sheepxray/1145141919810wulongjiadao/README.md

# 智能车光电象棋对抗 — 乌龙驾到（设计与开发仓库）

第十五届全国大学生光电设计竞赛 · 赛题 1

> **官方节奏（2026-10-12 校赛动员，宣讲口径）**：常规为 **3 月校赛、4 月区赛、5 月国赛**。
> 本仓库的 `09-28 -> 11-22` 是内部第一阶段和 MVP 周期，不是校赛总周期。
> 提交材料、评分和官方节点见 [20 校赛动员纪要](docs/20-竞赛校赛动员与官方节点_20261012.md)。

> 🚨 **平台已裁决（2026-09-28）**：当前方案按实际采购落实为
> **麦轮全向 + K230D + 单 OV5640 + STM32G474 + TB6612**。
> 仓库早期的「差速 + RK3588 + 双 IMX219 + H723 + BTS7960」方案已归档为下面的
> [历史五轮档案](#历史五轮档案旧平台已归档)，不再作为当前方案。

---

## 一句话方案

一台 **全向底盘（60mm 麦轮 ×4 + 4×MG513X 电机）** 智能车，前装 **盒式推板（带侧裙）**，
用 **单支 OV5640 前视相机** 做搜索与读字，由 **庐山派 Lite-K230D(128M) 视觉平台**
与 **STM32G474VET6 运动主控** 双核协同，全程自主完成
“搜索 → 识别字符 → 计算优先级 → 两段式接近 → 闭环/开环推入 → 撞墙重定位”。

---

## 关键指标（实际采购口径）

| 项目 | 当前值 | 限值 | 状态 |
|---|---|---|---|
| 实付成本 | **¥751.01** | ¥2000 | ✅ 余量 ¥1248.99 |
| 总质量 | ⚠️ 待实测（**电机已占 680 g**） | 1500 g | 🔴 逼近上限，先称重 |
| 外廓 | ⚠️ 待机械重构 | 250×200×180 | 麦轮底盘 10-14 前重定 |
| 车速 | 额定点 **0.94 m/s**（空载 1.16） | 目标 0.8 m/s | ✅ 有余量，PWM 限速 [17 校核](docs/17-实际电机参数核对.md) |

依据：[08 BOM](docs/08-BOM物料清单.md) / [16 商品清单](docs/16-最终商品清单.md) / [17 电机参数](docs/17-实际电机参数核对.md)。

---

## 近端硬节点（完整排期见 docs/10）

| 🔴 节点 | 时间 | 交付 |
|---|---|---|
| 初代底板到货 | 10-01 | 装配成可通电初代底盘 |
| 动力系统 + 视觉模块验证 | 10-07 前 | 四轮可控 + 全向移动；单相机出图 + 初始标定 |
| 第二版底盘 + 顶部相机方案 | 10-14 前 | 3D 模型 / 图纸 + 顶部相机安装方案 |

---

## 团队约束

| 约束 | 取值 |
|---|---|
| 加工条件 | 只有 3D 打印 |
| 预算 | ≤ ¥2000（实付 ¥751.01） |
| 内部 MVP 时间 | ≈ 8 周（09-28 → 11-22） |
| 官方赛事节奏 | 3 月校赛、4 月区赛、5 月国赛；具体日期以官方通知为准 |

---

## 硬件清单（已购，精简版）

| 类别 | 已购 | 备注 |
|---|---|---|
| 电机 | MG513X 12V 13 线霍尔编码器 ×4 | **1:28**，370rpm 空载 / 300rpm 额定，**0.17kg/台** |
| 驱动 | TB6612 四路带稳压（**D24A**） | ⚠️ 额定工况有余量；堵转发热是主要风险，见 17 §4.3 |
| 主控 | STM32G474VET6 | 高分辨率定时器 |
| 视觉 | 庐山派 Lite-K230D-CanMV 128M | — |
| 相机 | OV5640 自动对焦 ×1 | 仅 1 支，无下视相机 |
| 轮组 | 60mm 麦克纳姆轮 ×4 + 联轴器 | — |
| 电源 | 3S 2600mAh 锂电组 + DC-DC | 电池待发货 |

后置补购（见 [16 §3](docs/16-最终商品清单.md) / [10 §0](docs/10-开发计划与里程碑.md)）：
**激光 ≤1mW、IMU ICM-20602、下视相机**、电源保护件、结构五金。

---

## 已确认仍有效的设计结论

1. 贴墙容错窗口与**车宽无关**，只取决于“窄车体 + 宽推板 + 悬伸”
   （[00 判断三](docs/00-赛题解读与关键结论.md)）。
2. 挡板测距 `d=H·f/Δy` **不能无条件用**；俯角≠0 时误差可达 17.3% → 用完整投影数值反解
   （[00 §3](docs/00-赛题解读与关键结论.md)、`tools/geometry.py`）。
3. 读字优先级要用**期望值**而非 argmax（[15](docs/15-字符识别与优先级算法.md)）。
4. 实际硬件是 **4×MG513X（1:28）+ TB6612 四路（D24A）**，车速 0.94 m/s 高于 0.8 m/s 目标；
   **最大风险是四路堵转把 TB6612 推到热保护**（3.2 A 档两片合计 20.5 W），
   处置是堵转降 PWM/限流（[17](docs/17-实际电机参数核对.md) §4.3）。

---

## 历史五轮档案（旧平台，已归档）

| 轮次 | 主题 | 核心发现 | 当前状态 |
|---|---|---|---|
| 1 | [06 电源与电流](docs/06-电源系统.md) | 旧电机堵转 86s 烧毁，需限流 | ⚠️ 电机参数已换，见 17 |
| 2 | [13 主控与算力](docs/13-主控与算力平台.md) | 瓶颈在视觉平台 CPU（非 NPU） | 🗄️ 旧平台 RK3588 |
| 3 | [14 1080p 视觉](docs/14-1080p视觉管线.md) | 降采样用 RGA 硬件 | 🗄️ 旧平台 |
| 4 | [15 字符识别](docs/15-字符识别与优先级算法.md) | 用期望值而非 argmax | ✅ 方法仍有效 |
| 5 | [16 最终清单（已修订）](docs/16-最终商品清单.md) | 相机立柱总高漏算 | ✅ 现为实际采购口径 |

---

## 文档索引

| 文档 | 内容 | 状态 |
|---|---|---|
| [00 赛题解读](docs/00-赛题解读与关键结论.md) | 规则拆解、硬约束、几何结论 | ✅ 判断二已裁决为麦轮 |
| [01 总体方案](docs/01-总体方案.md) | 系统架构、选型论证 | 🗄️ 旧平台，需回写 |
| [02 机械系统](docs/02-机械系统设计.md) | 车架、推板、相机立柱 | 🗄️ 旧平台，10-14 回写 |
| [03 电控与驱动](docs/03-电控与驱动系统.md) | 主控、电机、驱动、控制环 | 🗄️ 旧选型 |
| [04 视觉识别](docs/04-视觉识别系统.md) | 相机选型、颜色预筛、CNN | 🗄️ 旧平台 |
| [05 定位导航](docs/05-定位与导航.md) | 投影几何、分层定位 | 🗄️ 部分结论仍有效 |
| [06 电源系统](docs/06-电源系统.md) | R1 电流预算、堵转限流 | 🗄️ 被 17 取代 |
| [07 软件架构](docs/07-软件架构与决策策略.md) | 状态机、打分函数 | ✅ 平台无关，基本沿用 |
| [08 BOM](docs/08-BOM物料清单.md) | 实际采购清单 | ✅ 当前权威 |
| [09 待确认与风险](docs/09-待确认事项与风险.md) | 规则模糊点、Q1–Q10 | ✅ 开工前必读 |
| [10 开发计划](docs/10-开发计划与里程碑.md) | 8 周排期、三节点 | ✅ 当前权威 |
| [11 通信协议](docs/11-通信协议.md) | K230↔STM32 帧格式 | ✅ 骨架沿用，硬件名按 kit |
| [12 帧率与实时性](docs/12-帧率与实时性.md) | 30 FPS 方法论 | 🗄️ 部分被 14 取代 |
| [13 主控算力](docs/13-主控与算力平台.md) | R2 CPU vs NPU | 🗄️ 旧平台 |
| [14 1080p 管线](docs/14-1080p视觉管线.md) | R3 视觉管线 | 🗄️ 旧平台 |
| [15 字符识别](docs/15-字符识别与优先级算法.md) | R4 期望值优先级 | ⚠️ 方法仍有效 |
| [16 商品清单](docs/16-最终商品清单.md) | 实际下单 + 历史差异 | ✅ 当前权威 |
| [17 电机参数](docs/17-实际电机参数核对.md) | MG513X + TB6612 参数核对与风险 | ✅ 当前权威 |
| [TB6612/MG513X 规格](../hardware/electrical/TB6612_MG513X_规格.md) | 驱动与电机规格（唯一权威口径） | ✅ 当前权威 |
| [18 采购记录](docs/18-采购记录_20260928.md) | 淘宝采购流水 | ✅ 当前 |
| [19 比赛完整算法方案](docs/19-比赛完整算法方案.md) | 感知、控制、决策与固件落地 | ✅ 当前 |
| [20 校赛动员纪要](docs/20-竞赛校赛动员与官方节点_20261012.md) | 官方节点、提交材料、评分与扣分项 | ✅ 2026-10-12 新增 |
| [tools/](tools/) | 校核脚本（可运行） | — |
| [hardware/](hardware/) | 模型、接口定义 | — |
| [firmware/](firmware/) | 主控/视觉端代码 | — |

---

## 在线文档站点

文档已做成静态站点，由 GitHub Actions 自动构建部署。

> ⚠️ 站点首次发布前仍须**手动启用 Pages**：`Settings → Pages → Source 选 GitHub Actions`。
> 启用后重跑 workflow（或再 push 一次）即可。

启用后的访问地址：**https://sheepxray.github.io/1145141919810wulongjiadao/**

本地构建与预览：

```bash
python tools/build_site.py            # 构建到 site/
python tools/build_site.py --serve    # 构建并本地预览
python tools/build_site.py --check    # 只做校验（链接 + 内容完整性）
```

站点共 **25 个页面**（21 篇文档 + 首页 + 工具页 + 2 个器件资料页）。

---

## 工具（可运行，带自测）

```bash
python tools/drive_check.py           # ★ 驱动校核：4×MG513X + TB6612（权威）
python tools/motor_consistency.py     # ★ 手册参数一致性核对（线性模型）
python tools/power_budget.py          # 电源/电流/堵转/限流（旧 2 电机差速，历史档案）
python tools/compute_budget.py        # 主控算力（第 2 轮，旧平台）
python tools/vision_pipeline.py       # 1080p 管线（第 3 轮，旧平台）
python tools/piece_value.py           # 期望值/优先级（方法仍有效）
python tools/sketchup_model.py        # 差速底盘 SketchUp 生成器（麦轮模型待 10-14 重建）
python tools/geometry.py              # 相机几何校核（判断三、测距）
python tools/mass_budget.py           # 质量与预算（实际采购后需用 16 重算）
python tools/framerate.py             # 帧率方法论
python tools/protocol.py              # 通信协议 + 自测
python firmware/stm32/reference/kinematics.py   # 运动学/PID/航迹推算
python firmware/stm32/reference/scoring.py      # 目标打分函数
```

---

## 立刻要做的三件事

1. **10-01 初代底板到货** → 开箱核检（孔位/平整度）+ 装配成可通电底盘（[10 §2.1](docs/10-开发计划与里程碑.md)）。
2. **10-07 前** 动力系统验证 + 视觉模块验证（[10 §2.2/2.3](docs/10-开发计划与里程碑.md)）。
3. **10-14 前** 第二版底盘设计 + 顶部摄像机模块放置方案（[10 §2.4](docs/10-开发计划与里程碑.md)）。

> 规则模糊点 [09 待确认](docs/09-待确认事项与风险.md) 中 **Q1 / Q2 / Q9** 仍须优先书面确认。

---

## 状态

- [x] 平台裁决完成：采纳实际 kit（麦轮 + K230D + 单 OV5640 + G474 + TB6612）
- [x] 开发计划三家节点写入 [docs/10](docs/10-开发计划与里程碑.md)
- [x] 2026-10-12 校赛动员材料已归档，官方节点、提交材料和评分要求写入 [docs/20](docs/20-竞赛校赛动员与官方节点_20261012.md)
- [x] README 与 docs/00–15 已按实际方案统一（旧平台标注为历史档案）
- [x] 实际采购清单与采购记录（[16](docs/16-最终商品清单.md) / [18](docs/18-采购记录_20260928.md)）
- [ ] 10-01 初代底板到货核检
- [ ] 10-07 前动力系统验证 + 视觉模块验证
- [ ] 10-14 前第二版底盘设计 + 顶部相机方案
- [ ] 规则模糊点闭环（09 Q1/Q2/Q9）
- [ ] 激光/IMU/下视相机按判据补购

---

## 提交历史

```
第1轮：电源与电流预算（电源先行）
第2轮：主控与算力平台（诊断瓶颈在CPU侧而非NPU侧）
第3轮：1080p@30 视觉管线
第4轮：字符识别与优先级算法
第5轮：SketchUp 模型 + 最终商品清单
2026-09-28：实际采购平台分叉（麦轮+K230D vs 差速+RK3588）
2026-09-28：平台裁决 + README/文档统一为实际 kit 方案
