sheepxray/1145141919810wulongjiadao/hardware/electrical/TB6612_MG513X_规格.md

# TB6612 四路驱动（D24A）× MG513X 电机 · 规格与核对

> **本文是这两种器件的唯一权威口径。** docs/03、docs/06、docs/17、
> `hardware/electrical/接口定义.md` 全部引用本文，不再各自维护参数副本。
>
> **资料来源**（三类，优先级从高到低）：
> 1. **官方原理图** `TB6612四路驱动稳压模块原理图_V1.1（D24A）.pdf`（WHEELTEC，2025-02-18 版）
> 2. **芯片原厂手册** `TB6612FNG芯片手册.pdf` / `RT8279.PDF` / `RT9013-33GB.PDF`
> 3. **随货手册 + 商品页截图**（数值口径，未经原理图交叉验证）
>
> **本地存档**（第三方资料，**不入 git**；路径相对**工作区根目录** `乌龙驾到\`）：
> - 资料包：`_本地存档_不入库\WHEELTEC_TB6612_资料_V3.2_2026.07.25\`
>   （原始 50 个文件 1.78 GB；已跳过 3 个视频共 1.66 GB，保留 47 个文件 120.8 MB）
> - 原始来源：`D:\BaiduNetdiskDownload\【WHEELTEC】TB6612电机驱动附送资料\..._V3.2_2026.07.25\`

---

## 0. 一句话结论

> **驱动：TB6612FNG 四路带稳压板 D24A（V1.1）。电机：MG513X 12V / 1:28 / 370rpm 空载。**
>
> - 车速：空载 **1.16 m/s**、额定点 **0.94 m/s**（60mm 麦轮），**比原 0.8 m/s 目标快约 18%**，
>   靠 PWM 限速即可，不是问题。
> - ⚠️ **最大的风险是「四路堵转把 TB6612 烧/热保护」** —— 3.2 A 读法下两片合计 **20.5 W**，
>   SOP24 封装不可能长期承受。板载 65 °C 保护只关 RT8279 那两路**对外实验电源**，
>   **不影响** STM32 / K230D 的供电轨（见 §4.3）。
> - ⚠️ **手册参数自身不自洽**（3.2A 堵转 ↔ 4.5 kgf·cm 堵转转矩差 2.2 倍），
>   必须实测定论。见 §3。

---

## 1. 电机 MG513X

### 1.1 权威参数（商品页）

| 项目 | **MG513X（本次采购）** | MG513XL（对照，未采购） |
|---|---|---|
| 编码器 | 霍尔编码器（高精度 GMR 可选） | 同左 |
| 减速比 | **1:28** | 1:28 |
| 额定电压 | **12 V** | 12 V |
| 额定电流 | **0.36 A** | 1 A |
| 堵转电流 | **3.2 A** ⚠️ 见 §3 | 6 A |
| 减速后空载转速 | **370 ± 12 rpm** | 同左 |
| 减速后额定转速 | **300 ± 12 rpm** | 同左 |
| 额定扭矩 | **1 kgf·cm** | 3 kgf·cm |
| 堵转扭矩 | **4.5 kgf·cm** ⚠️ 见 §3 | 15.4 kgf·cm |
| 功率 | **4 W** | 10 W |
| 重量 | **0.17 kg**（×4 = **0.68 kg**！） | 0.19 kg |

> ⚠️ **重量是最容易被忽略的一项**：4 台电机 = **680 g**，
> 而整车质量上限是 1500 g。电机一项就吃掉 **45%** 的质量预算，
> 见 [docs/16](../docs/16-最终商品清单.md) 质量表。

### 1.2 编码器与测速分辨率

| 项目 | 数值 | 来源 |
|---|---|---|
| 线数 | 13 线/相（采购记录口径） | 采购记录，**待实物确认** |
| 每输出轴转脉冲数（单相） | 13 × 28 = **364 P/r** | 计算 |
| 四倍频计数 | **1456 count/r** | 计算 |
| 距离分辨率（60mm 轮） | **0.129 mm/count** | 计算 |
| 单相脉冲频率 @370rpm | **2245 Hz** | 计算 |
| 四倍频频率 @370rpm | **8979 Hz** | 计算 |

> STM32G474 的 TIM 编码器模式 + 32 位计数器处理 9 kHz 毫无压力。
> 编码器供电 3.3–5 V，**上电前先用万用表确认 VCC/GND 线序**。

### 1.3 车速与负载能力（60mm 麦轮）

轮周长 = π × 0.060 = **0.1885 m**

| 状态 | 转速 | 单轮线速度 | 整车直行速度 |
|---|---|---|---|
| 空载 | 370 rpm | 1.162 m/s | **≈1.16 m/s** |
| 额定点 | 300 rpm | 0.942 m/s | **≈0.94 m/s** |

| 项目 | 每轮 | 四轮合计 |
|---|---|---|
| 额定扭矩 1 kgf·cm | 0.0981 N·m → 牵引力 3.27 N | **13.1 N**（1.5kg → 8.7 m/s²） |
| 堵转扭矩 4.5 kgf·cm | 0.441 N·m → 牵引力 14.7 N | **58.8 N** |
| 额定电流 0.36 A | 4.3 W | 1.44 A / **17.3 W** |
| 堵转电流 3.2 A | 38.4 W | 12.8 A / **153.6 W** |

> **牵引力远超需求**（平地 1.5kg 匀速只需不到 1 N）。
> 真正的限制是**摩擦极限**：四轮合计 58.8 N 远超轮胎抓地力，
> 所以正常工况下轮子会先打滑，而不是电机先堵转 —— 除非顶墙。

---

## 2. 驱动 TB6612 四路带稳压版（D24A）

### 2.1 权威参数

| 项目 | 数值 | 来源 |
|---|---|---|
| 产品型号 | **D24A**（四路带稳压）/ D153C（双路） | 商品页 |
| 尺寸 / 重量 | 50 × 50 mm / 19 g（含排针） | 商品页 |
| 驱动路数 | **4 路**（板载 **2 片 TB6612FNG**，每片 2 路） | 原理图 U8 / U2 |
| 单路持续电流 | **1.2 A** | 芯片手册 IOUT = 1.2 A (ave) |
| 单路峰值电流 | **3.2 A**（不可持续） | 芯片手册 IOUT = 3.2 A (peak) |
| VM 工作范围 | **2.5 – 13.5 V**（绝对最大 15 V） | 芯片手册 Recommended / Abs Max |
| 逻辑控制电压 | 3.3 – 5 V | 商品页 + 手册 |
| 控制信号 | **1 路 PWM + 2 路普通 IO / 电机** | 商品页 |
| PWM 频率 | 0 – 100 kHz（推荐 **10 kHz**） | 商品页 + 手册 |
| 输出低导通电阻 | 0.5 Ω（上下桥合计，典型 @VM≥5V） | 芯片手册 |
| 板载 5V 轨 | **RT8279**：5 A / 36 V / 500 kHz 同步降压 | 原理图 U1 + RT8279 手册 |
| 板载 3.3V 轨 | **RT9013-33GB**：500 mA LDO（5V→3.3V） | 原理图 U4 + RT9013 手册 |
| 对外供电能力 | 3.3 V（500 mA）、5 V（长时间 3 A / 瞬间 5 A） | 商品页 |
| 过温保护 | **整板 65 °C** 关断 RT8279 的使能 → 板载 5V/3.3V **对外输出**失电，冷却后恢复（不切 VM） | 原理图 + 手册 §2.3 |
| 电池电压采样 | 10k / 1k 分压 = **1/11**，可接 ADC | 手册 §2.3 + 原理图 R13/R15 |
| 保护（V1.1） | 反接保护（AP20P30Q）、输入 TVS（SMAJ15A）、3.3V TVS（SMBJ3.3A）、5V TVS（SMBJ5.0A）、控制信号 22 Ω 串阻 | 原理图 V1.1 |

> ⚠️ **反接保护存在版本差异**：原理图 **V1.1 有**反接保护电路（Q5 AP20P30Q），
> 但**随货手册仍写「本模块无防反接，反接必烧芯片」**——该手册是 V1.0 口径。
> 商品页列出的保护项含「输入电源防反接保护」，与 V1.1 一致。
> **以实物丝印为准**：板上有 "1.1" 丝印 = V1.1。核对方法见资料包
> `5.原理图\3.D24A四路驱动稳压模块\不同版本D24A区分方法.png`。
> ⚠️ **无论哪个版本，接线前一律断电。**

### 2.2 引脚与接线（D24A → STM32G474）

| 信号组 | 板端引脚 | 说明 |
|---|---|---|
| 使能 | `STBY` | **必须接 3.3V 或 5V**（板上可用跳线帽接 3V3），否则电机不转 |
| A 路 | `PWMA` / `AIN1` / `AIN2` | 1 路 PWM + 2 路 IO |
| B 路 | `PWMB` / `BIN1` / `BIN2` | 同上 |
| C 路 | `PWMC` / `CIN1` / `CIN2` | 同上 |
| D 路 | `PWMD` / `DIN1` / `DIN2` | 同上 |
| A 编码器 | `E1A` / `E1B` | 接 STM32 定时器编码器模式 |
| B 编码器 | `E2A` / `E2B` | 同上 |
| C 编码器 | `E3A` / `E3B` | 同上 |
| D 编码器 | `E4A` / `E4B` | 同上 |
| 电池电压 | `ADC` | 板内已 1/11 分压，直连 ADC 引脚即可 |
| 电源 | `Vin+` / `-`（J8） | **4.5–15 V**，本次用 3S（满电 12.6 V） |

> ✅ **2026-10-17 逐轮复核**：C、D 两路的电机插头与轮位**一一对应**
> （C 座接右后轮、D 座接右前轮）。2026-10-16 曾据编码器符号推断两者互换并让固件
> 对调，2026-10-17 用逐轮点动目视复核后**已撤销**，上表的对应关系现在与实物一致。
> 详见 [引脚分配表.md](../../firmware/stm32/wulong_fw/docs/引脚分配表.md)。

**真值表**（单路，来自芯片手册）：

| PWM | IN1 | IN2 | 结果 |
|---|---|---|---|
| 1 | 0 | 0 | 制动停止 |
| 1 | 1 | 0 | 正转 |
| 1 | 0 | 1 | 反转 |
| 1 | 1 | 1 | 制动停止 |
| 0 | × | × | 停止（滑行） |

### 2.3 板载电源树（原理图实测）

```
3S 电池 (Vin+ , J8)
  └─[电源开关 SW1]
     └─[反接保护 Q5 AP20P30Q]─[TVS SMAJ15A D5 / D4]
        ├─→ 电机 VM（2 片 TB6612FNG 的 VM1/VM2/VM3）
        │
        └─[RT8279 降压]─→ 5V 轨（板载 220µF ×2 输出储能）
             ├─→ 5V 对外输出（J1）
             ├─→ ★ 两片 TB6612FNG 的 VCC(20) 逻辑供电
             └─[RT9013 LDO]─→ 3.3V 轨（1µF/1µF）→ 3.3V 对外输出（J3）
```

> ⚠️ **与既有文档的口径差异**：docs/06 与 [接口定义](接口定义.md) 的三轨设计是
> **「动力直供 + 独立视觉 buck + 独立逻辑 DC-DC」**。
> D24A 额外提供 **5V（RT8279，5 A）与 3.3V（RT9013 LDO，500 mA）** 两路对外输出
> —— 那是**给用户做实验用的额外电源**，**不要求**用它给主控/视觉供电。
> 本项目按原三轨设计：**视觉走独立 buck，逻辑用 D24A 板载 3.3V**（见 §6.1）。

---

## 3. ★ 手册自身不自洽：必须实测定论

用直流电机线性模型（Kt = Ke）核对手册：

| 取信的一组 | 推算结果 | 与手册冲突 |
|---|---|---|
| 额定 300 rpm / 1 kgf·cm / 0.36 A（含 I₀=30 mA） | 空载 **386 rpm**、额定 **294 rpm**、绕组 **7.9 Ω**、堵转 **1.51 A** | 手册堵转电流写 **3.2 A**（差 **2.1×**） |
| 堵转转矩 4.5 kgf·cm + 堵转电流 3.2 A | Kt = 0.139 N·m/A、绕组 3.75 Ω → 空载转速应为 **823 rpm** | 手册空载写 **370 rpm**（差 **2.2×**） |

**结论**：`额定点三参数（300rpm / 1 kgf·cm / 0.36A）自洽`（功率 3.1 W ↔ 标称 4 W ✅），
**冲突集中在「堵转电流 3.2 A」与「堵转转矩 4.5 kgf·cm」二者不能同时成立。**

### 30 秒实测定论（替代旧 Q10）

以**保守侧（3.2 A）**做驱动余量设计，但必须实测：

1. **万用表量绕组电阻**（转子转多点取平均，避开换向器死区）
   - ≈ **7.9 Ω** → 堵转 ≈ **1.5 A**（读法 A）
   - ≈ 3.75 Ω → 堵转 ≈ 3.2 A（读法 B）
2. **堵转实测电流**：电源限流到 4 A，堵转读电流表，同时贴热电偶看温升。

> 不论哪个读法，**堵转电流都 > TB6612 持续 1.2 A**（读法 A 约 1.3 倍，读法 B 约 2.7 倍），
> 所以**堵转保护都必须做**。结论不被读数影响，只是保护阈值不同。

---

## 4. ★ 驱动裕度与热：D24A 的真实风险

### 4.1 电流裕度

| 工况 | 单路电流 | vs 持续 1.2 A | vs 峰值 3.2 A |
|---|---|---|---|
| 额定（四轮直行） | 0.36 A | ✅ 3.3× 余量 | ✅ |
| 加速/爬坡 | 0.5–1.0 A | ✅ | ✅ |
| 顶墙/顶棋子（堵转·读法 A） | ≈1.5 A | ⚠️ **超持续，未超峰值** | ✅ |
| 顶墙/顶棋子（堵转·读法 B） | 3.2 A | ❌ **超持续 2.7×** | ⚠️ **恰好顶到峰值** |

**四路同时堵转（最坏）**：读法 A ≈ **6.0 A / 72 W**，读法 B ≈ **12.8 A / 154 W**。

### 4.2 芯片自身发热

TB6612FNG 上下桥合计 RDS(on) ≈ 0.5 Ω，发热 = I²R：

| 单路电流 | 每路发热 | 每片芯片（2 路） | 两片合计 |
|---|---|---|---|
| 0.36 A（额定） | 0.065 W | 0.13 W | 0.26 W |
| 1.2 A（持续上限） | 0.72 W | 1.44 W | 2.88 W |
| 1.51 A（堵转·读法 A） | 1.14 W | 2.28 W | **4.56 W** |
| 3.2 A（堵转读法 B） | 5.12 W | 10.24 W | **20.5 W** |

> TB6612FNG 是 **SOP24 无散热焊盘**封装，靠引线散热。
> **7 W 以上不可能长期承受** → 会触发 **TB6612FNG 芯片自身的过温保护（TSD）**。

### 4.3 ★ 过温保护的**真实**作用范围（已核对原理图，修正早前的错误判断）

> 早前把这条写成「过温保护会切断 5V/3.3V 轨，连坐主控与视觉」——**这是错的**。
> 核对原理图后确认：**过温保护切断的是 RT8279 的使能，只关断板载 5V/3.3V
> 这两路「对外实验电源」，不会去切断 STM32 或 K230D 的供电轨。**

**原理图依据**：过温网络 `R3(6.8 kΩ NTC) + R4(10 k) + R5(0 Ω)` 生成 `P_EN`，
只接到 **RT8279(U1) 的 EN 脚**；RT9013(U4) 因 VIN 来自 5V，也随之失电。
两片 TB6612FNG 的 **VM（电机动力）与 VCC（内部逻辑）都不在此保护路径上**
—— VCC 直接取自 5V 输出节点。

**真正需要关心的失效模式是另一个**：

```
四路电机长时间堵转（顶墙推棋子）
   → 两片 TB6612FNG 发热（20.5 W @3.2 A/路）→ 芯片自身过温保护(TSD)
   → 若 VCC 那一路 5V 被 RT8279 过温关断（P_EN 拉低）
   → TB6612FNG 失去内部逻辑供电 → 输出级关断
   → 四轮同时失控滑行
```

> **关键结论**：风险从「主控/视觉被断电」变成「**TB6612 逻辑掉电导致输出关断**」，
> 两者都要求**堵转时必须压住发热**（堵转降 PWM / 限流）。
> 但**不需要**为了这条保护去改视觉供电 —— 视觉独立 buck 本来就与它无关。

---

## 5. 与既有文档的口径差异（需回写）

| 项目 | 旧口径 | **新口径（本文）** |
|---|---|---|
| 电机型号 | JGB37-520（差速，2 台） | **MG513X（麦轮，4 台）** |
| 减速比 | 1:100（docs/17 曾记） | **1:28** |
| 空载/额定转速 | 300 / 240 rpm | **370 / 300 rpm** |
| 额定/堵转电流 | 200 mA / 500 mA | **360 mA / 3.2 A（待实测）** |
| 额定/堵转转矩 | 0.5 / 4.0 kgf·cm | **1 / 4.5 kgf·cm** |
| 驱动 | BTS7960 ×2（43 A） | **TB6612FNG 四路 D24A（1.2 A / 3.2 A）** |
| 轮径 | φ65 橡胶轮 | **φ60 麦轮** |
| 车速 | 0.817 m/s | **0.94 m/s（额定）/ 1.16 m/s（空载）** |
| 稳压架构 | 三路独立 | **5V/3.3V 同板（3.3V 由 5V LDO 派生）** |
| 电机总重 | 未计 | **0.68 kg** |
| 过温保护 | 未考虑 | **65 °C 只关 RT8279 的 5V/3.3V 对外输出**（不切 VM / 不切 VCC 直连节点） |

---

## 6. 设计处置（待落到 docs/03、06、接口定义）

### 6.1 必须做（🔴）

1. **堵转保护**（软件，STM32 侧）：
   目标速度非零且实测速度 ≈ 0 持续 > 200 ms → **把 PWM 降到维持值（约 30%）**
   并上报决策层「已顶到位/受阻」。**不要直接停机**（顶墙推棋子是正常工况）。
2. **电源架构保持原设计**（已与实际接线一致，无需改动）：
   - **视觉**：K230D + 相机走**独立 buck**（与 D24A 的 RT8279 无关）
   - **逻辑**：STM32 / IMU 用 **D24A 板载 3.3V（RT9013，500 mA）**，负载仅 ≈105 mA，余量充足
   - **D24A 的 5V / 3.3V 对外输出**当作实验用备用轨，不接主控/视觉

   > 注意：过温保护只关 RT8279 的 EN，因此**视觉独立供电这条本来就不受影响**；
   > 但**逻辑轨取自 RT9013（其 VIN 来自 5V）会随之掉电** —— 若想连逻辑也免疫，
   > 可把 STM32 的 3.3V 改为**独立 LDO/buck**（可选，非必须）。
3. **控制信号 10 kHz PWM**（手册推荐值，避开音频与开关损耗区）。
4. **STBY 必须拉高**（跳线帽接 3V3 或由 STM32 GPIO 控制，推荐后者以便软急停）。

### 6.2 强烈建议（🟡）

5. **堵转限流**：如需长时间顶墙，用电流采样（INA240 或板载 VM 采样）把单路限到 ≈1.2 A。
6. **电机端子加 104 陶瓷电容**（有刷电机必做，抑制电刷噪声）—— 板上有 TVS 但没有电机端 RC。
7. **不要用满 12.6 V 长跑**：TB6612 VM 推荐上限 13.5 V，3S 满电 12.6 V 仅 0.9 V 余量；
   电机感性尖峰靠板载 TVS 吸收，但仍应避免「满电 + 四路同时换向」的最坏叠加。
8. **5V 带动 K230D 需实测**：板载 RT8279（5 A/500 kHz/电流模式）瞬态特性
   远好于旧文档批评的 MP1584/LM2596，**原则上可用，但要实测掉电**。

### 6.3 待实测清单（替代旧 Q10）

| # | 项目 | 方法 | 判据 |
|---|---|---|---|
| 1 | 电机绕组电阻 | 万用表，转子转多点 | **7.9 Ω 或 3.75 Ω** |
| 2 | 真实堵转电流 | 电源限流 4 A + 堵转 | 记录稳定值 |
| 3 | 编码器线数 | 输出轴手转 1 圈，数单相脉冲 | 应为 364 P/r |
| 4 | 驱动板温升 | 四路 1.2 A 连续 3 min，热电偶贴 TB6612 | 是否触碰 65°C |
| 5 | 板级保护行为 | 人为升温至 65 °C 以上 | 确认 **RT8279 的 5V/3.3V 对外输出**是否切断（不应影响 VM） |
| 6 | 5V 带 K230D | K230D 满载 + 电机换向 | 是否 brownout |
| 7 | 驱动板版本 | 看板上 "1.1" 丝印 | 决定有无反接保护 |

---

## 7. 资料索引

> 下表路径相对**工作区根目录** `C:\Users\sheep\Desktop\乌龙驾到\`（**不是**仓库目录）。

| 内容 | 本地路径 |
|---|---|
| 官方资料包（V3.2） | `_本地存档_不入库\WHEELTEC_TB6612_资料_V3.2_2026.07.25\` |
| D24A 原理图 V1.1 | `...\5.原理图\3.D24A四路驱动稳压模块\2.TB6612四路驱动稳压模块原理图_V1.1（D24A）.pdf` |
| 用户手册（含接线表） | `...\1.用户手册与使用教程\电机驱动模块使用手册—TB6612(2025.08.27).pdf` |
| 随货安全手册 | `...\TB6612稳压版随货手册.pdf` |
| 芯片手册 | `...\6.芯片手册\TB6612FNG芯片手册.pdf`、`RT8279.PDF`、`RT9013-33GB.PDF` |
| 接线图（四路 + 编码器） | `...\4.例程源码\1.STM32F1例程\3.D24A（四路驱动带稳压版）例程\D24A模块与STM32F103RCT6核心板接线说明.png` |
| STM32 例程（HAL + 标准库） | `...\4.例程源码\1.STM32F1例程\3.D24A（四路驱动带稳压版）例程\*.zip`（F1 平台，仅供移植参考） |
| 3D 模型（STP） | `...\7.3D模型\TB6612四路驱动稳压模块（D24A).stp` |
| 嘉立创封装 | `...\5.原理图\4.封装文件\D24A封装_2026-07-25.json` |
