sheepxray/1145141919810wulongjiadao/hardware/electrical/接口定义.md

# 电气接口定义

> ✅ **2026-09-28 重写**：按**实际到手硬件**改为
> **4×MG513X + TB6612 四路带稳压板（D24A）+ STM32G474VET6**。
> 电机/驱动参数权威口径见 [TB6612_MG513X_规格.md](TB6612_MG513X_规格.md)，
> 风险分析见 [docs/17](../../docs/17-实际电机参数核对.md)。
> ⚠️ **画完原理图必须用 STM32CubeMX 的引脚检查跑一遍** —— 4 路电机 + 4 路编码器极易冲突。

---

## 1. 连接器总览

| 连接器 | 类型 | 连接 | 线规 |
|---|---|---|---|
| J1 | XT60 | 3S 电池 → 主配电 | 18 AWG |
| J2 | 2P 螺丝端子 | D24A `Vin+ / -` → 主配电 | 18 AWG |
| J3 | 4P（板载） | 电机 A（Motor_A） | 20 AWG |
| J4 | 4P（板载） | 电机 B（Motor_B） | 20 AWG |
| J5 | 4P（板载） | 电机 C（Motor_C） | 20 AWG |
| J6 | 4P（板载） | 电机 D（Motor_D） | 20 AWG |
| J7 | 6P 排针（板载 J4/J6） | 电机 A/B 的编码器 + 控制信号 | 26 AWG |
| J8 | 6P 排针（板载 J4/J6） | 电机 C/D 的编码器 + 控制信号 | 26 AWG |
| J9 | 4P JST-XH | K230 → STM32 (UART) | 26 AWG |
| J10 | 8P JST-XH | IMU (SPI2) → STM32 | 26 AWG |
| J11 | 4P JST-XH | 调试串口 (USART1) | 26 AWG |
| J12 | 2P JST-XH | 相机 → K230 | 排线 |
| J13 | 3P JST-XH | 激光模组 | 26 AWG |

> **D24A 板载端子**（不需要自己做）：`Vin+/-`（J8）、4 组电机接口
> （每组 6P：2 路电机线 + 4 路编码器/控制）、`5V`/`3.3V`/`GND` 对外排针、
> `ADC` 电池电压输出。

> ✅ **2026-10-17 逐轮复核：座序与轮位一一对应。**
> 2026-10-16 曾根据"编码器符号翻转"推断 C、D 两个电机插头互换，并让固件把这两路
> 整体对调；2026-10-17 用**逐轮点动、目视哪一个角在转**的方法直接复核，证明那次
> 推断有误，固件里的对调**已撤销**。现在软件侧 `A=左前 B=左后 C=右后 D=右前`
> 与实物一一对应。完整对照表见
> [引脚分配表.md](../../firmware/stm32/wulong_fw/docs/引脚分配表.md) 的
> 「电机 / 编码器实际座序」。
>
> 重新插拔过电机线、或换过驱动板之后，必须用
> [电机Bring-up测试.md](../../firmware/stm32/wulong_fw/docs/电机Bring-up测试.md)
> **逐轮点动 + 目视**核对轮位——**编码器符号自洽不能替代目视**（方向线取反会同时
> 翻转电机极性和计数符号，两种设置都自洽）。
>
> 发现某轮"符号正常但实际倒转"时，用 `FLIP <轮号>` 整轮翻转（同时反方向线 + 反编码器），
> 详见该文档 §5.14。

---

## 2. STM32G474 引脚分配

> ✅ **2026-09-29 已用 CubeMX 校验**，与已编译通过的固件工程
> [`firmware/stm32/wulong_fw/`](../../firmware/stm32/wulong_fw/) 完全对齐。
> 权威口径见
> [STM32G474_TB6612_引脚规划.md](../../firmware/stm32/docs/STM32G474_TB6612_引脚规划.md)
> 与固件导出的 [引脚分配表.md](../../firmware/stm32/wulong_fw/docs/引脚分配表.md)。

### 2.1 电机驱动（D24A）

| 信号 | 引脚 | 外设 | 说明 |
|---|---|---|---|
| PWMA | PA8 | TIM1_CH1 | **10 kHz** |
| PWMB | PA9 | TIM1_CH2 | 10 kHz |
| PWMC | PA10 | TIM1_CH3 | 10 kHz ⚠️ |
| PWMD | PA11 | TIM1_CH4 | 10 kHz ⚠️ |
| AIN1 / AIN2 | PB0 / PB1 | GPIO | 方向 |
| BIN1 / BIN2 | **PE4 / PE5** | GPIO | 方向（PC4/PC5 已让位给调试串口） |
| CIN1 / CIN2 | PB10 / PB11 | GPIO | 方向 |
| DIN1 / DIN2 | PD2 / PC12 | GPIO | 方向 |
| **STBY** | PC6 | GPIO | **高电平使能；★ 软急停** |

> **STBY 必须为高**，否则 4 路全部不转。**推荐由 GPIO 控制**（而不是跳线帽常高），
> 这样堵转保护/急停能真正切断输出。

### 2.2 编码器（4 路正交解码）

| 信号 | 引脚 | 外设 |
|---|---|---|
| 编码器 A | PA0 / PA1 | TIM2_CH1/CH2 |
| 编码器 B | PA6 / PA7 | TIM3_CH1/CH2 |
| 编码器 C | PB6 / PB7 | TIM4_CH1/CH2 |
| 编码器 D | **PE2 / PE3** | TIM20_CH1/CH2 |

> ✅ **第 4 路已定死**：用 **TIM20（PE2/PE3，AF6）** 硬件正交解码，
> 比 GPIO 双沿中断 + 软件解码更省事也更稳。
> 注意不要用 TIM8：TIM8_CH1=PC6（已被 STBY 占用）、CH2=PC7（拨码占用）。

### 2.3 IMU（SPI2）

| 信号 | 引脚 |
|---|---|
| SCK | PB13 |
| MISO | PB14 |
| MOSI | PB15 |
| CS | PB12 |
| INT | **PB9**（原 PB3 与拨码第 4 路冲突，已改） |

> ⚠️ **修正记录**：原设计把 IMU 放在 SPI1（PA5/PA6/PA7），
> 但 **PA6/PA7 与 TIM3 编码器引脚冲突**。已改到 SPI2。

### 2.4 通信

| 信号 | 引脚 | 外设 | 说明 |
|---|---|---|---|
| K230 UART TX | PA2 | USART2_TX | 921600 |
| K230 UART RX | PA3 | USART2_RX | |
| 调试 TX | **PC4** | USART1_TX | **有线**，禁无线（原写 PA14，实为 SWCLK） |
| 调试 RX | **PC5** | USART1_RX | （原写 PA15） |

### 2.5 人机与监测

| 信号 | 引脚 | 说明 |
|---|---|---|
| 拨码开关 ×4 | PB4 / PB5 / PC7 / PB3 | 队伍编号 / 球门侧配置（DIP1-4） |
| 自检 LED | PC13 | 状态指示 |
| 蜂鸣器 | PB8 | 故障报警 |
| 电池电压 | PA4 | **ADC2_IN17** ← 接 D24A 的 `ADC` 引脚（板内已 1/11 分压） |
| SWD | PA13 / PA14 | 下载调试 |

> ⚠️ **电池采样接线变了**：D24A 板载 **10k/1k = 1/11 分压**，
> 直接接 STM32 的 ADC 引脚即可，**不需要**再自己搭分压网络。
> 量程：12.6 V → 1.15 V；9.0 V → 0.82 V。
> 若嫌 ADC 分辨率不足，可改用内部参考或自行加分压（但要复核耐压）。

---

## 3. 电源架构（★ 已按 D24A 实际情况修正）

### 3.1 三轨（保持原设计，与 D24A 的对外输出无关）

```
3S 电池 (XT60)
  ├─[主保险丝 15A，待实测]→ D24A Vin+  ─┬─ 4× MG513X 电机（VM）
  │                                     ├─ RT8279 → 5V ─┬─ TB6612FNG ×2 的 VCC(20)
  │                                     │               └─ RT9013 → 3.3V 对外（实验/备用）
  │
  └────────────────────→ 独立 DC-DC 5V ≥3A ── K230D + OV5640
```

| 轨 | 模块 | 输出 | 供给 |
|---|---|---|---|
| 动力 | 直供 | 11.1–12.6 V | D24A VM → 4 电机 |
| **视觉** | **独立 DC-DC** | **5 V ≥3 A** | **K230D、相机** |
| 逻辑 | D24A 板载 RT9013 | 3.3 V ≤500 mA | STM32、IMU、拨码 |

### 3.2 过温保护的实际作用范围（已核对原理图）

> 过温网络 `R3(6.8 kΩ NTC) + R4 + R5(0 Ω)` → `P_EN` → **只接 RT8279(U1) 的 EN 脚**。

**它关断的是 D24A 自己那两路「对外实验电源」（5V 及其派生的 3.3V），
不会去切断 VM（电机动力），也不会切断 K230D 的独立供电轨。**

```
四路电机长时间堵转 → 驱动板升温 → P_EN 拉低
  → RT8279 停止 → 板载 5V/3.3V 对外输出失电
  → ⚠️ 连带影响：TB6612FNG 的 VCC(20) 也取自这路 5V
     → 芯片失去内部逻辑供电 → 输出级关断 → 四轮失控滑行
  → 但 K230D（独立 buck）与视觉链路**不受影响**
```

> **结论**：视觉独立供电与这条保护**本来就无关**，无需为此改动；
> 真正的风险是 **TB6612 的 VCC 依赖板载 5V**，以及**堵转发热**本身。
> 处置仍是**堵转降 PWM / 限流**（见 [docs/03 §5](../../docs/03-电控与驱动系统.md)）。
> 可选加强项：把逻辑 3.3V 改为独立 LDO/buck，使 STM32 也完全免疫。

### 3.3 3.3V 轨的容量核对

| 负载 | 电流 |
|---|---|
| STM32G474 核心板 | ~80 mA |
| ICM-20602 IMU | ~5 mA |
| 拨码 / LED / 蜂鸣器 | ~20 mA |
| **合计** | **≈105 mA** |

> RT9013 提供 **500 mA**，余量 4.8 倍 ✅ 充足。
> ⚠️ 但**不要**把 K230D 的 3.3V 也接上来（K230D 由独立 5V 供电）。

### 3.4 接地（单点星型）

```
        ┌──────── 电池负极（星点）────────┐
        │          │          │           │
   D24A GND   独立buck GND  STM32 GND   IMU GND
```

**四路电机堵转电流合计可达 12.8 A（保守读数 3.2 A 档）**。
地线走成菊花链会让动力电流在信号地上产生压降。

---

## 4. 必装的滤波与保护元件

| 位置 | 元件 | 作用 |
|---|---|---|
| 电池输出 | **15 A 快断保险丝**（待实测调整） | 短路保护 |
| D24A 输入 | 板载 TVS（SMAJ15A）+ 反接保护（V1.1） | ✅ 已有 |
| D24A 输出 | 板载 220 µF ×2（每片驱动） | ✅ 已有 |
| **每个电机端子** | **104 陶瓷电容** | ⚠️ **板上没有，必须自己加**（有刷电机电刷噪声） |
| 视觉 buck 输入 | 470 µF + 铁氧体磁珠 | 隔离动力噪声 |
| 视觉 buck 输出 | 220 µF + 10 µF + 100 nF | K230D 本地储能 |
| 逻辑轨 | 10 µF + 100 nF | MCU / IMU 去耦 |
| 电池电压 ADC | 100 nF | 滤 PWM 噪声 |

> ⚠️ **电机端 RC 是唯一需要自己补的滤波**：D24A 板上有 TVS 和输出电容，
> 但**没有电机端子上的 104 电容**。有刷电机的电刷噪声只能靠它压住。

---

## 5. 线序定义

### 5.1 电机接口（板载 4P，J3–J6）

| Pin | 信号 |
|---|---|
| 1 / 2 | 电机 M+ / M− |
| 3 / 4 | （不同版本可能为编码器供电，**以板载丝印为准**） |

### 5.2 编码器 + 控制信号（板载 6P，J4/J6）

| Pin | 信号（A/B 侧） | 信号（C/D 侧） |
|---|---|---|
| 1 | PWMB / PWMA | PWMD / PWMC |
| 2 | BIN2 / BIN1 | DIN2 / DIN1 |
| 3 | E2B / E2A | E4B / E4A |
| 4 | E1B / E1A | E3B / E3A |
| 5 | AIN2 / AIN1 | CIN2 / CIN1 |
| 6 | STBY / 3V3 | STBY / 3V3 |

> ⚠️ **上表来自 WHEELTEC 官方接线图，请对照实物丝印核对后再焊线。**
> 参考图：`_本地存档_不入库\WHEELTEC_TB6612_资料_V3.2_2026.07.25\4.例程源码\1.STM32F1例程\3.D24A（四路驱动带稳压版）例程\D24A模块与STM32F103RCT6核心板接线说明.png`
>
> ✅ **本项目的 G474 对应标注图**：[D24A_STM32G474_接线标注.png](D24A_STM32G474_接线标注.png)
> （可编辑源文件：[D24A_STM32G474_接线标注.svg](D24A_STM32G474_接线标注.svg)）。
> 官方图是 STM32F103RCT6 示例，**只能参考 D24A 端针序，不能照抄 STM32 侧引脚**。
>
> ⚠️ **STBY 跳线帽必须拔掉**：本项目用 STM32 `PC6` 控制 D24A `STBY`。
> 若仍保留官方示例中 `3V3–STBY` 的跳线帽，`PC6` 输出低电平时会与 3.3V 直接冲突。

### 5.3 编码器上电前检查

| Pin | 信号 |
|---|---|
| VCC | 3.3–5 V |
| GND | GND |
| A 相 | 编码器输入 |
| B 相 | 编码器输入 |

> **上电前先用万用表确认 VCC/GND 线序** —— 编码器反接会烧霍尔元件。
> 验证方法：给电机通电让其转动，万用表测 GND 与 A/B 相之间电压，
> 正常应为 **1.6–1.8 V 的波动**（与转速无关）。

### 5.4 K230 串口（4P）

#### 40Pin 排针（Lite-K230D 已验证）

| 物理脚 | 信号 | 接到 STM32 |
|---|---|---|
| Pin 37 | GPIO32 / UART3_TXD → | **PA3**（USART2_RX） |
| Pin 40 | GPIO33 / UART3_RXD ← | **PA2**（USART2_TX） |
| Pin 39 | GND | GND（必须共地） |
| Pin 2 / 4 / 17 | 5V0 / 3V3 | **不接**（K230D 由独立 DC-DC 供电） |

#### GH1.25-4P 座（另一种引出）

| Pin | 信号 |
|---|---|
| 1 | 5V（**不要**用来给 STM32 供电） |
| 2 | RXD ← 接 STM32 的 **PA2**（USART2_TX） |
| 3 | TXD → 接 STM32 的 **PA3**（USART2_RX） |
| 4 | GND |

> ⚠️ **线序按立创庐山派 Lite-K230D 官方定义**（GH1.25-4P 座子丝印
> `5V / RXD / TXD / GND`），**不是**早前写的 `3.3V / GND / TX / RX`。
> 官方来源：立创开发板 wiki 的引脚查询工具数据层。
>
> - 40Pin 排针默认使用 UART3 = **GPIO32(TXD) / GPIO33(RXD)**（物理 Pin 37/40）
> - UART3 TX 必须显式启用 FPIOA `oe=1`，否则引脚可能不输出
> - 40Pin UART2 备选 = **GPIO05(TXD) / GPIO06(RXD)**（物理 Pin 11/13）
> - GH1.25-4P 座的 UART2 = **GPIO11(TXD) / GPIO12(RXD)**
> - 两种引出共用 UART2 控制器，但 FPIOA 引脚不同，不能同时接不同设备
> - **UART0（GPIO38/39）被系统 RT-Smart 占用作调试台，CanMV 固件下不可用**
> - TX/RX 交叉、**共地必须接**；IO 电平 3.3V
> - K230D 由独立 DC-DC 5V 供电，两边只连 GND（见 §3.1）

### 5.5 IMU（8P）

按模块丝印定义接线；`SDA/SDI` 是模块输入，SPI 模式下接 STM32 的 MOSI：

| Pin | 模块丝印 | 接 STM32 | 说明 |
|---|---|---|---|
| 1 | VCC | 3.3V | 模块支持 3.3–5V，本项目统一用 3.3V |
| 2 | GND | GND | 必须与主控共地 |
| 3 | SCL/SPC | PB13 | SPI2_SCK |
| 4 | SDA/SDI | PB15 | SPI2_MOSI，主→从 |
| 5 | SA0/SDO | PB14 | SPI2_MISO，从→主 |
| 6 | CS | PB12 | 软件片选，拉低选中 |
| 7 | INT | PB9 | 中断，当前固件轮询读取 |
| 8 | FSY | GND | 未使用帧同步时接地，不要悬空 |

> ⚠️ `CS` 必须由上电时的 PB12 明确拉高/拉低控制；悬空可能让模块落到 I²C
> 模式。若 `WHO_AM_I`（寄存器 `0x75`）读不到 `0x12`，优先检查 `CS`、`SDO`
> 和 `FSY` 三根线。

### 5.6 激光（3P）

| Pin | 信号 |
|---|---|
| 1 | 5V |
| 2 | GND |
| 3 | 使能（可选） |

> 串联限流电阻，实测功率 **≤0.7 mW**。

---

## 6. 上电前检查清单

- [ ] 万用表测电池极性，确认无反接（⚠️ 早期版本无保护，V1.1 有）
- [ ] 确认 D24A 板版本（板上 "1.1" 丝印）
- [ ] 测板载 5V（±0.5 V）与 3.3V（±0.3 V）
- [ ] 确认 K230D 走独立 DC-DC（原设计如此，复核即可）
- [ ] 确认 4 路编码器 VCC/GND 线序
- [ ] 确认 STBY 已拉高（或已接 GPIO 并使能）
- [ ] 确认 PWM 频率设为 10 kHz
- [ ] **确认每个电机端子上焊了 104 电容**
- [ ] 确认电解电容极性
- [ ] 确认所有 GND 汇到星点
- [ ] **确认板上无任何无线模块**
- [ ] 整车称重 ≤ 1500 g（4 电机已占 680 g）
