sheepxray/1145141919810wulongjiadao/docs/03-电控与驱动系统.md

# 03 · 电控与驱动系统

> ✅ **2026-09-28 更新**：本文已按**实际到手硬件**回写：
> **麦轮全向（4×MG513X 1:28）+ STM32G474VET6 + TB6612 四路带稳压板（D24A）+ K230D + 单 OV5640**。
> 器件参数唯一权威口径见
> [hardware/electrical/TB6612_MG513X_规格.md](../hardware/electrical/TB6612_MG513X_规格.md)，
> 新旧口径差异与风险见 [docs/17](17-实际电机参数核对.md)。
> 本文保留的引脚冲突教训、控制环与堵转语义仍然有效。

---

## 1. 主控：STM32G474VET6

### 1.1 为什么是 G474

| 特性 | 对本任务的意义 |
|---|---|
| **硬件 FPU**（Cortex-M4F） | 四轮麦轮运动学 + 双环 PID + 航迹推算全用浮点 |
| 高级定时器（带死区） | 4 路 PWM（10 kHz）——本方案用有刷电机，死区留升级空间 |
| 通用/32 位定时器 | **4 路编码器正交解码** + 系统时基 |
| 12-bit ADC ×多通道 | 电池电压监测（可用驱动板板载 1/11 分压） |
| 170 MHz / 低分辨率损失 | 四路 9 kHz 编码器计数的余量很大 |

> ⚠️ **引脚资源核对**：4 路电机 = **4 PWM + 8 IO + 1 STBY**（共 13 脚），
> 4 路编码器 = **8 脚**，另有 IMU SPI（5）、K230 UART（2）、调试 UART（2）、
> 拨码（4）、LED/蜂鸣器（2）、ADC（1）。
> **本文件早期版本只规划了 2 路电机** —— 上表是旧差速方案遗留，
> 必须在 CubeMX 里按 4 路重新分配（见 §1.3）。

### 1.2 引脚分配（✅ 已经 CubeMX 校验）

> 2026-09-29：已用 CubeMX 生成并编译验证，与
> [`firmware/stm32/wulong_fw/`](../firmware/stm32/wulong_fw/) 完全对齐。

| 功能 | 引脚 | 外设 | 说明 |
|---|---|---|---|
| 电机 A PWM | PA8 | TIM1_CH1 | 10 kHz |
| 电机 B PWM | PA9 | TIM1_CH2 | 10 kHz |
| 电机 C PWM | PA10 | TIM1_CH3 | 10 kHz |
| 电机 D PWM | PA11 | TIM1_CH4 | 10 kHz |
| A 方向 | PB0 / PB1 | GPIO | AIN1 / AIN2 |
| B 方向 | **PE4 / PE5** | GPIO | BIN1 / BIN2（PC4/PC5 让位给调试串口） |
| C 方向 | PB10 / PB11 | GPIO | CIN1 / CIN2 |
| D 方向 | PD2 / PC12 | GPIO | DIN1 / DIN2 |
| **STBY 使能** | PC6 | GPIO | ★ 软急停，高电平使能 |
| 编码器 A | PA0 / PA1 | TIM2_CH1/CH2 | 正交解码 |
| 编码器 B | PA6 / PA7 | TIM3_CH1/CH2 | 正交解码 |
| 编码器 C | PB6 / PB7 | TIM4_CH1/CH2 | 正交解码 |
| 编码器 D | **PE2 / PE3** | TIM20_CH1/CH2 | 硬件正交解码 |
| IMU SPI2 | PB13/PB14/PB15 + PB12(CS) | SPI2 | ⚠️ 见 1.3 |
| K230 UART | PA2/PA3 | USART2 | 921600 |
| 调试 UART | **PC4/PC5** | USART1 | 仅有线，**禁止无线**（原写 PA14/PA15，PA14 是 SWCLK） |
| 拨码开关 | PB4 / PB5 / PC7 / PB3 | GPIO | 队伍编号/球门侧配置（DIP1-4） |
| 自检 LED | PC13 | GPIO | 状态指示 |
| 蜂鸣器 | PB8 | GPIO | 故障报警 |
| 电池电压 | PA4 | **ADC2_IN17** | 驱动板 ADC 引脚输出（已 1/11 分压） |

> ✅ **本表已用 CubeMX 校验**（2026-09-29），并据此生成编译通过的固件工程。
> 校验时发现并修正的 5 处：B 方向线 PC4/PC5 → PE4/PE5、第 4 路编码器从
> "PD12/PD13 待定" → TIM20(PE2/PE3)、调试串口 PA14/PA15 → PC4/PC5、
> 电池 ADC 外设 ADC1_IN4 → **ADC2_IN17**、IMU INT 从 PB3 让位给拨码。

### 1.3 ⚠️ 引脚冲突教训（保留）

早期版本把 IMU 放在 SPI1（PA5/PA6/PA7），与编码器 TIM3（PA6/PA7）**冲突**。

**修正**：IMU 改用 **SPI2**（PB13/PB14/PB15 + PB12 CS 控制片选）。

> 这类冲突在纸上很难看出来，**画完原理图必须用 STM32CubeMX 的引脚检查跑一遍**，
> 它会直接标红冲突。**4 路电机 + 4 路编码器会显著加剧这类冲突，务必先做引脚规划。**

---
## 2. 电机与驱动

### 2.1 电机：MG513X 12V （麦轮全向，4 台）

| 参数 | 取值 |
|---|---|
| 型号 | **MG513X** 有刷直流减速电机 |
| 额定电压 | **12 V** |
| 减速比 | **1:28** |
| 空载转速 | **370 ± 12 rpm** |
| 额定转速 | **300 ± 12 rpm** |
| 额定电流 / 堵转电流 | **0.36 A / 3.2 A**（⚠️ 堵转值待实测，见 docs/17 §3） |
| 额定转矩 / 堵转转矩 | **1 / 4.5 kgf·cm** |
| 编码器 | 霍尔，13 线/相 → **364 P/r 单相、1456 count/r 四倍频** |
| 单台重量 | **0.17 kg**（4 台 = **0.68 kg**） |

**车速核算**（φ60 麦轮，轮周长 0.1885 m）：

| 状态 | 转速 | 车速 |
|---|---|---|
| 空载 | 370 rpm | 1.16 m/s |
| 额定 | 300 rpm | **0.94 m/s** |

> 比 0.8 m/s 目标快 18%，**用 PWM 限速**，属于速度余量。

### 2.2 驱动：TB6612 四路带稳压板（D24A）

| 参数 | D24A（本次采购） | 说明 |
|---|---|---|
| 芯片 | **2 × TB6612FNG** | 每片 2 路，共 4 路 |
| 单路持续电流 | **1.2 A** | 芯片手册 IOUT(ave) |
| 单路峰值电流 | **3.2 A** | 芯片手册 IOUT(peak)，**不可持续** |
| VM 范围 | **2.5 – 13.5 V**（绝对最大 15 V） | 3S 满电 12.6 V，余量仅 0.9 V |
| 控制方式 | **1 路 PWM + 2 路 IO / 电机** | 共 4 PWM + 8 IO |
| PWM 频率 | **10 kHz**（手册推荐，范围 0–100 kHz） | |
| 使能 | **STBY**，必须拉高 | 推荐由 GPIO 控制以便软急停 |
| 板载稳压 | 5V = RT8279（5 A/500 kHz），3.3V = RT9013 LDO（500 mA） | |
| 过温保护 | **整板 65 °C 关断 RT8279 的对外 5V/3.3V** | 不切 VM；但 TB6612 的 VCC 取自此 5V，见 §2.4 |

### 2.3 接线

```
   3S LiPo (+) ──[主保险丝 ≥15A，待实测]──┬── D24A  Vin+  ── 4× MG513X
                                          │      │
                                          │      ├─ 板载 RT8279 → 5V  → 5V 对外
                                          │      │                    └→ RT9013 → 3.3V 对外
                                          │      │
                                          │      └─ 板载 1/11 分压 → ADC 引脚（电池监测）
                                          │
                                          └── 🔴 独立 DC-DC 5V ≥3A ── K230D + 相机
                                                 （★ 不从驱动板取，见 §2.4）

   所有 GND 单点汇流到电池负极（星型接地，见 docs/06）
```

**每路电机的控制信号**（真值表见规格文档 §2.2）：

| 路 | PWM | IN1 | IN2 | 编码器 |
|---|---|---|---|---|
| A | PWMA | AIN1 | AIN2 | E1A / E1B |
| B | PWMB | BIN1 | BIN2 | E2A / E2B |
| C | PWMC | CIN1 | CIN2 | E3A / E3B |
| D | PWMD | DIN1 | DIN2 | E4A / E4B |

> **与 BTS7960 的关键区别**：TB6612 **每个电机只需 1 路 PWM**（BTS7960 需要 2 路反向 PWM）。
> 不会直通，但 **PWM=0 时是滑行（coast）而非刹车**，
> 需要快速停车时用 **IN1=IN2=1 + PWM=1（制动）**。

### 2.4 ⚠️ 过温保护的作用范围（已按原理图核对）

> **更正**：早前写「65 °C 保护会切断 5V/3.3V 把主控与视觉一起断电」——**这是错的**。
> 过温网络 `R3(NTC)+R4+R5(0Ω)` → `P_EN` 只接 **RT8279 的 EN**，
> 关断的仅是 D24A 的**对外实验电源**，不切 VM，也不影响 K230D 的独立供电。

```
四路电机长时间堵转（顶墙推棋子）
  → 两片 TB6612FNG 发热（3.2 A 档合计 20.5 W）
  → 板温升高 → P_EN 拉低 → 板载 5V/3.3V 对外输出失电
  → ⚠️ TB6612 的 VCC(20) 正取自此 5V → 芯片逻辑掉电 → 输出级关断 → 四轮失控滑行
  → K230D / 视觉不受影响（独立 buck）
```

**处置**：

1. 🔴 **堵转降 PWM 保护**（§5）压住发热 —— 这是根本措施。
2. 🟡 视觉独立供电**原设计已满足**，复核接线即可。
3. 🟢 可选：把 STM32 的 3.3V 改独立 LDO/buck，让逻辑也完全免疫。
4. 实测板级保护行为：确认它只关对外输出、不影响 VM。

---
## 3. 控制环

### 3.1 双环结构（麦轮全向 · 当前方案）

```
    目标 (vx_cmd, vy_cmd, ω_cmd)
            │
    ┌───────┴──────────────────────┐
    │   麦轮运动学分解（4轮）        │  逆运动学
    │ ω1 = ( vx − vy − (a+b)ω ) / r │  r = 轮半径
    │ ω2 = ( vx + vy + (a+b)ω ) / r │  a,b = 半轴距/半轮距
    │ ω3 = ( vx + vy − (a+b)ω ) / r │
    │ ω4 = ( vx − vy + (a+b)ω ) / r │
    └───────┬──────────────────────┘
            │
    ┌───────┴────────┐
    │  速度环 PID     │  1 kHz
    │  ×4（每轮独立）  │  反馈 = 编码器
    └───────┬────────┘
            │
        PWM 20kHz ×4
```

> ⚠️ **与旧差速方案的关键区别**：
>
> | | 差速（旧） | 麦轮（当前） |
> |---|---|---|
> | 电机/PWM 路数 | 2 | **4** |
> | 运动学 | `v_L = v − ωB/2`、`v_R = v + ωB/2` | 上式 4 轮 |
> | 自由度 | 2（v, ω），**不能横移** | **3（vx, vy, ω），可横移** |
> | 速度环数量 | 2 | **4** |
>
> **G474 的定时器资源需按 4 路 PWM + 4 路编码器重新核对**
> （原文档按 2 路规划，见 §1.2 的引脚分配）。

### 3.1b 差速模型（旧方案，仅作对照）

```
    目标 (v_cmd, ω_cmd)
            │
    ┌───────┴────────┐
    │   运动学分解     │  差速模型
    │ v_L = v − ω·B/2 │  B = 轮距 150mm
    │ v_R = v + ω·B/2 │
    └───────┬────────┘
            │
    ┌───────┴────────┐
    │  速度环 PID     │  1 kHz（2 路）
    └───────┬────────┘
            │
          PWM 20kHz
```

**外层航向环**（500 Hz）：

```
    目标航向 θ_cmd  ──→ [+] ──→ PID ──→ ω_cmd
                        −│
                    IMU 航向 θ
```

### 3.2 参数起点

| 环 | 频率 | Kp | Ki | Kd | 说明 |
|---|---|---|---|---|---|
| 速度环 | 1 kHz | 0.8 | 0.35 | 0 | 输出为 PWM 占空比 |
| 航向环 | 500 Hz | 2.5 | 0 | 0.15 | 输出为 ω_cmd |

> 这些只是**起点**，必须实测整定。整定顺序：先速度环（让轮速跟随阶跃指令无超调），
> 再航向环（让原地转向无振荡）。

### 3.3 必须用编码器闭环，不能用开环 PWM

3S 电池从满电 12.6V 放到 9.0V，同一 PWM 下**轮速变化约 30%**。
开环 PWM 会让里程计和推程全部不准。**速度环是里程计可信的前提。**

---

## 4. IMU：ICM20602

### 4.1 为什么不用 MPU6050

| 指标 | ICM20602 | MPU6050 |
|---|---|---|
| 陀螺零偏稳定性 | 好 | 差 |
| 最高 ODR | 32 kHz | 8 kHz |
| 内置 DMP | 有 | 有 |
| 价格 | 约 ¥25 | 约 ¥10 |
| 市场风险 | 低 | **廉价模块大量是 MPU6500 贴牌** |

航向积分对零偏稳定性极敏感：零偏 0.1°/s 时，60 秒累积漂移 **6°**。
选 ICM20602 是因为**它是定位链路的精度瓶颈所在**。

### 4.2 配置

| 项目 | 取值 | 理由 |
|---|---|---|
| 陀螺量程 | ±500 °/s | 车原地转向最大角速度约 300°/s |
| 陀螺 ODR | 1 kHz | 与速度环同步 |
| 加速度量程 | ±4 g | 撞击时峰值 |
| 低通滤波 | 约 100 Hz | 滤电机振动 |
| 接口 | SPI2，2.66 MHz（规格上限 10 MHz） | 比 I²C 快且不受总线锁死影响；留足余量抗电机干扰 |

### 4.2.1 接线（ICM-20602 → STM32G474VET6，SPI2）

| 模块引脚 | 接 STM32 | 外设/功能 | 说明 |
|---|---|---|---|
| VCC | 3V3 | 电源 | 与主控同一电源域 |
| GND | GND | 地 | **必须与主控共地** |
| SCL | PB13 | SPI2_SCK | 时钟 |
| SDA | PB15 | SPI2_MOSI | 主→从数据 |
| SDO / SA0 | PB14 | SPI2_MISO | 从→主数据 |
| CS | PB12 | GPIO_Output | 软件片选（拉低=选中） |
| INT | PB9 | EXTI | data-ready；固件当前用 1 kHz 轮询读取，该脚预留给后续中断模式 |
| FSY / FSYNC | GND | — | 未使用帧同步时接地，不要悬空 |

> 模块实际为 **8P**。`SDA/SDI` 是 SPI 的 MOSI 输入，`SDO/SA0` 是 SPI 的
> MISO 输出；VCC 虽标称支持 3.3–5V，本项目与 STM32 共用 3.3V。

**SPI 要点（易错）**：
- **CS 决定接口模式，不能悬空**：上电时 CS 拉高 = I²C 模式；拉低 = SPI。务必接 MCU 控制。
- 时序：**≤10 MHz**，**Mode 0 或 Mode 3**（均支持，常用 Mode 3）、MSB first、8-bit。
- 首字节协议：MSB = R/W（1 读 0 写）+ 低 7 位寄存器地址；读数据时 MISO 回数据。
- 电源：VCC 就近并 0.1µF + 10µF 去耦。
- 安装：**水平安装、Z 轴朝上**，放车体几何中心/中线上，远离电机与电机线。

**固件落地（2026-10-09）**：`Core/Src/imu.c` 已实现 SPI2 驱动，配置为
±500 dps / ±4 g / 1 kHz ODR / 约 92 Hz DLPF；`Wulong_ControlTick()` 每 1 ms
读一次 Z 轴陀螺并积分航向。调试串口新增：

| 命令 | 作用 |
|---|---|
| `II` | 打印 IMU 就绪状态、零偏标定状态、当前零偏与航向 |
| `IC` | 重新执行 1000 样本静止零偏标定（约 1 秒，期间车必须静止） |
| `IT [div]` | 打开/关闭 IMU 遥测：电机强制不使能，按 `div` ms 周期输出 `IMU t gz_raw bias yaw gz_dps`，可直接接 VOFA+/SerialPlot 波形看手转响应 |

进入 `CV` 控制台时会自动做一次零偏标定；`CZ`/`Wulong_Relocalize()` 会同步
清零或重置陀螺积分航向，避免位姿与积分器不一致。

**为什么把 IMU 采样独立成任务**：1 kHz 采样最初放在 `Wulong_ControlTick()` 里，
而该函数只在 `CV` 控制台运行，`CV` 又会锁零使能电机 —— 结果是「想开波形通道手转车体
观察陀螺」时电机在刹车、采样也不在跑。现改为独立 `ImuTask`（1 kHz），任何模式下都在
采样；`IT` 打开时同时退出 `CV` 并解除电机输出，保证手转测试不受电机负载干扰。

### 4.3 航向估计

**只用陀螺积分**，不用磁力计（室内电机磁场干扰大）。
零偏在**静止时自动标定**（上电后 1 秒静置，取均值），并可由"撞墙重定位"周期性清零。

### 4.4 资料与例程归档

> 来源：商家随模块附带的 `ICM20602六轴模块.zip`（2026-09）。

| 资料 | 位置 |
|---|---|
| 官方芯片手册（数据手册） | `hardware/datasheets/ICM20602/ICM20602芯片手册.pdf` |
| 降噪寄存器配置 | `hardware/datasheets/ICM20602/寄存器配置.md` |
| 开源库 & 参考链接 | `hardware/datasheets/ICM20602/开源库与参考链接.md` |
| STM32 逐飞例程（硬件SPI / 软件SPI / 软件IIC） | `firmware/stm32/reference/icm20602/` |
| 完整资料包（21 个 MCU 例程 + 清华直立方案 + 示波器） | `outputs/IMU资料_ICM20602/`（本地，不入 git） |

**关键结论**：
- 开源库 = 逐飞科技（seekfree，gitee.com/seekfree）；例程覆盖 STM32、CH32V103、K60/K66/KEA、RT1021/1064、TC264、STC、MM32、LPC54606。
- **首选 `hardware_spi` 版移植**：核心驱动 `SEEKFREE_ICM20602.c/.h` 平台无关，只改底层 SPI 读写函数与引脚即可落到 SPI2。
- 商家降噪配置（仅噪声偏大时用）：`CONFIG=0x03`、`ACCEL_CONFIG_2=0x26`，会显著压带宽，本项目默认不用。

---

## 5. 堵转检测与保护

> **为什么必须做**：MG513X 堵转电流 **>1.2 A**（读法 A ≈1.5 A，保守读数 3.2 A），
> 超过 TB6612 单路持续 **1.2 A**。四路同时堵转时两片合计发热可达 **20.5 W**（3.2 A 档），
> 会触发**芯片热保护**或**板级 65 °C 保护**（后者会关断板载 5V，进而使 TB6612 自身 VCC 掉电）。
> 无论哪条，结果都是**驱动输出关断 → 四轮失控滑行**（§2.4）。

**注意区分"正常堵转"与"故障堵转"**：
推棋子时推板顶着墙，电机本来就该是堵转状态。所以保护**不能简单停机**，
而应：**堵转时把输出降到维持值，并让决策层知道"我顶住了"**。

```c
/* 速度环内，1 kHz 调用 */
if (fabs(target_rpm) > 50.0f && fabs(actual_rpm) < 10.0f) {
    if (++stall_cnt > 200) {            /* 200 ms @ 1 kHz */
        /* ★ 不是停机，而是把 PWM 压到维持值 */
        motor_set_duty(m, DUTY_HOLD);   /* ≈30% */
        report_event(EV_STALL_HOLD);    /* 决策层：已到位/受阻 */
    }
} else {
    stall_cnt = 0;
    if (stall_hold) {                   /* 脱离堵转后恢复闭环 */
        stall_hold = false;
        report_event(EV_STALL_RELEASED);
    }
}
```

| 参数 | 取值 | 理由 |
|---|---|---|
| 判据窗口 | 200 ms | 短于动作节拍，长于启动冲击 |
| 维持占空比 | ≈30% | 顶墙所需的最小保持力 |
| 脱离恢复 | 立即恢复闭环 | 需要能继续推进下一枚 |

**这才是正确语义：堵转是任务信息，不只是故障。**

**二级保护（推荐）**：加 INA240 或使用板载 VM 采样，
把单路电流限到 **1.2 A**；这是唯一能把「长时间顶墙」变安全的办法。

---
## 6. 上电自检

C8 要求全程自主、禁止人工干预。因此**上电即自启**，自检必须自动完成：

| 步骤 | 检查内容 | 失败处理 |
|---|---|---|
| 1 | IMU 通信 + 静止零偏标定 | 蜂鸣器 3 短响，LED 快闪 |
| 2 | 编码器：轻微转动电机，**4 路都应有计数** | 报警并标出失效路 |
| 3 | K230 串口握手（见 docs/11） | 重试 3 次，失败则进入**降级策略 B** |
| 4 | 电池电压 ≥ 10.5V | 低压则报警（但继续，因为可能只是没充满） |
| 5 | 激光模组点亮 | 仅记录，不阻塞 |

**第 3 步失败不应导致整车不动** —— 必须能进降级策略（见 [docs/07](07-软件架构与决策策略.md)）。

---

## 7. 禁止事项（合规）

| 禁止 | 检查 |
|---|---|
| 任何无线模块 | **调试口用有线串口**，PCB/模块上不得有蓝牙/WiFi 芯片 |
| 电磁铁 | 不得有 |
| 激光功率超标 | 串限流电阻，实测 ≤0.7mW（留 30% 余量） |
| 破坏性装置 | 不得有 |

**采购检查清单**：买电机驱动、主控板时注意别买带 ESP8266/蓝牙的"智能小车套件"，
那些模块会构成"遥控能力"，即使不用也可能被判违规。
