sheepxray/1145141919810wulongjiadao/docs/10-开发计划与里程碑.md

# 10 · 开发计划与里程碑（两月周期版 · 已按硬节点修订）

> **周期**：2 个月 = 8 周。起点 **2026-09-28（周一）**，终点 **2026-11-22**。
> **三个已定死节点**（2026-09-28 用户更新）：
> - 🔴 **10-01**：**初代底板到货**
> - 🔴 **10-07 前**：完成**动力系统验证 + 视觉模块验证**
> - 🔴 **10-14 前**：完成**第二版底盘设计 + 顶部摄像机模块放置方案**
>
> **原则**：MVP 优先；字符识别是优化项不是前提；硬件按**到货 kit（麦轮 + K230D + 单 OV5640 + G474 + TB6612）**推进。
>
> **官方赛事节奏（2026-10-12 校赛动员，宣讲口径）**：常规节点为 **3 月校赛、4 月区赛、5 月国赛**。
> 本文件的 09-28 到 11-22 是**内部第一阶段 / MVP 周期**，不是校赛总周期。
> 月份和日期以官方通知为准，详见 [20 竞赛校赛动员](20-竞赛校赛动员与官方节点_20261012.md)。

---

## 0. 既定前提（2026-09-28 更新）

- 硬件：采用**实际到货 kit**（麦轮全向底盘），不再保留差速/RK3588 分支。
  由 `08-BOM物料清单.md`、`16-最终商品清单.md` 对齐。
- **三项后置补购**（用户已明确：不在 W1 下，等验证结论再买）：
  - 激光模组 650nm ≤1mW + 限流电阻（C9/C16 强制，但只要求赛前搭载，不参与开发链路）
  - IMU（ICM-20602，选型已定，SPI2）——航向融合，必要性见下方论证
  - 下视相机——双相机方案失效后的推入精度补偿
- **补购触发判据（量化闸门）**：
  - 激光：动力验证（10-07）通过后即购；
  - IMU：第二轮定位标定时若「连续平移/斜移累计漂移导致 3m 横向误差 > 50mm 或航向误差 > 3°」则补购（详见论证）；
  - 下视相机：第二轮接近推入调试时若开环直推命中率 < 阈值则补购。

### IMU 必要性论证（四轮麦轮车）

> 用户疑问：整车是四轮（麦轮全向），是否还需要 IMU？结论：**仍需，但可后置。**

1. **麦轮能从四轮编码器解出 vx / vy / ω**——这是全向底盘相对差速车的优势，也是「四轮不需要 IMU」这一看法的来源。差速车受非完整约束（不能侧移），麦轮四轮独立、理论上三轴速度都能解。

2. **但本任务的精度压力集中在「航向 θ」，恰是麦轮轮速解算最不可靠的量。**
   推入方向 = 棋子相对方位 + 车体绝对航向（docs/00 判断一，航向 ±0.5°级）。
   麦轮的 ω 由四轮转速**差分**得出，对以下误差高度敏感：
   - 左右轮有效半径不一致（辊子受压变形、地面软硬差异）；
   - 轮距/轴距几何标定误差；
   - **横移（strafe）时左右辊子滑移不对称 → 产生虚假 ω → 航向漂移**。
   即：最需要精度的「贴墙横移 + 定向推入」工况，恰好是麦轮 ω 估计最不稳的工况。

3. **IMU 陀螺仪直接测角速度**：1kHz 高带宽、不依赖地面接触、不受打滑影响，是编码器航向的互补对：
   - 陀螺仪：短期准（打滑无关），长期零偏漂移；
   - 编码器航向：长期无漂，但打滑时错、带宽低；
   - EKF / 互补滤波融合后做到航向 ±0.5° 是标准做法。

4. **结论与节奏**：四轮麦轮**不构成弃用 IMU 的理由**，至少应保留一路 yaw 陀螺。
   但它不是 W1 前置件——先跑纯编码器 + 里程计，第二轮定位标定时用**实测漂移作闸门**：
   若连续平移/斜移累计导致「3m 横向误差 > 50mm 或航向误差 > 3°」则补购 IMU 融合，否则暂缓。
   这与「动力、视觉验证后再购」的节奏一致。

---

## 1. 里程碑总览（8 周，按「轮次」组织）

| 阶段 | 日期 | 目标 | 关键交付 |
|---|---|---|---|
| **第一轮（打样验证）** | 09-28 ~ 10-07 | 初代底板到货 + 动力/视觉验证 | 动力验证报告 + 视觉验证记录 |
| **第二轮（整机）** | 10-08 ~ 10-21 | 第二版底盘设计 + 能自主定位、能得分 MVP | 第二版底盘 + 顶部相机方案 + 全尺寸场推入 ≥3 枚 |
| **第三轮（算法）** | 10-22 ~ 11-08 | 读字 + 打分 + 策略 | 分值识别 + 帅/将优先 |
| **第四轮（稳定）** | 11-09 ~ 11-22 | 压力测试、可参赛 | 连续运行无致命故障 |

> ⚠️ 第二轮结束必须有一套**不依赖 CNN 的兜底策略 B**（全计划最重约束）。

---

## 2. 第一轮 · 初代底板打样与验证（09-28 ~ 10-07）

### 2.1 🔴 节点一：10-01 初代底板到货

| 任务 | 输出 |
|---|---|
| 初代底板开箱检查（结构件、孔位、平整度） | 到货核检记录 |
| 初代底盘装配（4 电机 + 4 麦轮，四点共面） | 可通电的初代底盘 |
| 三项后置补购不前置，待动力/视觉验证触发（见 §0） | 触发判据 |
| K230D 空模型跑通（可与机械并行） | 部署链路 demo |

> ✅ **10-01 收到初代底板已确认**（2026-09-28 用户确认）；装配后先用初代底板跑动力/视觉验证，验证结论再驱动第二版底盘设计（10-14 前，见 §2.4）。

### 2.2 🔴 节点二（动力）：10-07 前完成动力系统验证

| 任务 | 验证标准 |
|---|---|
| G474 + TB6612 + 4 电机通电 bring-up | 四电机正反转可控 |
| 编码器读数 | 计数与方向正确 |
| 麦轮运动学（平移/斜移/自转） | 三模式可执行 |
| 空载/负载电流监测 | 记录电流，确认 TB6612 不热保护 |
| 轮速 PID（初版） | 阶跃无振荡 |

### 2.3 🔴 节点二（视觉）：10-07 前完成视觉模块验证

| 任务 | 验证标准 |
|---|---|
| OV5640 前视点亮与取流 | 稳定出图，帧率达标 |
| 图像尺寸/畸变/白平衡标定 | 获得初始内参基线 |
| 真实场地 HSV 阈值摸查（棋子色块） | 色块初步可分 |
| K230D 全链路（采集→预处理→检测） | demo 单帧/多帧可跑 |

> 视觉模块验证与动力验证并行；此处只要求“模块能跑通、能出图”，字符识别/定位闭环留到第二轮。

### 2.4 🔴 节点三：10-14 前完成第二版底盘设计 + 顶部摄像机模块放置方案

| 任务 | 输出 |
|---|---|
| 基于 10-07 初代验证结论的底盘迭代（结构/走线/减重） | 第二版底盘 3D 模型 / 图纸 |
| 顶部摄像机模块放置方案（立柱/云台位、视场、重心） | 顶部相机安装方案 |
| 打印/加工约束校核（孔隙、支撑、走线） | 可制造性检查 |

**第一轮出口标准**
- [ ] 初代底板到货并装配成可通电底盘
- [ ] 动力系统验证完成（四轮可控 + 全向移动）
- [ ] 视觉模块验证完成（出图 + 初始标定基线）
- [ ] 第二版底盘设计 + 顶部摄像机模块放置方案（10-14 前）
- [ ] 明确三项后置补购的触发判据与时机

---

## 3. 第二轮 · 整机与 MVP（10-08 ~ 10-21）

### 10-08 ~ 10-14 第二版底盘设计与定位/视觉前端

- 第二版底盘设计 + 顶部摄像机模块放置方案（10-14 前，见 §2.4）
- 编码器航迹推算（无 IMU → 评估漂移，必要时用板载传感器兜底）
- OV5640 前视 + HSV 阈值标定（真实场地）
- 圆形筛选 + 棋子检测 + 坐标变换

### 10-15 ~ 10-21 接近推入 + 策略 B

- 接近路径 + 摆正
- 推入机构（单相机无下视伺服 → 先开环直推 + 过冲）
- 兜底策略 B（不读字，按距离抢枚数）

**第二轮出口**
- [ ] 全尺寸场地自主推入 ≥ 3 枚
- [ ] 策略 B 可用（不依赖 CNN 也能参赛）

---

## 4. 第三轮 · 识别与策略（10-22 ~ 11-08）

- 10-22 ~ 11-01：采集/合成字形数据集、7 类兵种分类（>95%）、nncase 量化 + K230D 部署
- 11-02 ~ 11-08：停车读字协议、打分函数、帅/将优先级 + 送分规避、时间管理

**第三轮出口**
- [ ] 能识别分值
- [ ] 打分函数生效、优先高分

---

## 5. 第四轮 · 稳定与压力测试（11-09 ~ 11-22）

- 对手避让 / 拥堵绕行
- 满负荷连续测试 ≥ 5 场
- 现场标定预案（30 分钟内可标定）

**第四轮出口**
- [ ] 连续运行无致命故障
- [ ] 现场调试流程文档化

---

## 6. 关键路径

```
初代底板到货(10-01) ─→ 动力/视觉验证(10-07) ─→ 第二版底盘+顶部相机(10-14) ─→ 全向控制 ─→ 定位 ─→ MVP(10-21)
        ↑ 并行：补购下单 / K230D 部署链路
                                        ↓
                         识别(第三轮) ─→ 策略 ─→ 压力测试(11-22)
```

**瓶颈**：① 无 IMU 的定位漂移；② 单相机无下视伺服的推入精度；
③ nncase/K230D 部署（应在第一轮就并行验证）。初代底盘到货窗口已于 10-01 确认。

---

## 7. 「来不及」预案

| 节点/阶段 | 若延期 | 兜底 |
|---|---|---|
| 10-01 初代底板到货 | 到货延迟 | 与供应商催交；先并行 K230D 空模型与视觉链路 |
| 10-07 动力/视觉验证 | TB6612 堵转/热保护 | 降速、限流、备 BTS7960 |
| 第二轮 MVP | 推入精度差 | 开环直推 + 更大过冲 |
| 第三轮 CNN | 部署失败 | 直接策略 B 参赛 |
| 第四轮 | 时间不够 | 放弃对抗，保基础得分稳定 |
