sheepxray/1145141919810wulongjiadao/docs/02-机械系统设计.md

# 02 · 机械系统设计

> ⚠️ **方案裁决（2026-09-28）**：仓库已按实际采购定为 **麦轮全向 + K230D + 单 OV5640 + STM32G474 + TB6612**（见 [08 BOM](08-BOM物料清单.md)、[16 商品清单](16-最终商品清单.md)、[10 计划](10-开发计划与里程碑.md)）。本文为早期/旧平台版本，其中与当前采购冲突的选型与指标以 16/17 为准；架构思路与算法结论多数继续沿用。

> 加工条件：**只有 3D 打印**。全部结构件为打印件，无钣金、无激光切割。
> 尺寸由 [`tools/sketchup_model.py`](https://github.com/sheepxray/1145141919810wulongjiadao/blob/main/tools/sketchup_model.py) 参数化生成并校核。

---

## 1. 总体布局

俯视示意（车头朝上，单位 mm）：

```
                    ┌──────────────────────────────────┐
                    │   ╭──────────────────────────╮   │  ← 盒式推板（宽 195）
                    │   │  侧裙                侧裙 │   │
                    │   ╰──────────────────────────╯   │
                    │           开口 165               │
        ┌───────────┴──────────────────────────────────┴───────────┐
        │                      推板柔性贴地                          │
        ├──────────────────────────────────────────────────────────┤
        │  ○                                                   ○   │  ┐
        │                                                          │  │ 麦克纳姆轮
        │  ┌──────────┐        ┌──────────┐       [前视相机]       │  │ ×4（φ60）
        │  │ K230D    │        │  G474    │                        │  │
        │  └──────────┘        └──────────┘                        │  │
        │  ┌─────────────┐                ┌───────┐                │  │
        │  │ TB6612 D24A │                │ 电池  │                │  │
        │  └─────────────┘                └───────┘                │  │
        │  ○                                                   ○   │  ┘
        └──────────────────────────────────────────────────────────┘
```

> ⚠️ **本图为旧方案（差速 2 轮）布局。** 实际为**麦轮 4 轮**：
> 四角各一个 MG513X + φ60 麦轮，电机总重 **680g**。
> 底盘需按 4 轮重新建模（见 [docs/16](16-最终商品清单.md) §1）。

**关键尺寸**：

| 项目 | 取值 | 说明 |
|---|---|---|
| **车体宽** | **150mm** | **刻意做窄** —— 见第 3 节的推导 |
| **推板宽** | **195mm** | 接近 200mm 上限 |
| **悬伸量** | **±22.5mm** | = (195 − 150)/2，这是容错的来源 |
| 车体长 | 190mm | 含推板总长 223mm（上限 250） |
| **总高** | **160mm** | 含 50mm 相机立柱（上限 180） |
| 驱动轮 | ⚠️ **实际为 φ60 麦克纳姆轮 ×4** | 旧方案 φ65 橡胶轮 ×2 已弃用 |
| 从动支撑 | ⚠️ **无**（麦轮 4 点支撑） | 旧方案前后万向球已弃用 |

> ⚠️ **上表中与轮系相关的行已过时**：麦轮 4 轮自支撑，不需要万向球；
> 但 **4 个电机总重 680g**，比旧方案（2 个 95g 电机）增加约 490g，
> **结构件预算被压缩**。详见 [docs/16](16-最终商品清单.md) §1 的质量预警。
>
> **仍成立的关键结论**：「车体做窄 + 推板做宽」的贴墙容错推导（第 3 节）
> 与轮系无关，继续适用。

### 外廓校核（由脚本生成）

| 方向 | 设计 | 上限 | 余量 | 状态 |
|---|---|---|---|---|
| 长 | 223 | 250 | 27 | OK |
| **宽** | **195** | **200** | **5** | **⚠️ 最紧** |
| 高 | 160 | 180 | 20 | OK |

> ⚠️ **宽度余量仅 5mm** —— 装配时优先保证这一维。

---

## 2. 车架（3D 打印）

### 2.1 结构形式：三板式

```
    上层板 (3mm, z=100)  —— K230D、G474、IMU
        ↕ 铜柱 32mm
    中层板 (3mm, z=68)   —— TB6612 D24A、电池
        ↕ 铜柱 20mm
    底板   (4mm, z=44)   —— 电机座 ×4、推板挂点
```

**为什么用三板**：K230D 对电源噪声敏感（堵转时 3S 会被拉低），
可能导致 brownout 重启。把视觉/逻辑放上层、动力放中层，
配合 [docs/06](06-电源系统.md) 的电源隔离，是最省空间的抗干扰布局。

> ⚠️ **麦轮底盘新增约束**：4 个电机占 680g，底板承力与刚性要求提高；
> 且麦轮需要**四角布置**，电机座位置与旧方案（前后各 1）完全不同，
> 需按 4 轮重新建模。

### 2.2 ★ 相机立柱（高度计算的关键）

**相机光心高度 150mm 是全部几何计算的基准** ——
挡板可见性、汉字像素数、可见地面区间都基于它（[docs/14](14-1080p视觉管线.md)）。

但三层板顶面在 z=100mm，所以需要一根 **50mm 立柱**把相机举到 150mm。

```
   z=160 ┌──┐  ← 相机顶面（总高限制点）
   z=150 │▓▓│  ← 相机光心 ★ 几何基准
   z=105 │  │  ← 50mm 立柱
   z=100 └──┘  ← 上层板
```

> ⚠️ **不能为了降低总高而降低相机高度** ——
> 那会改变所有几何计算的结果（可见区间、汉字像素数）。
> 160mm 总高在 180mm 限值内，余量 20mm。

### 2.3 打印规范

| 项目 | 规范 | 理由 |
|---|---|---|
| 材料 | **PETG**（承力件可 PA-CF / ASA） | **不要 PLA** —— 脆，冲击下会断 |
| 层高 | 0.2mm | 强度/时间平衡 |
| 壁数 | ≥ 3 层 | 壁数比填充率更影响强度 |
| 填充 | 25%（承力件 40%） | — |
| 螺纹 | **全部用热熔铜螺母** | 打印螺纹孔会滑丝 |
| 螺丝 | 金属 M3（不锈钢） | — |

**三点必须注意**：

1. **受载方向决定打印朝向** —— 推板挂点、电机座要按受力方向摆放模型，
   让层间结合面**垂直于**主受力方向（FDM 的层间强度远低于层内）。
2. **悬臂结构加筋** —— 推板是悬臂，必须加三角筋或做成箱型截面。
3. **热熔铜螺母孔径** —— PETG 用 M3 铜螺母时孔径取 4.0–4.2mm。

---

## 3. 推板机构（本设计的核心）

### 3.1 为什么是"盒式"而不是"一块弧形板"

| 问题 | 后果 | 盒式结构的解法 |
|---|---|---|
| 车体偏航时棋子从侧面滑出 | 推一半丢了 | **侧裙**（高 30mm）把棋子兜在开口内 |
| 棋子从推板底下钻过去 | 完全失效 | **柔性贴地**，离地 ≤1.5mm 且有下压力 |

### 3.2 ★ 关键洞察：容错窗口与车宽无关

棋子贴侧墙时，车体横向可用的对准窗口：

```
约束 (a) 推板要罩住棋子 : car_y − jaw_half ≤ r        （r = 棋子半径 22.5mm）
约束 (b) 车体不能撞墙   : car_y ≥ car_half + clearance

窗口 = (r + jaw_half) − (car_half + clearance)
```

**若推板不超出车体**（`jaw_half = car_half`），车体半宽被消掉：

```
窗口 = r − clearance = 22.5 − 5 = 17.5mm   （与车宽无关！）
```

`tools/geometry.py` 实测：推板开口从 150mm 排到 200mm，窗口**恒为 17.5mm**。
**把车体做宽对贴墙容错毫无帮助。**

**让推板比车体宽**才是正确杠杆。设悬伸 `overhang = jaw_half − car_half`：

```
窗口 = r + overhang − clearance
```

| 车体宽 | 推板宽 | 悬伸 | 窗口 | 评价 |
|---|---|---|---|---|
| 190mm | 195mm | 2.5mm | 20.0mm | 困难 |
| 170mm | 195mm | 12.5mm | 30.0mm | 可行 |
| **150mm** | **195mm** | **22.5mm** | **40.0mm** | **可行** |

**决策：车体宽 150mm，推板宽 195mm → 容错窗口 40.0mm。**

### 3.3 几何参数表

| 参数 | 取值 | 依据 |
|---|---|---|
| 推板总宽 | 195mm | 接近 200mm 外廓上限 |
| 开口宽度 | 165mm | 两侧各留 15mm 做侧裙与结构 |
| 单侧容错（对中） | ±82.5mm | 开口/2 |
| **单侧容错（贴墙）** | **40.0mm** | 见 3.2 推导 |
| 侧裙高度 | 30mm | 高于棋子平躺侧影 |
| 侧裙离地 | 1.5mm | 配合柔性下压 |
| 推板倾角 | 0°（垂直） | 弧形前缘做内凹利于自定心 |

### 3.4 柔性贴地

**这是最容易做坏的一环。** 推板一旦抬起 5mm，棋子从底下溜走，整个机构白设计。

| 要点 | 做法 |
|---|---|
| 弹簧预压 | 2 个压簧（k≈0.5 N/mm），预压 8mm → 约 4N 下压力 |
| PTFE 贴底 | 底面粘 0.5mm PTFE 胶带减摩 |
| 机械限位 | 最低点离地 1.5mm，避免弹簧压到地面刮擦 |
| 铰接 | 通过横向转轴悬挂，只保留俯仰自由度 |

### 3.5 验证方法（M1 必做）

| 测试 | 通过标准 |
|---|---|
| 贴地测试：推板压过一张纸 | 纸被推动，不被压住 |
| 侧裙测试：斜 30° 推一枚棋子 | 棋子在开口内被带向中心，不侧向逃逸 |
| **贴墙测试**：棋子靠墙，车贴墙推 | 能推走。记录实际可容忍的横向偏差 |

**第三项决定"贴墙纵推模式"能否使用。**

---

## 4. 质量与预算

> ⚠️ **下表是旧方案（差速 2 轮 / RK3588 视觉链）的推算值，已被实际采购取代。**
> 按官方规格重算：**4×MG513X 电机一项就 680 g**（旧表「动力 300 g」只算了 2 台），
> 加电池 ≈200 g 已达 **≈880 g**，**只剩 ≈620 g 给全部结构件**。
> 当前口径见 [16 商品清单 §1](16-最终商品清单.md) 与
> `python tools/drive_check.py` §7。**必须先称重再定结构。**

由 `python tools/mass_budget.py` 生成（旧方案，仅存档）：

| 类别 | 质量 | 占比 | 成本 | 占比 |
|---|---|---|---|---|
| 结构 | 435 g | 38.4% | ¥69 | 4.6% |
| 动力 | 300 g | 26.5% | ¥220 | 14.8% |
| 电源 | 211 g | 18.6% | ¥163 | 11.0% |
| **视觉** | 136 g | 12.0% | **¥854** | **57.5%** |
| 合规 | 27 g | 2.4% | ¥25 | 1.7% |
| 控制 | 25 g | 2.2% | ¥155 | 10.4% |
| **合计** | **1134 g** | **75.6% of 1500** | **¥1486** | **74.3% of 2000** |

> **视觉占成本 57.5%，结构占质量 38.4%** —— 两个值得优化的方向。

---

## 5. 相机安装

| 相机 | 位置 | 朝向 | 任务 |
|---|---|---|---|
| 前视 | 车头，**立柱顶 z=150** | **俯角 15°** | 搜索棋子、近场测墙、障碍 |
| 下视 | 推板正上方，**立柱顶 z=150** | **俯角 60°** | 停车读字、推入段伺服 |

### 下视相机为什么是 60° 而不是 90°

`tools/geometry.py` 暴露的设计陷阱：相机高 150mm、**垂直下视**时，
可见地面区间只有 **0–76mm** —— 画面只覆盖车体正下方，
**完全看不到推板前方 100–250mm 处的棋子**。

| 俯角 | 可见地面区间 | 250mm 处汉字可读性 |
|---|---|---|
| 89°（垂直） | 0 – 76mm | 该距离**不在视场内** |
| **60°** | **11 – 222mm** | 径向 113.6px（舒适） |
| 45° | 52 – 434mm | 舒适，但地面压缩更明显 |

**决策：俯角 60°，用打印的角度定位块保证。**

---

## 6. SketchUp 建模

模型由 [`tools/sketchup_model.py`](https://github.com/sheepxray/1145141919810wulongjiadao/blob/main/tools/sketchup_model.py) **参数化生成**，
输出 SketchUp Ruby 脚本到 [`hardware/mechanical/sketchup/build_robot.rb`](https://github.com/sheepxray/1145141919810wulongjiadao/blob/main/hardware/mechanical/sketchup/build_robot.rb)。

### 为什么用生成器而不是手写模型

五轮迭代中尺寸改过多次（车宽、推板、主控、相机）。
参数化后**改一个数字就能重新生成整套模型**，而不是维护一份会过时的死图。

### 使用方法

```bash
python tools/sketchup_model.py          # 校验尺寸 + 生成 Ruby 脚本
python tools/sketchup_model.py --layout # 只看三视图
```

在 SketchUp 2026 中：

```
方式1: 窗口 → Ruby 控制台 → 粘贴脚本全文 → 回车
方式2: 扩展程序 → Ruby 控制台 → load '<路径>/build_robot.rb'
```

### 模型包含

| 组 | 说明 |
|---|---|
| `BasePlate` / `MidPlate` / `TopPlate` | 三层板 |
| `Wheel_L` / `Wheel_R` / `Motor_L` / `Motor_R` | 轮系与电机 |
| `Caster_F` / `Caster_B` | 前后万向球 |
| `Jaw_Back` / `Skirt_L` / `Skirt_R` | 盒式推板三件 |
| `CamMast_F` / `CamMast_D` | 相机立柱（50mm） |
| `Cam_Front` / `Cam_Down` | 两个相机 |
| `Battery` / `VisionBoard_K230D` / `MCU_G474` / `Driver_TB6612` / `Laser` | 电子件占位 |

> ⚠️ **SketchUp 模型仍是旧方案**（差速 2 轮）。
> `tools/sketchup_model.py` 的参数需按麦轮 4 轮更新后才能用。

---

## 7. 装配顺序

> ⚠️ **本顺序为旧方案（差速 2 轮）。麦轮 4 轮的装配顺序需重新编排。**

```
1. 底板打印 → 压入热熔铜螺母 → 装电机座
2. 装 2 个驱动轮 + 前后万向球 → 检查四点共面
3. 中层板（铜柱 20mm）→ 装 TB6612 D24A、电源模块
4. 上层板（铜柱 32mm）→ 装 K230D、G474、IMU
5. 装相机立柱（50mm）→ 装相机
6. 装推板：铰接轴 → 弹簧 → 校准离地 1.5mm
7. 称重 → 回填 tools/mass_budget.py
8. 通电自检
```

**麦轮版需调整的步骤**：
- 第 1 步：电机座改为**四角布置**（4 个），不是前后各 1
- 第 2 步：装 **4 个 φ60 麦轮**（注意辊子朝向：标准 O 型或 X 型布局），**无万向球**
- 第 7 步：**必须实测称重** —— 4 电机已占 680g，是新的瓶颈

**第 5 步前不要装推板** —— 推板悬臂会妨碍接线。
**相机角度必须用定位块**，不能目测：俯角误差 5° 会显著改变可见区间。
**第 1 步先装轮子再装板**，方便调整四点共面。

---

## 8. 待确认项的机械影响

| 待确认项 | 机械影响 |
|---|---|
| Q5 棋子实际直径 | 推板开口、侧裙高度、贴地间隙全部依赖它。**默认按 φ45 设计** |
| Q5 棋子厚度 | 侧裙高度只需高于厚度 |
| Q4 球门位置 | 决定推进轴向，不影响机械本体 |
| 地面材质 | 影响万向球选型（硬地 vs 地毯） |

**若棋子实际直径不是 45mm**：改 `tools/sketchup_model.py` 的参数重跑，
推板几何随之更新。
