sheepxray/1145141919810wulongjiadao/docs/06-电源系统.md

# 06 · 电源系统

> 🗄️ **历史五轮档案（旧平台）**：本文是五轮迭代「第 1 轮」的产物，基于旧平台（差速 + RK3588 / H723 / 双 IMX219 / BTS7960）。结论已被实际采购方案部分或全部取代，仅作方法与数据档案保留；当前方案见 [16 商品清单](16-最终商品清单.md)，新判断见 [17 电机参数](17-实际电机参数核对.md) / [10 计划](10-开发计划与里程碑.md)。

> ### 📍 当前权威口径（先看这里）
>
> | 主题 | 权威文档 |
> |---|---|
> | 电机器件参数、驱动裕度、过温风险 | [hardware/electrical/TB6612_MG513X_规格.md](https://github.com/sheepxray/1145141919810wulongjiadao/blob/main/hardware/electrical/TB6612_MG513X_规格.md) |
> | 实际下单与差异对照 | [docs/16](16-最终商品清单.md)、[docs/18](18-采购记录_20260928.md) |
> | 电机参数核对 | [docs/17](17-实际电机参数核对.md) |
>
> **本文的电源架构思路（三轨分离 / 单点星型接地 / brownout 防护）仍然适用**，
> 但**具体电流数值全部基于旧电机，不可直接引用**。

> ⚠️ **部分结论已被 [docs/17](17-实际电机参数核对.md) 取代（2026-09）。**
>
> 用户提供了**实际电机的实测参数**，它与本文第一轮假设的 JGB37-520
> 相差 **5 倍**（24Ω vs 4.8Ω，堵转 0.5A vs 2.5A）：
>
> | 本文结论 | 现状 |
> |---|---|
> | 「持续堵转 86 秒后绕组烧毁」 | ❌ **在该电机上不成立** —— 发热仅 6W，假设散热下可长期堵转 |
> | 「限流是必须做的」 | ⚠️ **仍建议做**，但理由从"防烧毁"变为"保护驱动板 + 留热裕度" |
> | 「BTS7960 是必需的」 | ⚠️ **实际采购为 TB6612 四路 D24A**，且过温会连坐 5V/3.3V 轨 |
> | 电流预算的**方法** | ✅ 仍有效，只是参数需替换 |
>
> **本文的分析方法仍然正确，只是输入参数换了。**
> 最新结论请以 [docs/17](17-实际电机参数核对.md) 为准。

> ✅ **2026-09-28 复核：本文 §10「视觉轨与动力轨分开供电」的原则与实际接线一致。**
>
> 实际到手的 **TB6612 四路驱动板（D24A）**除了电机动力（VM）外，
> 还提供 **5V（RT8279，5 A）与 3.3V（RT9013 LDO，500 mA）** 两路**对外实验电源**。
> 本项目的取法是：
>
> - **视觉**：K230D + 相机走**独立 buck**（与 D24A 无关）
> - **逻辑**：STM32 / IMU 用 **D24A 板载 3.3V**（负载仅 ≈105 mA，余量充足）
> - D24A 的 5V 对外输出留作备用，**不接 K230D**
>
> ⚠️ 一个需要注意的耦合点：**TB6612FNG 的 VCC(20) 取自板载 5V**，
> 而 65 °C 过温网络（`P_EN`）会关断 RT8279 —— 因此**堵转发热仍必须靠软件压住**，
> 否则芯片逻辑掉电会导致输出关断。
> 详见 [docs/17 §4.3](17-实际电机参数核对.md)、
> [TB6612_MG513X_规格.md](../hardware/electrical/TB6612_MG513X_规格.md)、
> [接口定义 §3](../hardware/electrical/接口定义.md)。
>
> 另：本文的电流/热分析全部基于**旧电机（JGB37-520，2 台）**，
> 与实际 **MG513X ×4** 不符。新电流预算见 [docs/17 §4](17-实际电机参数核对.md)：
> 额定 **1.44 A / 17.3 W**，堵转 ≈**6.0 A / 72 W**（读法 A）或 **12.8 A / 154 W**（读法 B）。

> **本文是第 1 轮迭代（电源先行）的产物。** 所有数值可用
> `python tools/power_budget.py` 复现。
>
> **为什么电源要最先定**：电机、驱动板、电池、线径、保险丝、稳压模块全部依赖
> 电流预算。顺序颠倒会导致反复返工。

---

## 1. 结论先行

| 问题 | 结论 |
|---|---|
| "电流过大"到底大在哪 | **堵转**：正常 0.50A，堵转 5.0A（**10 倍**） |
| 真正的风险 | **不是电池，是电机烧毁** —— 持续堵转 86 秒绕组报废 |
| 解法 | **限流**（加 INA240 电流采样），不是换更大的电池 |
| 电池 | **3S 1500mAh 25C**（内阻 105mΩ，压降 0.75V） |
| 动力线 | **18 AWG** |
| 保险丝 | **5A 慢熔** |
| 新增必需件 | **INA240 电流采样 ×2（¥12×2）** |

---

## 2. 行驶转矩需求（先确认"正常电流"有多大）

| 项目 | 力 (N) | 来源 |
|---|---|---|
| 滚动阻力 | 0.441 | 1.5kg × μ=0.03 |
| 加速惯性 | 0.750 | 0.5 m/s² |
| 推棋子 | 0.088 | 30g × μ=0.3 |
| **合计推力** | **1.280** | |

每轮需求转矩 = 20.8 mN·m = 0.212 kgf·cm

> **这个转矩需求非常小。** 1.5kg 的车在平地匀速走需要不到 1N 推力。
> 所以问题不在"正常行驶"。

---

## 3. 正常电流 vs 堵转电流

| 电机 | 堵转转矩 | 绕组 | 正常电流 | 堵转电流 | 倍数 |
|---|---|---|---|---|---|
| **JGB37-520 12V (1:56)** | 5.0 kgf·cm | 4.8Ω | **0.25A** | **2.5A** | **10×** |
| JGB37-3530 (低堵转) | 3.0 | 10.0Ω | 0.18A | 1.2A | 7× |
| MD36N (大扭矩) | 10.0 | 2.7Ω | 0.34A | 4.5A | 13× |

**以 JGB37-520 为例**：

- 正常行驶：每台 0.25A，两台共 **0.50A = 6.0W**
- 堵转瞬间：每台 2.5A，两台共 **5.0A = 60W**

**这就是"电流过大"的来源。但它只在堵转/启动瞬间出现，不是常态。**

---

## 4. ★ 真正会烧东西的地方：堵转热效应

这是**本轮最重要的发现**。

堵转时 12V 全部加在绕组电阻上，功率全变成热：

| 电机 | 堵转发热 | 平衡温升 | **安全电流** | **烧毁时间** |
|---|---|---|---|---|
| JGB37-520 | **30W** | 240K | **1.04A** | **86 秒** |
| JGB37-3530 | 14W | 144K | 0.83A | 178 秒 |
| MD36N | 54W | 324K | 1.39A | 66 秒 |

（允许温升取 100K：25°C 环境 → 125°C 绕组）

### 关键数字

JGB37-520：热时间常数 τ = R_th × C_th = 8.0 × 20.0 = **160 秒**，
但**持续堵转 86 秒后就烧毁**。

> ⚠️ **比赛单场 3 分钟（180 秒）。如果车顶住墙 86 秒，电机就废了。**
>
> 这不是理论风险 —— 顶墙推棋子、被对方车挡住都会发生。

### 两个时间尺度要区分

| 量 | 含义 |
|---|---|
| τ = 160s | "升温快慢"（热惯性） |
| 86s | "多久到达 100K 温升"（危险阈值） |

本例中平衡温升 240K 远超 100K 限值，所以 86s 就烧，而不是等到 τ 的 3–5 倍。

### 参数敏感性（结论是否稳健）

| R_th | C_th | τ(s) | 安全电流 | 烧毁时间 |
|---|---|---|---|---|
| 6.0 | 15 | 90 | 1.39A | 58s |
| 8.0 | 20 | 160 | 1.04A | 86s |
| 10.0 | 20 | 200 | 0.83A | 116s |
| 12.0 | 30 | 360 | 0.69A | 158s |

**无论参数怎么取，烧毁时间都在 20–160 秒量级，安全电流都在 0.69–1.39A。
结论稳健：必须限流。**

---

## 5. 各轨道电流预算

### 算力平台对比（第 2 轮迭代的输入）

| 平台 | NPU | 满载 | 5V 轨电流 | 质量 | 价格 | 备注 |
|---|---|---|---|---|---|---|
| K230 | ~6 TOPS | 2.0W | 0.40A | 30g | ¥199 | 现方案，**1080p@30 吃力** |
| RK3576 | 6 TOPS | 5.0W | 1.00A | 60g | ¥420 | 1080p@30 可行 |
| **RK3588** | 6 TOPS | 9.0W | 1.80A | 85g | ¥680 | **推荐：余量充足** |
| Jetson Orin Nano | 40 TOPS | 12.0W | 2.40A | 150g | ¥1600 | 算力过剩，超预算 |

### 电流汇总（按 RK3588 方案）

| 轨道 | 负载 | 电流 | 功率 |
|---|---|---|---|
| 12V | 2 电机正常 | 0.50A | 6.0W |
| 12V | 2 电机堵转 | 5.0A | 60W |
| 5V | RK3588 | 1.80A | 9.0W |
| 5V | 2 相机 | 0.20A | 1.0W |
| 3.3V | 主控 + IMU | 0.15A | 0.5W |
| 3.3V | 激光 + 指示 | 0.02A | 0.07W |

- **持续总电流（12V 侧等效）≈ 2.67A**，功率 ≈ 16.6W
- **峰值总电流（12V 侧等效）≈ 7.2A**，功率 ≈ 76W
- 峰值/持续 = **2.7 倍**

> **换更强的算力平台不会加剧电流问题**（峰值由电机堵转主导），
> 但持续功耗从 8W 涨到 17W，会缩短续航 —— 而续航远超需求，所以无妨。

---

## 6. 电池选型

**判据的三层**：

| 判据 | 结果 |
|---|---|
| (a) C 率 | **全部够**。最小 45C × 0.85Ah = 38A ≫ 7.2A |
| (b) 续航 | **全部够**。最短 19 分钟 vs 需求 3 分钟。**不是选型依据** |
| (c) 电压 | **必须 3S**。2S 峰值端压仅 7.0V，驱动与电机按 12V 设计 |

**真正的判据是峰值压降**（决定 5V 轨会不会 brownout）：

| 电池 | 内阻 | 峰值压降 | 质量 | 价格 |
|---|---|---|---|---|
| 3S 850mAh 45C | 135mΩ | 0.97V | 78g | ¥55 |
| **3S 1500mAh 25C** | **105mΩ** | **0.75V** | 130g | ¥85 |
| 3S 2200mAh 30C | 84mΩ | 0.60V | 185g | ¥120 |

> ⚠️ 850mAh 的内阻比 1500mAh **高 29%**，并非"相当"。
> 它轻 52g，但压降大 0.22V。

**决策：3S 1500mAh 25C**

理由：压降更小，对 5V 轨 brownout 保护更好（主要风险）；130g 在 1.5kg 预算内可接受；续航 34 分钟。

> 若后期质量紧张，可换 850mAh（省 52g），
> 但**必须同时加强 5V 轨输入电容**以补偿更大压降。

---

## 7. 线径与保险丝

⚠️ **载流量额定值是针对持续电流的，不能直接与毫秒级峰值比较。**
导线热时间常数远大于毫秒，峰值只需满足压降要求。

| AWG | mΩ/m | 峰值压降 | 持续载流量 | 持续余量 | 压降<0.2V |
|---|---|---|---|---|---|
| 26 | 133.9 | 0.576V | 1A | 不够 | 偏大 |
| 22 | 52.9 | 0.228V | 3A | 不够 | 偏大 |
| 20 | 33.3 | 0.143V | 5A | 1.9× | ✅ |
| **18** | **20.9** | **0.090V** | **7A** | **2.6×** | ✅ |
| 16 | 13.2 | 0.057V | 10A | 3.7× | ✅ |

**决策**：

- **动力线 18 AWG** —— 持续余量 2.6×，峰值压降 0.09V
- **信号线 26 AWG** —— 电流 < 0.2A，足够
- **保险丝 5A 慢熔** —— 持续余量 1.9×，可耐峰值，且 < 18AWG 的 7A 载流量

---

## 8. ★ 电流过大的缓解措施

**核心思路：问题在堵转，不在正常行驶，所以解法是限流而不是加电源。**

| # | 措施 | 做法 | 作用 |
|---|---|---|---|
| **1** | **★ 电流采样限流** | INA240/ACS712 测电流，PID 限到 1A | **根本解法** |
| 2 | 加速度限制 | PWM 斜坡上升，限制 dI/dt | 消除启动冲击 |
| 3 | 堵转降功率 | 检测堵转后 PWM 降到 30% 维持 | 顶墙时不烧 |
| 4 | 软件死区保护 | 堵转超时 5s → 后退重试 | 避免长时间顶死 |
| 5 | 选低堵转电机 | JGB37-3530（1.2A vs 2.5A） | 牺牲扭矩换安全 |
| 6 | 独立逻辑电池 | 视觉/逻辑单独供电 | 隔离 brownout |

### 第 1 条是必须做的

**没有电流采样，限流无从谈起。** 加一个 INA240（¥12）比换更大的电池有用得多。

### 限流效果验证

| 限流 | 发热 | 相对堵转 | 结果 |
|---|---|---|---|
| 0.8A | 10W | 3.1× | **可长期堵转** |
| **1.0A** | 12W | 2.5× | **可长期堵转** |
| 1.5A | 18W | 1.7× | 190s 烧 |
| 2.0A | 24W | 1.2× | 118s 烧 |
| 2.5A | 30W | 1.0× | 86s 烧 |

> **限流到 1.0A 时，电机可长期堵转不烧** —— 顶墙可以一直顶着。
> 这直接消除了第 4 节的风险。

---

## 9. 系统拓扑

```
                    3S LiPo 11.1V (12.6V 满电)
                            │
                     [5A 慢熔保险丝]
                            │
              ┌─────────────┼──────────────────┐
              │             │                  │
        [BTS7960 ×2]   [DC-DC 12→5V]     [分压 → ADC]
              │          ≥5A / 强瞬态          │
         JGB37-520          │              电池监测
         ×2（动力轨）   [LC 滤波]
              │             │
        [INA240 采样]  ┌────┴──────┐
         （★ 新增）     │           │
                    [RK3588]  [DC-DC 5→3.3V 2A]
                    [相机 ×2]      │
                              [STM32/IMU]
```

---

## 10. K230/RK3588 Brownout 防护

算力平台是这套系统里**对电源最敏感、失效后果最严重**的器件。

### 为什么风险变高了

换成 RK3588 后，5V 轨电流从 0.40A 涨到 **1.80A（4.5 倍）**。
同样的电池压降（0.75V）下，DC-DC 需要处理的功率缺口更大。

### 防护措施（按优先级）

| 优先级 | 措施 |
|---|---|
| 🔴 **必须** | 视觉轨与动力轨**分开供电**（各自的 buck） |
| 🔴 **必须** | 视觉 buck 输入加 **≥1000µF 低 ESR 电解**（原 470µF 不足） |
| 🔴 **必须** | buck 输出加 **470µF + 10µF + 100nF** |
| 🟡 推荐 | 视觉轨输入串**铁氧体磁珠 + 电容**（LC 滤波） |
| 🟡 推荐 | 20kHz PWM（噪声频率远离 buck 带宽） |
| 🟡 推荐 | 视觉轨用**独立 DC-DC** |
| 🟢 可选 | 逻辑与动力**分电池**（最彻底，+130g） |

### 软件侧兜底

1. **心跳检测** —— STM32 监控算力平台心跳，超时 200ms 判定失联
2. **失联即降级** —— 进降级策略 B，不要停在原地
3. **重启后重同步** —— 发 `HELLO`，STM32 回送 `STATE_INFO`

**设计原则：算力平台的失效不能让整车瘫痪。**

---

## 11. 接地策略：单点星型

```
        ┌──────────── 电池负极（星点）────────────┐
        │              │              │           │
   BTS7960 GND    buck1 GND      buck2 GND   STM32 GND
   （动力地）      （视觉地）      （逻辑地）    （信号地）
```

| 规范 | 说明 |
|---|---|
| 单点接地 | 所有地线汇到一个点（电池负极） |
| 动力线加粗 | **18 AWG** |
| 信号线远离动力线 | 不要并排走线 |
| 电机端子加 **104 陶瓷电容** | 抑制电刷噪声（有刷电机必做） |
| 电机端子加 **TVS（SMBJ15A）** | 吸收感性尖峰 |

---

## 12. 上电时序

```
1. 拨动开关 → 电池接入
2. 逻辑轨先上电 → STM32 复位启动
3. STM32 等 100ms 让电源稳定
4. STM32 拉高 BTS7960 的 EN → 动力轨使能
5. STM32 等算力平台心跳（最多 3s）
6. 开始自检
```

**第 4 步延迟使能**，避免上电瞬间电机抖动导致车体位移。

---

## 13. 电量监测

```
分压比：12.6V → 3.0V，取 R1=39kΩ, R2=10kΩ
        V_adc = V_bat × 10/49 = V_bat × 0.204
        12.6V → 2.57V ✅ / 9.0V → 1.84V ✅
```

| 电压 | 判定 | 动作 |
|---|---|---|
| > 11.0V | 正常 | — |
| 10.5–11.0V | 偏低 | 记录，继续 |
| < 10.5V | 低电量 | 蜂鸣器提示（继续比赛） |

**分压电阻加 100nF 滤波电容**，否则 PWM 噪声会让读数跳动。

---

## 14. 与旧版文档的差异（本文已取代）

| 项目 | 旧值 | 新值 | 原因 |
|---|---|---|---|
| 保险丝 | 10A | **5A 慢熔** | 按实际持续电流 2.67A 定 |
| 电机端电容 | 1000µF | **1000µF（视觉轨）** | RK3588 电流增加 |
| 电流采样 | 无 | **INA240 ×2** | ★ 堵转保护必需 |
| 算力平台功耗 | 2.0W (K230) | 9.0W (RK3588) | 1080p@30 需求 |
| 动力线 | 18 AWG | 18 AWG | 复核后不变 |
