sheepxray/1145141919810wulongjiadao/docs/12-帧率与实时性.md

# 12 · 帧率与实时性

> ⚠️ **方案裁决（2026-09-28）**：仓库已按实际采购定为 **麦轮全向 + K230D + 单 OV5640 + STM32G474 + TB6612**（见 [08 BOM](08-BOM物料清单.md)、[16 商品清单](16-最终商品清单.md)、[10 计划](10-开发计划与里程碑.md)）。本文为早期/旧平台版本，其中与当前采购冲突的选型与指标以 16/17 为准；架构思路与算法结论多数继续沿用。

> ⚠️ **本文部分结论已被 [docs/14](14-1080p视觉管线.md) 取代（第 3 轮迭代）。**
>
> 需求从"30 FPS"升级为 **"1080p@30"** 后：
>
> | 本文原结论 | 现状 |
> |---|---|
> | "采集必须用 720p" | ❌ **已修正** —— 该结论针对 OV5640（零余量）。改用 IMX219 后 1080p@60 有 2× 余量 |
> | "处理前降采样" | ✅ 仍成立，但**新增关键手段：降采样必须用 RGA 硬件** |
> | "两台相机分时复用" | ⚠️ **实际只采购 1 支 OV5640** —— 双相机方案失效，见下方 |
> | 帧预算与延迟分析 | ⚠️ 数值已按 1080p 重算，见 docs/14 |

> ### ⚠️ 双相机方案已失效（实际采购口径）
>
> 本文与 [docs/14](14-1080p视觉管线.md) 都建立在**双相机**基础上
> （前视看棋子/测墙 + 下视读字/伺服）。但**实际只买了 1 支 OV5640**。
>
> | 影响 | 说明 |
> |---|---|
> | 分时复用 | ❌ 单相机无法分时复用，两个任务要**共用同一相机** |
> | 相机安装角 | 需折中（前视 15° 与下视 60° 不可兼得） |
> | 帧率预算 | 单相机无并发，但**模式切换的开销仍在** |
> | 补购 | **下视相机已列为后置补购项**，触发判据见 [docs/10](10-开发计划与里程碑.md) §0 |
>
> 帧率方法论（降采样策略、延迟分析、降级阶梯）**仍然适用**。
>
> **请以 [docs/14](14-1080p视觉管线.md) 为准。** 本文保留作为通用方法论参考。

---

## 1. 结论先行（原 720p 方案，已被取代）

**30 FPS 可达，但有三个不可妥协的前提：**

| # | 前提 | 违反的后果 |
|---|---|---|
| 1 | **采集分辨率降到 720p** | 5MP 只有 15 fps，**硬件上就卡死**，与算力无关 |
| 2 | **处理前降采样，绝不处理全分辨率** | 像素数是 720p 的 5 倍 |
| 3 | **两台相机分时复用** | 任何时刻只有一台需要 30 FPS |

---

## 2. 第一道卡口：传感器帧率上限

**这是最容易被忽略的一环 —— 帧率不是算力问题，先是读出带宽问题。**

OV5640 在 2.8mm 镜头、全画幅 2592×1944（HFOV 65.9°）下：

| 分辨率 | 最高 fps | 满足 30 fps | 满足 60 fps | 像素数 |
|---|---|---|---|---|
| 2592×1944 | **15** | ❌ **不够** | ❌ | 5.0 MP |
| 2048×1536 | 15 | ❌ 不够 | ❌ | 3.1 MP |
| 1920×1080 | 30 | ⚠️ 刚好 | ❌ | 2.1 MP |
| 1280×960 | 45 | ✅ | ❌ | 1.2 MP |
| **1280×720** | **60** | ✅ | ✅ | 0.9 MP |
| 640×480 | 90 | ✅ | ✅ | 0.3 MP |

> ⚠️ **全分辨率 2592×1944 只有 15 fps。** 如果代码里写的是
> `sensor.set_framesize(sensor.QVGA)` 之外的 5MP 模式，
> 那么**无论算法优化到什么程度都不可能到 30 FPS**。
>
> **推荐：720p（60 fps 采集）**，给处理端留 2 倍余量。

**好消息：本任务根本不需要 5MP** —— 见下两节。

---

## 3. 检测棋子需要多少分辨率

棋子直径 45mm。经验阈值：≥20px 可靠检测 / 10–20px 勉强 / <10px 不可靠。

**关键区分：`crop`（裁剪）与 `scale`（缩放/合并）的视场不同。**

| 分辨率 | 距离 | crop 视场 | crop 棋子 | scale 视场 | scale 棋子 |
|---|---|---|---|---|---|
| 720p | 1m | 35.5° | 90.0px | 65.9° | 44.4px |
| 720p | 2m | 35.5° | 45.0px | 65.9° | **22.2px** |
| 720p | 3m | 35.5° | 30.0px | 65.9° | **14.8px** |
| 1080p | 2m | 51.3° | 45.0px | 65.9° | 33.3px |
| 640×480 | 2m | 18.2° | 45.0px | 65.9° | 11.1px |

**判读**：

- **720p + scale 模式**：2m 处棋子 22px、3m 处 15px → **够用**；
- **720p + crop 模式**：2m 处 45px 更清楚，但视场只有 35.5°，**看不宽**；
- **搜索要的是"看宽"** → 用 **scale / 合并** 模式，不要用 crop。

> 5MP 完全没有必要 —— 棋子再大也只是占用更多像素，不带来额外信息。

---

## 4. 读字需要多少分辨率

汉字 20mm，下视相机俯角 60°、高度 150mm，读取距离 250mm。

| 宽度 | 模式 | 视场 | 250mm 处视场宽 | 径向px | 横向px | 可读性 |
|---|---|---|---|---|---|---|
| 2592px | crop | 65.9° | 324mm | 92.4 | 137.2 | 舒适 |
| 1280px | scale | 65.9° | 324mm | 45.6 | 67.8 | 舒适 |
| 640px | crop | 18.2° | **80mm** | 92.4 | 137.2 | ⚠️ **视场不足** |
| **640px** | **scale** | 65.9° | **324mm** | 22.8 | 33.9 | **可读** |
| 320px | crop | 9.1° | **40mm** | 92.4 | 137.2 | ⚠️ **视场不足** |

### ⚠️ 这里有一个陷阱

**crop 模式的汉字像素数恒为 92.4（与裁剪宽度无关），看起来"分辨率越高越清晰"。
但 crop 会同时收窄视场** —— 320px crop 的视场只有 40mm，
**连一枚 45mm 的棋子都装不下**。此时"字很清晰"毫无意义。

**判据不是"汉字多少像素"，而是"视场能不能罩住棋子"。**

**结论**：读字用 **640px scale 模式**即可（视场 65.9°/324mm，汉字 22.8px 可读）。

> 因为读字时**车是静止的**，可以慢慢处理，帧率无要求。
> **读字完全不该占用 30 FPS 的预算。**

---

## 5. 推荐工作点

| 模式 | 相机 | 采集 | 采集fps | 处理分辨率 | 处理fps | 说明 |
|---|---|---|---|---|---|---|
| SEARCH | 前视 | 720p scale | 60 | 640×360 | 30+ | 检测 2m 内棋子 |
| SERVO | 下视 | 720p scale | 60 | **320×160 ROI** | 30+ | 推入段保持居中 |
| READ | 下视 | 720p | 30 | ROI 裁切 | 无要求 | 停车读字 |
| IDLE | — | 关闭 | — | — | — | 省电降温 |

**核心策略：采集用高帧率，处理用低分辨率。**

---

## 6. 帧预算

### SEARCH（前视搜索）

| 阶段 | 耗时 | 关键路径 | 来源 |
|---|---|---|---|
| 取帧（与处理并行） | 0.0 | 否 | [硬件] |
| 降采样到 640×360 | 1.2 | 是 | [预估] |
| `find_blobs` 颜色阈值 + 连通域 | 6.0 | 是 | [预估] |
| 坐标变换 + 候选筛选 | 0.8 | 是 | [预估] |
| UART 打包发送 | 0.3 | 是 | [预估] |
| **合计** | **8.3** | | |

→ **120 FPS 可达**（目标 30 FPS，利用率 25%，在 50% 安全线内）

### SERVO（下视伺服）

| 阶段 | 耗时 | 来源 |
|---|---|---|
| ROI 拷贝 320×160 | 0.4 | [预估] |
| `find_blobs` / 质心 | 2.0 | [预估] |
| UART 打包发送 | 0.2 | [预估] |
| **合计** | **2.6** | |

→ **384 FPS 可达**（余量极大）

### 敏感性

把 [预估] 阶段统一放大后的表现：

| 模式 | ×1.0 | ×1.5 | ×2.0 | ×3.0 |
|---|---|---|---|---|
| SEARCH | 120 FPS | 80 FPS | 60 FPS | 40 FPS |
| SERVO | 385 FPS | 256 FPS | 192 FPS | 128 FPS |

**即使预估偏差 3 倍，两者仍达标。** 反过来说：若不达标，
说明 `find_blobs` 的实现方式有问题 —— 见第 9 节。

> ⚠️ 上表全部是 **[预估]**。**必须用 `firmware/k230/profiler.py` 在真机实测替换**，
> 否则"保证 30 FPS"只是纸面承诺。

---

## 7. 延迟（比帧率更重要）

对控制系统而言，**传感器到执行的延迟**才决定性能：

```
latency = 流水线深度 × 帧周期 + 处理耗时 + 通信 + 执行
        = depth × 33.3ms + 8.3ms + 1.0ms + 2.0ms
```

| 流水线深度 | 总延迟 | 位置滞后* | 占推板半开口 82mm | 评价 |
|---|---|---|---|---|
| **1** | 45ms | **11mm** | **14%** | 余量充足 |
| 2 | 78ms | 19mm | 24% | 余量充足 |
| 5 | 178ms | 45mm | 54% | **危险** |

\* 按推入段车速 250 mm/s 换算。

**判读**：深度 1 时位置滞后仅 11mm，占推板半开口的一小部分，**不需要降低推入速度**。

但延迟随深度**线性增长且无上界**，所以关键不是"深度等于 1"这个数字，
而是 **绝不让帧队列积压**。

### ★ 关键设计原则：只处理最新帧

```
❌ 错误：queue.put(frame)  → 处理慢时队列无界增长，延迟无界增长
✅ 正确：self.latest = frame  → 处理端永远取最新帧，旧的直接丢
```

**这是视觉伺服的经典翻车方式** —— 用无界队列时，一旦某一帧处理变慢，
后续每一帧都会更旧，最终车会按"1 秒前的场地状态"来控制。

---

## 8. 双相机：不要同时跑 30 FPS

直觉上"两个相机都 30 FPS"意味着 60 帧/秒的处理量，但**实际需求是错开的**：

| 状态 | 前视 | 下视 | 说明 |
|---|---|---|---|
| SEARCH | 30 FPS | 关闭 | 巡场找棋子 |
| APPROACH | 30 FPS | 关闭 | 开向棋子 |
| ALIGN / READ | 关闭（或 5 FPS） | 静止，无帧率要求 | 停车读字 |
| **PUSH** | 5–10 FPS（仅避障） | **30 FPS** | 视觉伺服 |
| REPOSITION | 30 FPS | 关闭 | 退出并重定位 |

**任何时刻只有一台相机需要 30 FPS。**

这正好对应 [docs/11](11-通信协议.md) 里已定义的 `MODE_CMD`
（IDLE / SEARCH / CLASSIFY / SERVO）—— 用模式切换把处理负载集中到当前真正需要的那一路。

---

## 9. 会毁掉 30 FPS 的六种写法

| # | 失败模式 | 后果 | 正确做法 |
|---|---|---|---|
| 1 | **Python 逐像素循环** | 比 C 实现慢 **100–1000 倍** | 只用 `image` 模块的 C 方法 |
| 2 | 处理全分辨率 | 像素数是 720p 的 5 倍 | 先降采样再处理 |
| 3 | 两台相机同时跑 30fps | 处理量翻倍 | 分时复用（第 8 节） |
| 4 | 在循环里等 UART 发完 | 阻塞关键路径 | DMA 发送或异步 |
| 5 | 无界帧队列 | 延迟无界增长 | 只保留最新帧（第 7 节） |
| 6 | 循环内分配内存 | GC 抖动导致周期性卡顿 | 预分配缓冲区并复用 |

### 第 1 条是最常见的坑

CanMV 的 `image` 模块方法（`find_blobs`、`find_circles`、`find_rects`、
`mean_pooled`、`resize` 等）都是 **C 实现**，必须优先使用。

一旦写成：

```python
# ❌ 这样写帧率必崩
for x in range(w):
    for y in range(h):
        if img.get_pixel(x, y) == RED:
            ...
```

在 640×360 上就是 23 万次 Python 循环，单帧就可能超过 100ms。

### 第 5 条的正确实现

```python
class LatestFrame:
    """只保留最新帧，丢弃过期帧。"""
    def __init__(self):
        self.frame = None

    def put(self, f):
        self.frame = f          # 直接覆盖，不排队

    def get(self):
        f = self.frame
        self.frame = None       # 取走即清空，避免重复处理
        return f
```

---

## 10. 达不到 30 FPS 时的降级阶梯

| 级别 | 手段 | 做法 | 代价 |
|---|---|---|---|
| 1 | 减少 ROI | 只处理推板前方区域，像素数减半 | 无 |
| 2 | 降低处理分辨率 | 640×360 → 480×270 | 远距离检测变差 |
| 3 | 缩小搜索范围 | 只找 2m 内棋子 | 效率下降 |
| 4 | 前视降到 15–20 FPS | **下视伺服保持 30 FPS** | 搜索变慢，**控制不受影响** |
| 5 | 关掉 CNN 读字 | 走降级策略 B | 无法按分值排序 |

### ★ 关键取舍

> **下视伺服必须保住 30 FPS** —— 它直接决定推入命中率。
> **前视搜索可以降到 15–20 FPS** —— 只是慢一点，不影响单次得分的成功率。

这个取舍很重要：如果资源不够，**砍搜索、保伺服**。

---

## 11. 验证方法

### 步骤 1：预算复核（PC）

```bash
python tools/framerate.py
```

确认各模式在 50% 安全线内。

### 步骤 2：真机实测（K230）

把 [`firmware/k230/profiler.py`](https://github.com/sheepxray/1145141919810wulongjiadao/blob/main/firmware/k230/profiler.py) 拷到 K230 上运行，
它会输出各阶段的真实耗时与可达帧率。

### 步骤 3：回填并复核

把实测值填进 `tools/framerate.py` 的 `Budget` 表，
把来源标记从 `[预估]` 改成 `[实测]`，重跑步骤 1。

### 步骤 4：端到端验证

在整车联调时（[M2 阶段](10-开发计划与里程碑.md)）统计：

- [ ] SEARCH 模式实际帧率 ≥ 30 FPS
- [ ] SERVO 模式实际帧率 ≥ 30 FPS
- [ ] 连续运行 3 分钟无帧率衰减（排除内存泄漏/发热降频）
- [ ] 延迟实测 < 60ms

---

## 12. 与其他文档的关系

| 文档 | 关联 |
|---|---|
| [docs/03](03-电控与驱动系统.md) | 控制环频率（1kHz 速度环 / 500Hz 航向环）远高于视觉，不受影响 |
| [docs/04](04-视觉识别系统.md) | 识别流程需按本文约束重写：分阶段 + 降采样 |
| [docs/07](07-软件架构与决策策略.md) | 状态机对应 MODE_CMD 的模式切换 |
| [docs/11](11-通信协议.md) | `MODE_CMD` 是分时复用的实现手段 |

### ⚠️ 本次约束对已发布文档的修正

本文引入 30 FPS 硬指标后，[docs/04](04-视觉识别系统.md) 中的
"移动中做 blob 检测"**必须限定为降采样后进行**，
且**不能以全分辨率运行**。这条约束优先于该文档中的原有描述。
