sheepxray/1145141919810wulongjiadao/docs/13-主控与算力平台.md

# 13 · 主控与算力平台

> 🗄️ **历史五轮档案（旧平台）**：本文是五轮迭代「第 2 轮」的产物，基于旧平台（差速 + RK3588 / H723 / 双 IMX219 / BTS7960）。结论已被实际采购方案部分或全部取代，仅作方法与数据档案保留；当前方案见 [16 商品清单](16-最终商品清单.md)，新判断见 [17 电机参数](17-实际电机参数核对.md) / [10 计划](10-开发计划与里程碑.md)。

> **第 2 轮迭代的产物。** 所有数值可用 `python tools/compute_budget.py` 复现。
>
> **本文回答：STM32G431 到底弱不弱、该换成什么。**

---

## 1. 结论先行

**"太弱"这个判断需要分两个层面看 —— 而且两个层面的答案不同。**

| 环节 | 需求 | G431 现状 | 判断 |
|---|---|---|---|
| 控制环 CPU | 3.6 M 指令/秒 | 占用 **2%** | **不是瓶颈** |
| 控制环 RAM/Flash | 7KB / 27KB | 占用 21% / 21% | 当前够，**扩展受限** |
| **视觉预处理 CPU** | 需 1080p@30 | K230 仅 800 MOPS | **★ 真正的瓶颈** |
| 视觉 NPU | 6 TOPS | 小 CNN 够用 | 不是瓶颈 |

**推荐配置**：

| 项目 | 选型 | 价格 |
|---|---|---|
| 运动主控 | **STM32H723** | ¥130 |
| 视觉平台 | **RK3588 板** | ¥680 |
| 合计 | | ¥810（原 ¥244，+¥566） |

---

## 2. 关键洞察：瓶颈在 CPU 侧，不在 NPU 侧

这是本轮最重要的发现。

**直觉**：1080p@30 需要更强算力 → 换更强的 NPU。

**实际**：NPU 算力**从来不是瓶颈**。6 TOPS 跑一个 7 类小 CNN 绰绰有余。
真正的瓶颈是**图像预处理**（降采样、色彩转换、阈值分割、连通域标记）——
**这些跑在 CPU 上，不在 NPU 上。**

| 平台 | CPU | CPU 算力 | NPU |
|---|---|---|---|
| K230 | 2×RISC-V + 1×RV64 | **800 MOPS** | 6 TOPS |
| RK3576 | 4×A72 + 4×A53 | 12000 MOPS | 6 TOPS |
| **RK3588** | 4×A76 + 4×A55 | **20000 MOPS** | 6 TOPS |
| Jetson Orin Nano | 6×A78AE | 25000 MOPS | 40 TOPS |

**K230 的 CPU 只有 RK3588 的 1/25，而 NPU 相同。**
这解释了为什么"K230 有 6 TOPS 但跑 1080p@30 仍吃力"。

---

## 3. 控制环负载分析（回答"G431 弱不弱"）

### 1 kHz 主循环的任务分解

| 任务 | 指令/次 | 频率 | k指令/s |
|---|---|---|---|
| 速度环 PID ×2 | 800 | 1000 | 800 |
| 航向环 PID | 400 | 500 | 200 |
| 差速运动学 | 300 | 1000 | 300 |
| PWM 更新 | 200 | 1000 | 200 |
| 编码器解码 | 250 | 1000 | 250 |
| IMU 读取 (SPI) | 600 | 1000 | 600 |
| 航迹推算 (EKF) | 900 | 1000 | 900 |
| 堵转/限流检测 | 300 | 1000 | 300 |
| UART 收帧解析 | 500 | 100 | 50 |
| 状态机 tick | 400 | 100 | 40 |
| 日志/调试 | 300 | 10 | 3 |
| **合计** | | | **3.6 M 指令/秒** |

### 各 MCU 占用率

| 型号 | 内核 | DMIPS | 浮点折算后 | 占用率 | 评价 |
|---|---|---|---|---|---|
| STM32F103 | M3 | 90 | 14.3M | 15.9% | 充裕 |
| **STM32G431** | M4F | 212 | 4.3M | **2.0%** | 充裕 |
| STM32G474 | M4F | 212 | 4.3M | 2.0% | 充裕 |
| **STM32H723** | M7 | 1177 | 3.6M | **0.3%** | 充裕 |
| STM32H743 | M7 | 1027 | 3.6M | 0.4% | 充裕 |

> **STM32G431 跑 1 kHz 控制环的 CPU 占用率只有 2%。**
> 它**不是**瓶颈 —— 1 kHz 双环 PID + EKF 对 M4F@170MHz 很轻松。

---

## 4. ★ 内存预算 —— 才是 G431 真正会卡住的地方

**CPU 占用率低不代表够用。嵌入式项目更常见的是内存不够。**

| 项目 | RAM (B) | Flash (B) | 说明 |
|---|---|---|---|
| EKF 状态与协方差 | 800 | 2000 | 6 状态，双精度 |
| 棋子地图 (32 枚) | 512 | 1024 | 位置+类别+状态 |
| 视觉目标列表 | 320 | 800 | 8 项 × 40 字节 |
| UART 收发缓冲 | 512 | 512 | DMA 双缓冲各 256 |
| 控制环状态 | 256 | 800 | 两个 PID + 运动学 |
| IMU 滤波与标定 | 256 | 600 | 零偏、滑动平均 |
| 状态机上下文 | 256 | 1500 | FSM + 路径规划 |
| 日志/调试缓冲 | 512 | 512 | 环形缓冲 |
| HAL 库开销 | 1500 | 20000 | HAL + 中断向量 |
| 栈（主+中断） | 2048 | 0 | 保守估计 |
| **合计** | **6964 B (6.8KB)** | **27748 B (27.1KB)** | |

| 型号 | Flash/RAM KB | RAM 占用 | Flash 占用 | 评价 |
|---|---|---|---|---|
| STM32F103 | 64/20 | 34% | 43% | 吃紧 |
| **STM32G431** | **128/32** | **21%** | **21%** | 当前够 |
| STM32G474 | 512/128 | 5% | 5% | 充裕 |
| **STM32H723** | **1024/564** | **1.2%** | **2.6%** | 充裕 |
| STM32H743 | 2048/1024 | 0.7% | 1.3% | 充裕 |

### G431 看似有余量，但这是"当前功能"的需求

以下**任一情况**就会超：

- 更精细的地图（栅格 10cm → 60×40 = 2400 格）
- 更完整的 EKF/UKF（状态数翻倍）
- 比赛数据记录（用于复盘调参）
- 预测控制（MPC 需要矩阵运算缓冲）
- 引入 RTOS（FreeRTOS 任务栈开销）

> **这才是更换主控的真正理由** —— 不是 CPU 算力不够，
> 而是 RAM/Flash 对**未来 5 轮迭代扩展**的限制。

---

## 5. 架构方案对比

| 方案 | 组合 | 优点 | 缺点 | 结论 |
|---|---|---|---|---|
| A. 双芯片（现状） | G431 + K230 | 实时性最好 | K230 CPU 弱，1080p@30 吃力 | **不满足新需求** |
| B. 双芯片（都升级） | H723 + RK3588 | 双端都强 | 成本最高 | 可行 |
| **C. 双芯片（MCU 适度）** | **H723 + RK3588** | 视觉强、成本可控 | MCU 有余量 | **推荐** |
| D. 单芯片 | RK3588 直控电机 | 省一颗芯片 | **Linux 无 1kHz 确定性** | **否决** |

### 方案 D 为什么否决

**Linux 的调度抖动在毫秒级，做不了 1 kHz 硬实时控制环。**
电机控制需要确定性中断（编码器采样、PWM 更新、电流环），这是 MCU 的领域。

即使 RK3588 有 25 倍算力，它也不能替代 MCU 做控制。

---

## 6. 推荐：STM32H723

| 参数 | H723 | G431 | 倍数 |
|---|---|---|---|
| 内核 | Cortex-M7 @550MHz | Cortex-M4F @170MHz | 3.2× |
| FPU | **双精度** | 单精度 | — |
| DMIPS | 1177 | 212 | 5.5× |
| RAM | **564 KB** | 32 KB | **18×** |
| Flash | 1024 KB | 128 KB | 8× |
| 价格 | ¥130 | ¥45 | +¥85 |
| 控制环占用 | 0.3% | 2.0% | — |

**为什么值得**：

- 在 5 轮迭代、还要加字符识别与优先级算法的背景下
- **+¥85 换来 18 倍 RAM**，消除"内存不够"这个未来风险
- 双精度 FPU 让 EKF 不必担心精度取舍

---

## 7. 视觉平台：RK3588

| 平台 | CPU 算力 | NPU | 功耗 | 质量 | 价格 | 1080p@30 |
|---|---|---|---|---|---|---|
| K230 | 800 MOPS | 6 TOPS | 2.0W | 30g | ¥199 | **吃力** |
| RK3576 | 12000 MOPS | 6 TOPS | 5.0W | 60g | ¥420 | 可行 |
| **RK3588** | **20000 MOPS** | 6 TOPS | 9.0W | 85g | ¥680 | **宽裕** |
| Jetson Orin Nano | 25000 MOPS | 40 TOPS | 12.0W | 150g | ¥1600 | 宽裕（超预算） |

**决策：RK3588** —— CPU 算力是 K230 的 25 倍，1080p@30 有余量。

### 代价

| 项目 | 变化 | 影响 |
|---|---|---|
| 功耗 | 2.0W → 9.0W | 5V 轨电流 0.40A → 1.80A |
| 质量 | 30g → 85g | +55g（质量预算内） |
| 价格 | ¥199 → ¥680 | +¥481 |

> 功耗增加的影响已在 [docs/06](06-电源系统.md) 处理：
> 持续总电流从 1.27A 涨到 2.67A，续航仍有 34 分钟，远超 3 分钟需求。

---

## 8. 对既有文档的修订

| 文档 | 修订内容 |
|---|---|
| [docs/03](03-电控与驱动系统.md) | 主控改为 H723；引脚分配需重做（H723 外设更多） |
| [docs/06](06-电源系统.md) | 视觉轨要求 ≥5A（RK3588 需 1.8A） |
| [docs/07](07-软件架构与决策策略.md) | 跨核通信带宽需复核（1080p 数据量） |
| [docs/08](08-BOM物料清单.md) | BOM 全面更新 |
| [docs/12](12-帧率与实时性.md) | 工作点从 720p 改回 1080p |

---

## 9. 待验证事项

| 事项 | 方法 | 目标 |
|---|---|---|
| H723 控制环实测占用 | DWT 周期计数器 | < 5% |
| RK3588 的 1080p@30 实测 | 在真机上跑 profiler | ≥ 30 FPS |
| RK3588 与 H723 的 UART 延迟 | 往返时延测量 | < 5ms |
| RK3588 的启动时间 | 冷启动计时 | < 20s（影响上电自检） |

> ⚠️ **RK3588 的启动时间是个新风险** —— Linux 系统冷启动通常 10–30 秒，
> 而比赛要求上电即自启。需要在自检流程中等待视觉平台就绪。
> 详见 [docs/10](10-开发计划与里程碑.md) 的自检步骤。

---

## 10. 结论

> ### ⚠️ 本节的**推荐结论已被推翻**（平台变更）
>
> 本文建议「升级到 RK3588 + H723」，**实际采购走的是相反方向**
> （K230D + G474，规格更低）。因此下表左列不成立。
>
> | 本文推荐 | 实际采购 | 后果 |
> |---|---|---|
> | 视觉 RK3588（CPU 20000 MOPS） | **K230D 128M**（CPU 800 MOPS） | ⚠️ 1080p@30 的 CPU 预算需重估 |
> | 主控 H723（RAM 564KB） | **G474VET6**（RAM ≈128KB） | ⚠️ 内存余量从 18× 降到约 4× |
> | 架构双芯片 | ✅ 双芯片（G474 + K230D） | 结论不变 |
>
> **仍然成立的核心洞察**（这部分**与具体型号无关**）：
>
> 1. **瓶颈在视觉平台的 CPU 侧，不在 NPU** —— K230D 的 NPU 是 6 TOPS
>    （与 RK3588 相同），但 CPU 只有 800 MOPS，图像预处理是短板
> 2. **控制环对 MCU 不是负担** —— 3.6 M 指令/秒，G474@170MHz 同样轻松
> 3. **MCU 的真正约束是 RAM/Flash，不是算力** —— 这条现在**更关键**：
>    G474 的 128KB 只有 H723 的 1/4，内存预算需重新核算
> 4. **Linux 无法替代 MCU 做 1 kHz 硬实时控制** —— 故仍是双芯片
>
> **需要在新平台上重做的事**：用本文的方法（内存预算表、CPU 占用率模型）
> 按 **G474 + K230D** 重算一遍，见 [docs/10](10-开发计划与里程碑.md) W1。

**原文结论（仅供对照，推荐部分已失效）**：

> **升级的关键在视觉端（K230 → RK3588），因为瓶颈是 CPU 侧的图像预处理，
> 而不是 NPU 算力。**
>
> **MCU 从 G431 换到 H723 是"为迭代留余量"** —— 控制环 CPU 占用只有 2%，
> 真正的约束是 RAM/Flash 对未来功能扩展的限制。
>
> **架构仍是双芯片** —— Linux 无法替代 MCU 做 1 kHz 硬实时控制。
