sheepxray/1145141919810wulongjiadao/docs/17-实际电机参数核对.md

# 17 · 电机与驱动参数核对与设计影响

> 🗄️ **历史档案**：本文是「参数核对与差异记录」，包含旧口径 → 新口径的对照表，
> 因此正文中会**有意保留** JGB37-520 / BTS7960 / φ65 / 差速 等旧方案字样，
> 用于说明哪些结论已失效。**这些旧值不代表当前设计。**
> 当前硬件口径见 [TB6612_MG513X_规格.md](../hardware/electrical/TB6612_MG513X_规格.md)。
>
> **2026-09-28 重写。** 用户提供了 **WHEELTEC TB6612 四路驱动（D24A）官方资料包 V3.2**
> 与 MG513X 商品页参数，**取代**本文此前基于口述参数的版本。
>
> **器件原始规格（权威）** → [hardware/electrical/TB6612_MG513X_规格.md](../hardware/electrical/TB6612_MG513X_规格.md)
> 本文只记录：**新旧口径差异、对既有设计的冲击、必须实测的清单**。

---

## 1. 结论先行

| 问题 | 结论 |
|---|---|
| 电机是什么 | **MG513X**，12 V，**1:28**，空载 **370 rpm**，额定 **300 rpm** |
| 驱动是什么 | **TB6612FNG 四路带稳压板 D24A**（板载 2 片，各 2 路） |
| 车速 | 空载 **1.16 m/s**、额定 **0.94 m/s**（φ60 麦轮），比 0.8 m/s 目标快 18% |
| 堵转电流 | 手册 **3.2 A** ⚠️ **但手册自身不自洽，实测前不能当真**（§3） |
| **最大风险** | ⚠️⚠️ **四路堵转把 TB6612 加热到热保护**（3.2 A 档两片合计 **20.5 W**）；板载 65 °C 保护只关**对外实验电源**，不影响 K230D（§4.3） |
| 第二大风险 | 4 台电机 **680 g**，占整车 1500 g 质量上限的 **45%** |
| 必须做 | 🔴 **堵转降 PWM / 限流保护**（发热是根本矛盾）；视觉独立供电**原设计已满足** |

---

## 2. 新旧口径差异（本文取代旧版）

| 项目 | 旧记录（已废止） | **新记录（权威）** |
|---|---|---|
| 电机型号 | JGB37-520（差速 2 台） | **MG513X（麦轮 4 台）** |
| 减速比 | 1:100 | **1:28** |
| 空载转速 | 300 rpm | **370 ± 12 rpm** |
| 额定转速 | 240 rpm | **300 ± 12 rpm** |
| 额定电流 | 200 mA | **360 mA** |
| 堵转电流 | 500 mA | **3.2 A（手册，待实测）** |
| 额定转矩 | 0.5 kgf·cm | **1 kgf·cm** |
| 堵转转矩 | 4.0 kgf·cm | **4.5 kgf·cm** |
| 单台重量 | 未计 | **0.17 kg** |
| 驱动 | BTS7960 ×2（43 A） | **TB6612FNG 四路 D24A（1.2 A / 3.2 A 峰值）** |
| 轮径 | φ65 橡胶轮 | **φ60 麦轮** |
| 车速（额定） | 0.817 m/s | **0.94 m/s** |

### ★ 哪些旧结论失效了

| 旧结论 | 出处 | 状态 |
|---|---|---|
| 「实际电机堵转仅 0.5 A，驱动选型过剩 43 倍」 | 本文旧版 §7 | ❌ **失效** —— 堵转 ≈1.5 A，TB6612 余量并不宽裕 |
| 「该电机可长期堵转不烧（温升 90 K）」 | 本文旧版 §3 | ❌ **失效** —— 按新参数堵转发热量级完全不同（§4） |
| 「车速 0.817 m/s 正好匹配 0.8 m/s 目标」 | 本文旧版 §8 | ❌ **失效** —— 新车速 0.94 m/s，**偏高** |
| 「两轮共堵转 1.0 A」 | 本文旧版 §5 | ❌ **失效** —— 四轮，且堵转电流大得多 |
| Q10「读数 A vs B 二选一」 | docs/09 | 🔄 **替换** —— 新矛盾是「3.2 A ↔ 4.5 kgf·cm」（§3） |
| 方法：热时间常数 / 安全电流 / 线性模型反推 | 本文 | ✅ **仍有效**，只是参数换新 |

---

## 3. ★ 手册不自洽：必须实测定论

用直流电机线性模型（Kt = Ke）核对手册四参数：

| 取信的一组 | 推算 | 与手册冲突 |
|---|---|---|
| 额定 300 rpm / 1 kgf·cm / 0.36 A（含 I₀=30 mA） | 空载 **386 rpm**、额定 **294 rpm**、绕组 **7.9 Ω**、堵转 **1.51 A** | 手册堵转写 **3.2 A**（差 **2.1×**） |
| 堵转转矩 4.5 kgf·cm + 堵转电流 3.2 A | Kt = 0.139 N·m/A、绕组 3.75 Ω → 空载应为 **823 rpm** | 手册空载写 **370 rpm**（差 **2.2×**） |

**判读**：

- **额定点三参数自洽**（300 rpm / 1 kgf·cm / 0.36 A → 轴功率 3.1 W ↔ 标称 4 W ✅）
  → 额定工况的电气模型可信。
- **矛盾只集中在「堵转电流 3.2 A」与「堵转转矩 4.5 kgf·cm」** —— 二者不能同时成立。
  与旧版（0.5 A ↔ 4.0 kgf·cm 差 2.2 倍）**性质相同，比例也接近**，说明这是该系列商品页的通行口径问题。

### 30 秒实测定论（替代旧 Q10）

> **设计按保守侧（3.2 A）做余量，但必须实测。**

1. **万用表量绕组电阻**（转子转多点取平均，避开换向器死区）
   - ≈ **7.9 Ω** → 堵转 ≈ **1.5 A**（读法 A）
   - ≈ **3.75 Ω** → 堵转 ≈ **3.2 A**（读法 B）
2. **堵转实测电流**：电源限流到 4 A，堵转读电流表 + 热电偶看温升。

> **结论不依赖读数**：两个读法的堵转电流都 **> 1.2 A（TB6612 持续上限）**，
> 所以**堵转保护无论如何都必须做**，只是阈值取 1.2 A 还是 3 A。

---

## 4. 热与电流重新核算

### 4.1 四轮电流预算

| 工况 | 单路 | 四路合计 | @12 V |
|---|---|---|---|
| 额定（直行） | 0.36 A | **1.44 A** | 17.3 W |
| 堵转·读法 A | ≈1.51 A | ≈6.0 A | 72 W |
| 堵转·读法 B（手册） | 3.2 A | **12.8 A** | **154 W** |

### 4.2 ★ TB6612 芯片发热（RDS(on) ≈ 0.5 Ω）

| 单路电流 | 每路发热 | 每片（2 路） | 两片合计 |
|---|---|---|---|
| 0.36 A | 0.065 W | 0.13 W | 0.26 W |
| **1.2 A（持续上限）** | 0.72 W | 1.44 W | **2.88 W** |
| 1.51 A（读法 A） | 1.14 W | 2.28 W | **4.6 W** |
| **3.2 A（峰值）** | 5.12 W | 10.24 W | **20.5 W** |

> TB6612FNG 是 **SOP24 无散热焊盘**封装，靠引线散热。
> **7 W 以上不可能长期承受** → 会触发芯片过温保护，或先触发板级 65 °C 保护。

### 4.3 ★ 过温保护的实际作用范围（已按原理图修正）

> ⚠️ **更正**：早前把这条写成「过温保护切断 5V/3.3V，连坐主控与视觉」——**判断错了**。
> 原理图核对后：过温网络只驱动 **RT8279(U1) 的 EN**，
> 关断的是 D24A 那两路**对外实验电源**（5V 及派生的 3.3V），
> **不切 VM，也不影响 K230D 的独立供电轨**。

真实失效链是：

```
四路电机长时间堵转（顶墙推棋子）
  → 两片 TB6612FNG 发热（3.2 A 档合计 20.5 W）
  → 板温升高 → P_EN 拉低 → RT8279 停 → 板载 5V 失电
  → ⚠️ TB6612FNG 的 VCC(20) 也取自这路 5V → 芯片逻辑掉电 → 输出关断 → 四轮失控滑行
  → K230D / 视觉链路不受影响（独立 buck）
```

**所以根本矛盾是「堵转发热」，而不是「视觉被连坐」。**

### 4.4 车速重新核算

轮周长 = π × 0.060 = **0.1885 m**

| 状态 | 转速 | 车速 |
|---|---|---|
| 空载 | 370 rpm | **1.16 m/s** |
| 额定 | 300 rpm | **0.94 m/s** |

> 比 0.8 m/s 目标**快约 18%**。这不是问题：**靠 PWM 限速**即可，
> 反而多出速度余量（可用占空比覆盖电池压降与负载）。
> 但需注意：**麦轮横移（strafe）时有效速度约为直行的 0.7 倍**，
> 全向运动的速度上限应以横移工况为准。

### 4.5 牵引力（远超需求，瓶颈在抓地力）

| 项目 | 每轮 | 四轮合计 |
|---|---|---|
| 额定扭矩 1 kgf·cm | 3.27 N | **13.1 N** |
| 堵转扭矩 4.5 kgf·cm | 14.7 N | **58.8 N** |

> 平地匀速 1.5 kg 只需 < 1 N。四轮合计 13 N 已经远超摩擦极限，
> **正常工况下轮子先打滑，而不是电机先堵转** —— 除非顶墙/顶车。

---

## 5. 功率与质量预算的影响

### 5.1 质量（🔴 逼近上限）

| 项目 | 数值 |
|---|---|
| 4 × MG513X 电机 | **0.68 kg** |
| 整车上限 | 1.5 kg |
| 电机占比 | **45%** |

> 加上 4 个 60 mm 麦轮、TB6612（19 g）、STM32（~30 g）、K230D（~30 g）、
> OV5640、3S 2600 mAh 电池（~200 g）、推板与底板，
> **超 1.5 kg 的风险很高**。必须**先称重再定结构**，见 [docs/16](16-最终商品清单.md)。

### 5.2 电流与保护件

| 项目 | 旧选型 | 新口径 |
|---|---|---|
| 保险丝 | 5 A 慢熔 | ⚠️ 四路堵转 12.8 A（读法 B）→ **主保险丝 ≥15 A 或分级保护**，待实测 |
| 动力线 | 18 AWG | 额定 1.44 A 够细线，**但堵转工况保留 18–20 AWG** |
| 电流采样 | INA240 ×2（推荐） | **仍推荐**，理由从「防烧电机」变为「堵转诊断 + 保护驱动板」 |

---

## 6. 设计处置（已落到其他文档）

| # | 措施 | 落点 | 优先级 |
|---|---|---|---|
| 1 | **堵转降 PWM 保护**：目标速度非零且实测≈0 超 200 ms → PWM 降到 ~30%，上报决策层 | [docs/03](03-电控与驱动系统.md) §5 | 🔴 |
| 2 | **视觉独立供电**（原设计已满足，复核即可）；可选把逻辑 3.3V 也改独立 | [docs/06](06-电源系统.md)、[接口定义](../hardware/electrical/接口定义.md) | 🟡 |
| 3 | **STBY 由 GPIO 控制**（软急停），不要只靠跳线帽常高 | [接口定义](../hardware/electrical/接口定义.md) | 🔴 |
| 4 | PWM **10 kHz**（手册推荐） | [docs/03](03-电控与驱动系统.md) | 🔴 |
| 5 | 电机端子加 **104 陶瓷电容**（板上有 TVS，但无电机端 RC） | [接口定义](../hardware/electrical/接口定义.md) | 🟡 |
| 6 | 先**实测称重**再定结构 | [docs/16](16-最终商品清单.md) | 🔴 |
| 7 | 堵转限流（INA240） | [docs/06](06-电源系统.md) | 🟡 |

---

## 7. 必须实测清单（开工前）

| # | 项目 | 方法 | 判据 |
|---|---|---|---|
| 1 | 电机绕组电阻 | 万用表，转子转多点 | **7.9 Ω 或 3.75 Ω** |
| 2 | 真实堵转电流 | 电源限流 4 A + 堵转 | 记录稳定值 |
| 3 | 编码器线数 | 输出轴手转 1 圈，数单相脉冲 | 应为 **364 P/r** |
| 4 | 编码器 VCC/GND 线序 | 万用表 | 反接会烧霍尔 |
| 5 | 驱动板版本 | 看板上 "1.1" 丝印 | 决定有无反接保护 |
| 6 | 驱动板温升 | 四路 1.2 A 连续 3 min，热电偶贴 TB6612 | 是否触碰 65 °C |
| 7 | 板级保护行为 | 人为升温 > 65 °C | 确认**对外 5V/3.3V** 是否切断（不应影响 VM 与 K230D） |
| 8 | 5V 带 K230D | K230D 满载 + 电机换向 | 是否 brownout |
| 9 | 整车称重 | 电子秤 | ≤ 1500 g |

> 复现计算：`python tools/drive_check.py`（主校核）、`python tools/motor_consistency.py`（参数一致性）

---

## 8. 总结

> **实际器件比旧假设「更大、更强、更重、更危险」：**
>
> 1. 🔴 **堵转发热**是最大风险 —— 3.2 A 档两片合计 20.5 W，会触发 TB6612 热保护/板级保护；**必须做堵转降 PWM**
> 2. 🔴 **堵转保护必须做** —— 无论 1.4 A 还是 3.2 A 都超 TB6612 的 1.2 A 持续能力
> 3. ⚠️ **手册堵转参数不自洽 2.2 倍**，必须量绕组电阻定论
> 4. ⚠️ **4 台电机 680 g** 占质量上限 45%，**先称重再定结构**
> 5. ✅ **车速 0.94 m/s** 高于 0.8 m/s 目标 —— 用 PWM 限速，是余量而非问题
> 6. ✅ **牵引力远超需求**，瓶颈在抓地力
