sheepxray/1145141919810wulongjiadao/docs/18-采购记录_20260928.md

# 18 · 采购记录（2026-09-28）

> 数据来源：淘宝「已买到的宝贝」导出的 `订单数据.xlsx` 与 `订单数据 (1).xlsx`，下单时间均为 2026-09-27。
> 口径：**商品金额 = 单价；实付金额 = 该订单首行合计**。状态「卖家已发货」→ 待收货；「买家已付款」→ 待发货。
> 记录日期：2026-09-28（周一）。
> ⚠️ 物流单号已脱敏（本仓库公开，单号可关联收件信息）；快递公司保留。
>
> 🗄️ **历史档案**：下方「与原方案差异」等小节**没有删除**旧方案字样
> （RK3588 / H723 / IMX219 / BTS7960 / 3S 1500mAh 等），
> 目的是记录本次采购相对原计划的变化，**不代表当前设计**。
> 当前硬件口径见 [16 商品清单](16-最终商品清单.md) 与
> [TB6612_MG513X_规格.md](../hardware/electrical/TB6612_MG513X_规格.md)。

## 1. 总览

| 项目 | 数值 |
|---|---:|
| 订单数 | **13** 单 |
| 明细行数 | 16 行 |
| 商品合计 | **¥739.71** |
| 运费合计 | ¥11.30 |
| 实付总计 | **¥751.01** |
| 待收货（卖家已发货） | 12 单 |
| 待发货（买家已付款） | 1 单 |

## 2. 逐单明细

| # | 订单号(尾4) | 状态 | 店铺 | 商品 | 型号/规格 | 数量 | 单价 | 小计 | 运费 | 物流 | 物流单号 |
|---:|---|---|---|---|---|---:|---:|---:|---:|---|---|
| 1 | 3841 | ✅ 已发货 | 创芯工坊 | 烧录器 PowerWriter LINK2 | PWLINK2 Lite | 1 | ¥18.90 | ¥18.90 | — | 京东快递 | （已脱敏） |
| 2 | 9419 | ✅ 已发货 | touglesy旗舰店 | 洞洞板 双面喷锡 | 6*8cm | 2 | ¥3.05 | ¥6.10 | — | 中通快递 | （已脱敏） |
| 3 | 9419 | ✅ 已发货 | touglesy旗舰店 | 杜邦线 三款组合 | 15cm 共120根 | 1 | ¥8.12 | ¥8.12 | — | 中通快递 | （已脱敏） |
| 4 | 5429 | ✅ 已发货 | 源营旗舰店 | RV 电线 | RV1 黑 5米 | 1 | ¥6.80 | ¥6.80 | — | 申通快递 | （已脱敏） |
| 5 | 4611 | ✅ 已发货 | 众恒电子厂 | SM-2P 端子线 公母各5条 | 2.54mm 20cm | 1 | ¥5.60 | ¥5.60 | — | 邮政快递包裹 | （已脱敏） |
| 6 | 0621 | ✅ 已发货 | wheeltec品牌店 | MG513X 直流减速电机+支架 | 13线霍尔编码器 | 4 | ¥42.00 | ¥168.00 | — | 中通快递 | （已脱敏） |
| 7 | 0621 | ✅ 已发货 | wheeltec品牌店 | TB6612 四路驱动模块 | 带稳压版 | 1 | ¥60.70 | ¥60.70 | — | 中通快递 | （已脱敏） |
| 8 | 6630 | ✅ 已发货 | 本画旗舰店 | 快速接线端子 | 二进六出 2只装 | 1 | ¥4.80 | ¥4.80 | — | 圆通速递 | （已脱敏） |
| 9 | 5812 | ✅ 已发货 | 菡诚旗舰店 | 面包板 400孔 | 带背胶 | 1 | ¥3.96 | ¥3.96 | — | 圆通速递 | （已脱敏） |
| 10 | 5812 | ✅ 已发货 | 菡诚旗舰店 | 跳线 | 一扎65根 | 1 | ¥4.75 | ¥4.75 | — | 圆通速递 | （已脱敏） |
| 11 | 1004 | ✅ 已发货 | 麦德斯电子 | DC-DC 多路电源模块 | 3.3V/5V 多路 | 1 | ¥14.50 | ¥14.50 | ¥2.50 | 中通快递 | （已脱敏） |
| 12 | 8649 | ✅ 已发货 | 松甲科技机器人商城 | 麦克纳姆轮 60mm 一套4个 | 6mm 金属联轴器 | 1 | ¥40.00 | ¥40.00 | ¥3.80 | 中通快递 | （已脱敏） |
| 13 | 7831 | ✅ 已发货 | 尚启泽旗舰店 | 庐山派 Lite-K230D-CanMV 开发板 | 128M K230D | 1 | ¥233.68 | ¥233.68 | — | 圆通速递 | （已脱敏） |
| 14 | 7013 | ✅ 已发货 | 德创信摄像头 | OV5640 摄像头模块 自动对焦 | 500万 | 1 | ¥45.80 | ¥45.80 | ¥5.00 | 顺丰速运 | （已脱敏） |
| 15 | 0238 | ✅ 已发货 | 深圳市优信电子科技有限公司 | STM32G474VET6 核心板 | 170MHz | 1 | ¥60.00 | ¥60.00 | — | 圆通速递 | （已脱敏） |
| 16 | 1439 | 🟡 已付款 | 塔克创新品牌店 | 12V 锂电池组 3S | 2600mAh + 1.5A充电器 | 1 | ¥58.00 | ¥58.00 | — | — | — |

## 3. 与现有 BOM 对照（⚠️ 待确认冲突）

采购清单与仓库现有方案（`08-BOM物料清单.md` → `16-最终商品清单.md`）存在**多处实质差异**，记录如下，待你确认哪份为准：

| 项 | 实际购买 | 现有 BOM/方案 | 说明 |
|---|---|---|---|
| 电机 | MG513X 13线霍尔编码器 ×4 | JGB37-520 12V 霍尔编码器 ×2 | 同为编码器减速电机，但型号/数量均不同；MG513X 常见于麦轮底盘 |
| 驱动 | TB6612 四路驱动 ×1 | BTS7960/IBT-2 ×2 | **08/16 两版均明确“不要买 TB6612FNG”**（1.2A 连续带不动 520 堵转）。需确认是否改方案 |
| 轮子 | 麦克纳姆轮 60mm ×4 | φ65 橡胶轮 ×2 + 万向球 | **16 章明确“麦克纳姆轮套装——不要买”**。麦轮意味着整车驱动方案可能改为全向底盘 |
| 主控 | STM32G474VET6 ×1 | 16 章 STM32H723（08 章 G431） | G474 是 G4 高端（170MHz，高分辨率定时器），RAM 约 128KB，远小于 H723 的 564KB |
| 视觉主控 | 庐山派 Lite-K230D-CanMV 128M | 16 章 RK3588（08 章 K230 CanMV） | K230D 128M 是低配，算力/内存低于 RK3588，1080p 视觉管线需重新评估 |
| 相机 | OV5640 自动对焦 ×1 | 16 章 IMX219 ×2 + 备用 | 只买了 1 支；OV5640 1080p 恰 30fps（零余量），且缺下视相机 |
| 电池 | 12V 2600mAh 锂电组 + 充电器 | 3S 1500mAh 25C LiPo | 电压一致(3S≈12V)、容量更大，且自带 1.5A 充电器；锂电组更安全，此改动基本无害 |
| 下载器 | PowerWriter LINK2 (PWLINK2 Lite) | ST-Link V2 | LINK2 兼容 ST-Link，功能更全，价 ¥18.90 高于核价 ¥6.20 |
| DC-DC | 多路 3.3V/5V 电源模块 | 12V→5V ≥5A + 5V→3.3V 2A | 接口/电流规格需到货确认是否满足 RK3588(1.8A)/整机负载 |

## 4. 已确认无冲突的辅助件

以下为通用线材/工具/搭建耗材，BOM 未单列或属通用件，不冲突：洞洞板×2、杜邦线、RV线、SM-2P端子线、接线端子、面包板+跳线。

## 5. 结论与建议

1. **已实付 ¥751.01**（商品 ¥739.71 + 运费 ¥11.30），全部下单于 2026-09-27，13 单中 12 单已发货待收货、1 单（电池）待发货。
2. 采购清单呈现的是**一套典型全向轮小车配置（麦轮 ×4 + MG513X ×4 + TB6612 + K230D + OV5640 + G474）**，与仓库「推板/橡胶轮 + BTS7960 + RK3588 + IMX219 + H723」方案差距明显。
3. **建议确认**：本次采购是否对应同一份最终方案？若方案已改，应回写 `16-最终商品清单.md` 与 `08-BOM物料清单.md`，避免后续按旧 BOM 补料。
