sheepxray/1145141919810wulongjiadao/firmware/stm32/wulong_fw/docs/测试记录_20261020_IMU_PID_K3.md

# 测试记录：IMU / 四轮速度环 / K3 自动回归

日期：2026-10-20  
固件：`wulong-fw 2026-10-21 k2-15s-k3-gyro-rate6`  
平台：STM32G474VETx + TB6612 D24A + 4x MG513X + ICM-20602  
条件：车轮架空，通过 PWLINK2 SWD 读取 RAM；PWLINK2 虚拟串口未收到 MCU 回包。

## 1. 陀螺仪

固件参数：

- 量程：`+/-500 dps`；
- 上电预热：`10 s`；
- 静态校准：2000 点（约 2 s）；
- 静止判定：X/Y `<0.50 dps`、Z `<0.80 dps`、
  `|加速度模长-基准|<0.05 g`，连续满足 `300 ms`；
- 静止零偏跟踪时间常数：`10 s`；
- 航向积分：梯形积分；
- roll/pitch：0.98 陀螺 + 0.02 加速度互补滤波；
- 陀螺饱和检测阈值：原始值 `±32000`。
- 初始化参考逐飞例程增加：复位完成轮询、写后回读校验；
- 不采用参考例程的 `±2000 dps` 配置和 `/131` 换算，避免 12.2 倍比例错误。

本次自动校准结果：

| 指标 | 结果 |
|---|---:|
| WHO_AM_I / ready | `0x12 / ready=1` |
| X 零偏 | `+0.5525 dps` |
| Y 零偏 | `+0.8181 dps` |
| Z 零偏 | `+0.2038 dps` |
| 校准区间最大波动 | `0.840 dps` |
| 重力模长基准 | `0.9955 g` |
| 陀螺饱和累计 | `0` |
| roll / pitch | `+0.77° / +1.89°` |

结论：

- 预热、三轴零偏、重力模长基准、静止判定和互补滤波均已工作；
- 静止判定未通过时自动停止零偏跟踪，避免把慢速真实转动误当成温漂；
- 动态比例、轴向符号和 360° 转角仍需落地旋转或手动精确转一圈验证。

## 2. 四轮速度环 / PWM

最终参数：

- `Kp=5.0 / Ki=15.0 / Kd=0`；
- 前馈：`1.02 permille/(mm/s)`；
- 静摩擦补偿：`18 permille`；
- 反馈：3 点中值 + 25 ms 低通；
- C 路：3 点中值 + 40 ms 低通；
- 正常占空比上限：30%。

`STUNE` 自动阶跃结果（四轮架空）：

| 目标 | 最大均值误差 | A/B/D 纹波 | C 纹波 | 90% 上升时间 |
|---|---:|---:|---:|---:|
| 100 mm/s | 0.45% | 15.3~19.6 mm/s | 22.4 mm/s | 47~57 ms |
| 150 mm/s | 0.32% | 14.2~19.3 mm/s | 30.4 mm/s | 37~40 ms |
| 200 mm/s | 0.23% | 16.0~21.4 mm/s | 39.8 mm/s | 18~29 ms |

结论：四轮稳态精度均优于 1%，满足此前 1 m 直行误差 <1% 的速度环前提。
C 路仍存在比其它轮更强的编码器串扰，需继续检查 C 路编码器线与动力线分离、共地和插头压接。

## 3. K3 自动流程

实现流程：

1. 停车并拉低 `STBY`；
2. 静止采集 2000 点陀螺仪零偏；
3. 随机选择左/右转与 `2200~2999 mrad/s` 目标角速度；
4. 轮速闭环旋转 5 s；
5. 制动 250 ms；
6. 陀螺仪角度闭环回零航向，采用“脉冲 → 滑行 → 静止验证”循环；
7. 航向回正后保持原航向，用麦轮 `vx/vy` 二维平移回到原点；
8. 位置闭环接近原点后再次复核航向和位置，停车并拉低 `STBY`。

180° 边界修正：

- 角度解缠改为 `atan2(sin, cos)`，不再让 `roundf` 在 ±180° 处选边；
- ±180° 时按原始角度的符号选择回程方向；
- 2026-10-20 落地追踪发现底盘 `+omega` 实际产生负陀螺航向；修正
  `body_to_wheel_speeds()` 的原地旋转符号，使“CCW 正方向”端到端一致；
- “位置已回零、只有航向不对”时重新进入航向闭环，不再误入回原点路径；
- 每次回正后必须停车静止 350 ms，再读取 IMU 复核；未通过才允许下一次短脉冲；
- 纯旋转命令 `vx=0` 时不再把左右轮平均里程积分成平移，消除 C 路噪声
  和轮速差异造成的虚假位置误差；
- 40 组仿真角度（含 ±180°、±540°、随机大角度）全部单调收敛且无目标穿越。

架空验证：

- 校准、随机旋转、5 s 硬超时、自动制动和错误停车均正常；
- 最终版快速旋转一轮回到 `x=-1.20 mm / yaw=-0.57 mrad`，结果 `OK`；
- 旧版架空时可能报 `BEARING_TIMEOUT`；最终版已删除“先转向原点再直行”的
  非完整路径，改为保持航向的麦轮二维平移。

落地验证时必须确认：

- K3 旋转后能自动回到原航向，目标误差 `<10 mrad`；
- 原地旋转中心漂移 `<20 mm`；
- 若发生 20~120 mm 偏移，回位过程不超时；
- 串口/调试器发送 `S` 或 `E` 时立即停车。

### K3 陀螺追踪记录

固件内置 50 Hz 追踪缓冲，记录状态、目标角速度、三轴角速度、三轴零偏、
航向误差和位置误差。最近一次架空测试：

| 项目 | 结果 |
|---|---:|
| 校准阶段 | `2.02 s` |
| 旋转阶段 | `5.00 s / 250 点` |
| 目标角速度 | `-2719 mrad/s` |
| 旋转阶段航向变化 | `0.01 mrad` |
| 旋转阶段 GZ 均值 | 约 `0.000 °/s` |
| 旋转阶段静止判定占比 | `94.4%` |
| 制动阶段 | `0.24 s` |
| 回正阶段 | `0.58 s` |
| 最终航向误差 | `0.18 mrad` |
| 最终位置误差 | `0.03 mm` |

判读：电机目标角速度存在，但车体没有真实偏航，说明本次测试车轮架空，
IMU 没有看到车体旋转。因此该次记录只能证明采样、校准、状态机和停车链
正常，不能用于判断落地时的 180° 偏差或机械震荡。

#### 最终落地验证

| 项目 | 结果 |
|---|---:|
| 旋转目标 | `+2632 mrad/s` |
| 旋转阶段航向变化 | `+8653.24 mrad`（同号） |
| 回正起始误差 | `-2449.41 mrad` |
| 回正结束误差 | `-9.53 mrad`（`-0.55°`） |
| 回正反向穿越次数 | `0` |
| 最终位置 | `x=2.26 mm, y=0.85 mm`（约 `2.41 mm`） |
| 最终结果 | `OK` |

结论：180° 偏差的根因是底盘角速度符号与 IMU 正方向不一致，控制环
此前一直在错误方向追目标。修正后回正误差单调减小，无来回震荡，落地
K3 通过。

#### 大角度回正回归（>45°）

固定长脉冲方案在误差大于 45° 时会把大角拆成多次“转一段再停”，惯性
叠加后容易超调。现改为参考项目的连续角度外环：

- 大角度时按角度误差连续限速旋转；
- 接近目标时用实测 Z 轴角速度主动制动；
- 进入小角度窗口后滑行 220 ms、静止 350 ms，再验证航向；
- 验证失败才重新进入连续角度控制，而不是继续发固定长脉冲。

本轮回正起始误差为 `2672.01 mrad`（约 `153.1°`），最终误差
`7.91 mrad`（约 `0.45°`），最大小角度超调约 `21 mrad`（`1.2°`），
最终位置漂移约 `0.1 mm`，结果 `OK`。

#### 电机抖动与高频震荡修正

轨迹暴露出两个独立问题：

1. 角度外环直接使用未滤波的 `GZ`，把陀螺/轮速噪声变成电机抖动；
2. 过强的 PWM 斜率限制会让响应变慢，因此最终没有保留。

处理：

- K3 回正使用 40 ms 陀螺角速度低通；
- 目标角速度限制为约 `4 rad/s²`；
- 连续角度控制只在真正进入验收窗口后滑行；
- 误差过零立即退出继续追角，避免高频正反切换。

对比：

| 指标 | 修正前 | 修正后 |
|---|---:|---:|
| 大角度 GZ 换向率 | 约 `17 次/秒` | 约 `4.7 次/秒` |
| 航向误差反向穿越 | 可能多次 | `0` |
| K3 结果 | 震荡/验证失败 | `OK` |

最终一轮：

- 低角度起始误差：`82.3 mrad`（约 `4.7°`）
- 回正结束误差：`19.2 mrad`（约 `1.10°`）
- GZ 标准差：`4.74 °/s`
- 航向误差反向穿越：`0`
- 位置误差：约 `0.13 mm`
- 结果：`OK`

#### 精度优化三次统计

将 K3 航向验收从 `20 mrad` 收紧到 `8 mrad`，并把小角度最小启动门限
降到 `4 mrad` 后，连续测试三次：

| 次数 | 起始误差 | 最终误差 | 位置误差 | GZ 换向率 | 结果 |
|---|---:|---:|---:|---:|---|
| 1 | `-2521.8 mrad` | `-6.4 mrad` | `0.86 mm` | `5.3 次/秒` | OK |
| 2 | `-559.4 mrad` | `-4.5 mrad` | `0.22 mm` | `7.2 次/秒` | OK |
| 3 | `-701.3 mrad` | `-6.4 mrad` | `0.81 mm` | `6.4 次/秒` | OK |

统计：

- 平均绝对航向误差：约 `5.7 mrad`（`0.33°`）
- 最大航向误差：`6.4 mrad`（`0.37°`）
- 误差反向穿越：三次均为 `0`
- 最大位置误差：`0.86 mm`
- 三次结果均为 `OK`

### K3 麦轮二维回位与大角度最终验证

最终运动学：

```text
vy 正方向 = 左
FL = vx - vy + spin
RL = vx + vy + spin
RR = vx - vy - spin
FR = vx + vy - spin
```

航向回正完成后，位置误差 `(-x, -y)` 先旋转到当前车体坐标，再同时输出
`vx/vy`。平移期间航向环继续工作；接近原点时用编码器测速项减速，停车后
再次验证航向和位置。

本轮额外修复：

1. **自动校准竞争**：K3 在开机后 10 s 内启动时，IMU 任务原先还会自动做
   第二次零偏校准。第二次校准发生在车辆已经开始转动之后，会冻结航向积分，
   表现正是“电机一直转、航向角不变”。现在手动、K3、STUNE 校准会抑制自动
   校准。
2. **无进展保护误判**：原实现每次把“最佳误差”更新到最新值，25 mrad 的
   进展阈值永远不能触发，正常下降的大角度回正也会被误判停滞。现在只在
   至少取得 25 mrad 新进展时重置保护计时。
3. **平移减速系数**：位置环误用了累计航向 `≈6280 mrad` 计算安全缩放，
   导致平移速度只剩 15%。现在改用 `wrap(-theta)` 后相对原航向的误差。

最终固件的大角度/回位样本：

| 次数 | 回正起始误差 | 回正后位置 | 最大平移命令 | 最终位置 | 最终航向误差 | 结果 |
|---|---:|---:|---:|---:|---:|---|
| 1 | `+2640.8 mrad`（`151.31°`） | `29.4 mm` | `vy≈-39.6 mm/s` | `6.0 mm` | `-1.7 mrad` | OK |
| 2 | `-2451.6 mrad`（`-140.47°`） | `13.9 mm` | `vx≈-18.7 mm/s` | `5.6 mm` | `-0.8 mrad` | OK |
| 3 | `+2555.7 mrad`（`146.43°`） | `29.9 mm` | `vy≈-40.4 mm/s` | `5.5 mm` | `+1.7 mrad` | OK |

三轮均未触发航向停滞保护，未出现 120°-180° 持续转圈。位置轨迹同时包含
`vx` 与 `vy` 分量，确认回位使用的是麦轮二维平移。

开机约 2 s 立即触发 K3 的专项复现也在修复后通过：
`pos_err=3.2 mm`、`hdg_err=7.3 mrad`，没有再发生第二次自动校准覆盖。

### 轮地滑移补偿与 4 mm 回位

最终候选 `k2-15s-k3-mecanum-return5` 针对实际位置误差继续调整：

- 自转目标从 `2200~2999 mrad/s` 降到 `900~1399 mrad/s`，避免轮速差饱和后
  主要靠辊子横向刮擦“完成”旋转；
- 自转增加 `350 ms` 速度斜坡；
- 5 s 结束后不再直接关 PWM 滑行，而是保持速度环零目标主动制动 `350 ms`；
- 麦轮横移加入默认 `0.75` 轮地增益，里程计与轮速命令双向补偿；
- 增加 `YG <0.30~1.19>` 串口命令，可按实际地面标定横移增益；
- 位置回位改为前后、左右单轴依次接近，减少斜向麦轮合力造成的滑移；
- 停车目标收紧到 `2 mm`，验收窗口收紧到 `4 mm`，最多允许 5 次微调。

内部里程计测试：

| 次数 | 自转目标 | 回正起始误差 | 回正后位置 | 最终位置 | 最终航向误差 |
|---|---:|---:|---:|---:|---:|
| 1 | `-952 mrad/s` | `122.15°` | `7.8 mm` | `3.9 mm` | `6.5 mrad` |
| 2 | `-1292 mrad/s` | `-142.40°` | `12.6 mm` | `1.9 mm` | `1.2 mrad` |
| 3 | `+1044 mrad/s` | `-133.01°` | `5.7 mm` | `1.9 mm` | `0.4 mrad` |

三轮均进入麦轮平移回位并通过 `OK`。这组数据证明轮速闭环已收敛，但仍是
**板载里程计位置**。麦轮侧向滑移时，编码器无法独立观测真实地面位移；
要确认绝对回位精度，必须用地面标记、俯视相机或卷尺记录车体实际偏差，
再据此调整 `YG`，不能继续只收紧 PID 或里程计阈值。

### 陀螺角速度闭环自转

自转不再直接把随机轮速当作目标，而是以 ICM-20602 的实测 `GZ` 作为内环反馈：

```text
target_rate = 随机 700~999 mrad/s
omega_wheel = 1.55*target_rate
            + 0.55*(target_rate - measured_gz)
            + 1.20*integral(target_rate - measured_gz)
```

最终落轮命令限制在 `±1800 mrad/s`。这样左右轮打滑时，控制器会继续增加轮速，
直到车体真实角速度达到目标；积分后的陀螺航向仍用于最终回正。

落地测试：

| 目标 GZ | 稳态实测 GZ 均值 | 跟踪比例 | 平均轮速命令 | 回正起始误差 | 最终位置 | 最终航向误差 |
|---:|---:|---:|---:|---:|---:|---:|
| `-870 mrad/s` | `-878 mrad/s` | `1.01` | `-1308 mrad/s` | `-117.27°` | `1.5 mm` | `5.3 mrad` |
| `-817 mrad/s` | `-816 mrad/s` | `1.00` | `-1295 mrad/s` | `-135.87°` | `2.1 mm` | `0.4 mrad` |

结论：陀螺角速度闭环可以把实际车体转速稳定在目标值，并自动补偿麦轮打滑。
但旋转过程中车体中心仍会发生真实位移，陀螺仪只能测转动、不能直接测平移；
最终位置仍必须由编码器/视觉等平动观测量闭环。

## 4. K2 四轮直行线性升速

最终行为：

- 四轮按 `A+ B+ C+ D+` 直行；
- 总时长 15000 ms；
- 前 5000 ms 线性升到 100%；
- `duty_permille = min(elapsed_ms * 1000 / 5000, 1000)`；
- 100% 满速保持 10000 ms，第 15 秒停车并拉低 `STBY`。

架空实测：

| 检查点 | 结果 |
|---|---|
| 2.0 s 时 PWM | `402‰`（线性目标约 400‰） |
| 6.0 s 时 PWM | `1000‰` |
| 15.0 s 后动作状态 | `active=0` |
| 最终记录 PWM | `1000‰` |
| `STBY` | `0` |
| TIM1 CCR1~4 | `0 / 0 / 0 / 0` |

结论：线性斜率与停车保护通过。100% 占空比仅允许车轮架空测试。
