sheepxray/1145141919810wulongjiadao/docs/20-竞赛校赛动员与官方节点_20261012.md

# 20 · 第十五届光电设计竞赛校赛动员纪要

> 材料接收日：2026-10-12
>
> 性质：校内宣讲录音与现场 PPT 摘要，不是组委会最终细则。
>
> 适用范围：本项目聚焦赛题 1，同时记录赛题 2 的通用要求、提交材料、扣分项和赛事节奏。
>
> 原始材料：`C:\Users\sheep\Desktop\乌龙驾到\_本地存档_不入库\2026-10-12_光电竞赛校赛动员\`

---

## 1. 最需要先改变的口径

### 1.1 11-22 不是校赛日期

[10 开发计划](10-开发计划与里程碑.md) 的 `2026-09-28 -> 2026-11-22` 是内部第一阶段和 MVP 周期，
不是校赛总周期。校赛动员给出的常规节奏是：

| 月份 | 阶段 | 主要内容 |
|---|---|---|
| 3 月 | 校赛 | 校内动员、组队、选拔，确定晋级项目 |
| 4 月 | 区赛 | 赛区复赛或决赛，选拔晋级国赛队伍 |
| 5 月 | 国赛 | 全国总决赛，现场竞技与答辩 |

> 幻灯片没有写出年份。按当前时间理解，应为 2027 年 3/4/5 月，但必须等待官方通知确认。
>
> 原话口径：这些月份是常规安排，具体日期以当年官方通知为准。

### 1.2 详细赛题细则尚未发布

宣讲中提到，本年度赛题细则预计在当月发布。细则发布前，小车尺寸、重量、发车方式、
得分方式和部分限制仍可能变化，不应把宣讲中的概述当作最终规则。

---

## 2. 赛事结构、组队与准备经验

### 2.1 两个赛题

| 赛题 | 概述 | 对本项目的影响 |
|---|---|---|
| 赛题 1：智能车光电象棋对抗 | 两辆小车在场地内争抢象棋棋子，并把棋子送入对应区域；比赛禁止遥控，细则待发布 | 本仓库当前主线 |
| 赛题 2：复杂目标体积测量 | 对杂乱堆放目标进行非接触测量与建模，需要相机、光源、算法和三维重建能力 | 本项目暂不切换赛题，但可作为技术储备 |

### 2.2 组队约束

- 每队 1 到 3 人。
- 队长必须是本科生；研究生可以加入，但每队最多 1 名。
- 指导老师不是必须条件。
- 推荐角色组合：1 人偏硬件、1 人偏软件、1 人负责答辩、PPT、报告和视频。

### 2.3 宣讲给出的四条准备经验

| 经验 | 内容 |
|---|---|
| 早启动 | 校赛在 3 月，建议至少提前 1 到 2 个月完成组队与选题 |
| 重打磨 | 方案、样机、报告要反复迭代，前期扎实程度决定后期上限 |
| 控风险 | 关键技术提前验证，预留备份方案与冗余时间 |
| 善借力 | 主动对接实验室、指导老师和往届队伍 |

### 2.4 其他现场信息

- 往年演示视频约 5 分钟，需要展示设计、功能和优势。
- 校赛通常在真实场地上进行，建议车能跑后在实场拍摄素材，视频更有说服力。
- 指导老师主要能提供方向和经费支持，但参赛队仍是研发主力。
- 进入复赛后，社团和有经验的学长学姐可以提供代码调试和培训支持。
- 组队、方案排版、字体一致性和答辩能力会影响前期筛选。

---

## 3. 提交材料与评分要求

### 3.1 赛题 1 与赛题 2 的评分口径

| 赛题 | 评分方式 |
|---|---|
| 赛题 1 | 以现场对抗得分判定胜负；材料与答辩协同评分 |
| 赛题 2 | 总分 100 分：现场测量 70 分，展示材料函评 30 分 |

赛题 2 的 70 分对应实物系统现场运行，包括测量精度、速度、鲁棒性、工程实现与成本控制；
提交内容是实物系统、测试数据或说明、成本清单。

赛题 2 的 30 分对应海报或展板、设计报告和演示视频，重点看创新性、技术方案和表达效果。

### 3.2 扣分或取消成绩情形

- 使用被禁止的商用成熟测量仪器或成套设备：取消现场测量成绩。
- 测量中接触、移动、夹持、称重、浸没或改造待测目标：该目标成绩无效。
- 人工描边、人工读取关键尺寸或人工修正结果：扣分，严重者取消成绩。
- 成本清单明显失实：取消成本相关得分；情节严重者取消评奖资格。

### 3.3 技术方案报告

官方模板要求封面表头加八节正文：

1. 研究目标
2. 研究方案
3. 技术路线及可行性分析
4. 拟解决的关键问题
5. 特色与创新点
6. 其他说明
7. 结论
8. 参赛队伍简介：队名、队员、导师、学校

格式与提交要求：

- 正文不超过 3000 字。
- 正文小四宋体；一级、二级标题黑体。
- 命名格式：`学校_赛题简称_队名_队长`。
- 决赛前提交电子版和纸质版 2 份。
- 封面要求填写编号、参赛题目、队名、学校和队员；学校字段有匿名要求。

---

## 4. 硬件、软件与成本准备清单

### 4.1 硬件

| 类别 | 可选用件 |
|---|---|
| 相机 | 普通相机模组、CMOS 或 CCD、镜头 |
| 光源 | LED、投影器、低功率线激光器 |
| 光学件 | 滤光片、偏振片 |
| 控制 | 单片机、开发板、电机、机械转台 |
| 工具与环境 | 万用表、稳压电源、示波器、焊接工具、标定板、测试台、3D 打印结构件 |

计算机、显示器和通用电源适配器不计入成本。

### 4.2 软件

| 方向 | 工具 |
|---|---|
| 视觉与算法 | Python、OpenCV、C++；相机标定、点云处理、三维重建、体积计算 |
| 控制与嵌入式 | STM32、Arduino、树莓派；PID、路径规划、目标识别与决策 |
| 仿真与设计 | MATLAB、Python；光学与结构仿真；SolidWorks、CAD |
| 文档与视频 | Word、PPT；剪映、Premiere、After Effects；Git |

### 4.3 安全与成本

- 激光器必须标明安全等级并做遮光防护。
- 赛题 1 的激光限制为不高于 1 mW、II 类；禁止有风险的高功率开放光路。
- 核心光电测量硬件必须纳入成本清单，采购票据要保留。
- 赛题 2 的系统整体尺寸不超过 `50 x 50 x 50 cm`，重量不超过 `10 kg`。

---

## 5. 对本项目的直接行动项

1. 保持赛题 1 主线不变，继续完成动力、视觉、控制、定位和推入链路。
2. 将 [10 开发计划](10-开发计划与里程碑.md) 明确定位为内部 MVP 计划，而不是校赛总排期。
3. 新建参赛材料工作区，至少按 `方案书 / 技术报告 / 海报 / 演示视频 / 成本清单 / 票据` 分类。
4. 从现在开始按官方八节结构积累技术报告素材，避免赛后集中补写。
5. 保留全部采购票据，并持续维护成本清单。
6. 车能稳定运行后，尽快在真实场地拍摄演示素材。
7. 等待细则发布后，重新核对小车尺寸、重量、发车方式、得分规则和禁限项。

---

## 6. 仍需确认的问题

- 校赛、区赛、国赛的准确年份和日期。
- 2026 年度详细赛题细则的发布时间。
- 赛题 1 的小车尺寸、重量、发车方式、单场时间和得分规则。
- 是否允许一次推入多枚棋子，以及帅将归属如何判定。
- 技术报告和海报的最终模板、匿名要求、提交入口与截止时间。
- 成本清单的计价边界、发票要求和汇率或二手件处理方式。
- 校赛真实场地是否开放测试，以及开放时间和预约方式。

已登记的规则风险继续以 [09 待确认事项与风险](09-待确认事项与风险.md) 为准，尤其是 Q1、Q2、Q3、Q7、Q8 和 Q9。

---

## 7. 一句话结论

**内部开发按 11 月完成 MVP 推进，但对外参赛按次年 3 月校赛倒排；从现在开始同时积累报告、成本、视频和答辩材料。**
