sheepxray/1145141919810wulongjiadao/docs/09-待确认事项与风险.md

# 09 · 待确认事项与风险登记

> **开工前必读。** 本文列出的前两条会改变硬件选型与整个策略，**必须在采购前书面闭环**。

---

# 第一部分：需向组委会确认的规则问题

建议整理成一封邮件/书面问询发组委会，逐条列出。**不要口头问** —— 需要书面答复作为依据。

## 🔴 Q1 · 球门区的归属规则（最高优先级）

**问题**：己方球门区是只收**己方颜色**的棋子，还是**任何颜色**的棋子都收？

**为什么关键**：这会导出**完全不同的目标函数**。

| 若"只收己方颜色" | 若"任何颜色都收" |
|---|---|
| 只推己方棋子（16 枚） | 所有 32 枚都是候选 |
| 把对方棋子推走是"拒止"（有价值） | 把对方棋子推进己方门也是**得分** |
| 颜色识别是**必需**的 | 颜色识别只是**优化**（优先级判断） |
| 目标函数需含"对方棋子处理"项 | 目标函数简化为"最近的棋子优先" |

**同时需确认**："帅/将归属"如何判定？是"**谁推入的**"还是"**帅/将在谁的门里**"？

**影响的文件**：[docs/07](07-软件架构与决策策略.md) §4 打分函数、[docs/04](04-视觉识别系统.md) 识别流程

---

## 🔴 Q2 · 棋子是否可能背面朝上

**问题**：32 枚棋子全场随机投放时，是否可能**背面（无字面）朝上**？

**为什么关键**：若可能，则——

| 失效的 | 后果 |
|---|---|
| 颜色 | 无字面无颜色 → 红/黑不可分 |
| 分值 | 不可读 |
| 帅/将 | 不可辨 |

**整套"按分值选目标 + 颜色预筛 + 帅/将支配"策略全部失效。**

而且这**不是调参能解决的**，是策略降级问题。必须走**降级策略 B**
（不读字，按距离抢进球总数，见 [docs/07](07-软件架构与决策策略.md) §5）。

**附加问题**：若允许背面朝上，是否允许**翻面机构**？
（本方案假设不现实：3D 打印 + 3 个月做不出可靠的翻面机构。）

---

## 🟡 Q3 · 比赛时长与赛制

**问题**：

1. 单场比赛时长是多少？（3 分钟？5 分钟？）
2. 是否分上下半场？中场是否交换场地？
3. 是否有暂停/重赛机制？

**为什么关键**：

- 决定电池容量（当前 1500mAh 在 3 分钟下余量极大，若是 10 分钟需复核）；
- 决定**时间管理策略**（[docs/07](07-软件架构与决策策略.md) §6 估算每场只能完成 6–8 个目标）；
- 若分上下半场且交换场地，**球门方向会互换** → 需要用拨码开关配置（已在 [docs/03](03-电控与驱动系统.md) 预留）。

---

## 🟡 Q4 · 球门位置

**问题**：球门区在 **2m 端**还是 **3m 长边**？

**赛题原文**："场地分为中央对抗区、**两侧球门区**、发车区与棋子堆放区"，以及平局判据提到"两侧"。

**倾向解读**：3m 轴的两端（即 2m 端墙）。

**为什么关键**：

| 若球门在 2m 端（长轴两端） | 若球门在 3m 长边 |
|---|---|
| 推进方向吸附到 3m 轴 | 推进方向吸附到 2m 轴 |
| 重定位基准墙 = 端墙 | 基准墙 = 长边墙 |
| 推程最长 3m | 推程最长 2m（更容易） |

**这直接决定 [docs/02](02-机械系统设计.md) 的推板朝向和 [docs/05](05-定位与导航.md) 的重定位基准。**

---

## 🟡 Q5 · 棋子的物理参数

**问题**：

1. 直径是多少？（本方案默认按 **φ45mm** 设计）
2. 厚度是多少？
3. 材质？（木质/亚克力/塑料）
4. 刻字方式？（阴刻填色 / 阳刻 / 印刷）
5. 字面颜色与底色？（本方案假设：红方字红、黑方字黑、底色相同）

**为什么关键**：

- 推板开口宽度、侧裙高度、贴地间隙**全部依赖直径与厚度**；
- 刻字方式和对比度决定视觉算法的阈值与数据集合成参数。

> **若直径不是 45mm**：用 `tools/geometry.py` 的 `wall_hug_window` 函数改参数重跑，
> 推板几何随之更新。

---

## 🟡 Q6 · 场地地面材质

**问题**：场地地面是**木质/合成材料/地毯/水泥**？

**为什么关键**：

- 摩擦系数决定里程计标定参数（[docs/05](05-定位与导航.md) §6 要求"在真实地面上标定"）；
- 决定万向球的选型；
- 决定推板贴地间隙（软地面需更大间隙防止刮擦）。

---

## 🟡 Q7 · "恶意冲撞"的判定尺度

**问题**：

1. 什么是"恶意冲撞"？如何判定？
2. **卡位**（用车身挡住对方前进路线）算不算冲撞？
3. 双方车辆**非故意接触**如何处理？

**为什么关键**：决定对抗策略的激进程度。本方案默认**完全不参与对抗性接触**（最保守），
但若规则明确允许卡位，可以更激进地抢位。

---

## 🔴 Q10 · 电机堵转参数不自洽：必须实测定论（2026-09-28 更新）

**问题**：MG513X 商品页参数**自身矛盾 2.2 倍** ——
标称堵转转矩 **4.5 kgf·cm** 与堵转电流 **3.2 A** 不能同时成立。

用直流电机线性模型核对（Kt = Ke）：

| 取信的一组 | 推算 | 与手册冲突 |
|---|---|---|
| 额定 300 rpm / 1 kgf·cm / 0.36 A（含 I₀=30 mA） | 绕组 **7.9 Ω**，堵转 ≈ **1.51 A** | 手册堵转写 **3.2 A**（差 **2.1×**） |
| 堵转转矩 4.5 kgf·cm + 堵转电流 3.2 A | 绕组 3.75 Ω，空载应为 **823 rpm** | 手册空载写 **370 rpm**（差 **2.2×**） |

**注意**：额定点三参数（300 rpm / 1 kgf·cm / 0.36 A → 3.1 W ↔ 标称 4 W）**是自洽的**，
所以矛盾**只集中在两个堵转参数之间**。

> 这与 docs/17 旧版记录的「0.5 A ↔ 4.0 kgf·cm 差 2.2 倍」**性质与比例都相同** ——
> 说明这是该系列商品页的通行口径问题，不是本次抄录错误。

**两种自洽读法**：

| 读法 | 绕组电阻 | 堵转电流 | 堵转转矩 | 对 TB6612 的影响 |
|---|---|---|---|---|
| A | **7.9 Ω** | **1.51 A** | ≈4.5 kgf·cm | ⚠️ 超持续 1.2 A（1.3×） |
| B | **3.75 Ω** | **3.2 A** | ≈2.1 kgf·cm | ❌ 超持续 2.7×，顶到峰值 |

**为什么关键**：

- **决定热分析结论**：读法 A 四路堵转 ≈**6.0 A/72 W**；读法 B ≈**12.8 A/154 W**
- **决定 TB6612 发热**：读法 A 两片合计 ≈**4.6 W**；读法 B ≈**20.5 W**（SOP24 封装不可能长期承受）
- **决定保险丝**：主保险丝是按 8 A 还是按 15 A 选
- **决定是否触发 TB6612 热保护 / 板级 65 °C 保护**，导致驱动输出关断

**30 秒可定论**：

1. **万用表量绕组电阻**（转子转多点取平均，避开换向器死区）
   - ≈ **7.9 Ω** → 读法 A
   - ≈ **3.75 Ω** → 读法 B
2. **堵转实测电流**：电源限流到 4 A，堵转读电流表，同时贴热电偶看温升。

> **注意：结论不依赖读数** —— 两个读法的堵转电流都 **> 1.2 A（TB6612 持续上限）**，
> 所以**堵转保护无论如何都必须做**，只是限流阈值取 1.2 A 还是 3 A。

**复现**：`python tools/motor_consistency.py`

**确认后需更新**：[docs/17](17-实际电机参数核对.md)、[docs/06](06-电源系统.md) 电流预算、
[docs/08](08-BOM物料清单.md) 保险丝与线径、[接口定义](../../hardware/electrical/接口定义.md)。

---
## 🟡 Q8 · 是否允许一次推多枚

**问题**：一次推进动作把**多枚**棋子同时推入球门区，如何计分？
是否有"一次只能推一枚"的限制？

**为什么关键**：本方案的宽口盒式推板（开口 165mm）**天然具备一次带多枚的能力**。
若允许，效率可显著提升（[docs/07](07-软件架构与决策策略.md) §6 提到时间很紧，每场只能完成 6–8 个目标）。

---

## 🔴 Q9 · 7 兵种到 1–10 分的映射规则（第 4 轮新增）

**问题**：赛题写"按棋子等级设置 **1-10 分**差异化分值"，
但中国象棋只有 **7 种兵种**（兵/炮/马/车/相/仕/帅）。

**7 种兵种如何映射到 1–10 分？**

**三种合理解读，导出完全不同的策略**：

| 方案 | 分值序列（兵/炮/马/车/相/仕/帅） | 最优策略 |
|---|---|---|
| 默认（象棋惯例） | 1 / 5 / 4 / 9 / 2 / 2 / 10 | 优先抢车（9分）与帅；兵不值得专门跑 |
| 等差（1-10 线性） | 1 / 2 / 4 / 6 / 7 / 9 / 10 | 所有棋子价值接近，**效率（距离）比分值更重要** |
| 按枚数反比 | 1 / 5 / 5 / 5 / 5 / 5 / 10 | 除帅外**只看枚数**，变成扫场 |

**为什么这是 🔴 高优先级**：

> **这三种方案下"该先推哪个"的答案完全不同。**
> 目标函数（[docs/15](15-字符识别与优先级算法.md) §7）的排序结果会变。

**当前处理**：分值表已设计为**可配置**（`tools/piece_value.py` 的 `VALUE_SCHEMES`），
确认后改一行即可切换。

**需要组委会明确**：

1. 7 兵种各自的分值是多少？
2. 红黑双方分值是否相同？
3. 是否还有其他计分规则（如特定棋子组合加分）？

---

# 第二部分：技术风险登记

## R1 · nncase 工具链风险 🔴

| 项 | 内容 |
|---|---|
| **风险** | K230 的模型转换/量化/部署踩坑，导致 CNN 无法按时上线 |
| **概率** | 中高（3 个月时间紧） |
| **影响** | 无法识别分值 → 只能走策略 B |
| **缓解** | ① 视觉主线用经典 CV，把 nncase 调试面压到最小；② 只把"汉字分类"交给 CNN；③ **保留降级策略 B**；④ 尽早（M1 就）打通端到端的模型部署链路，不要留到最后 |
| **触发信号** | M3 阶段过半仍无法在 K230 上跑通推理 |

---

## R2 · 3D 打印件结构强度 🔴

| 项 | 内容 |
|---|---|
| **风险** | 推板悬臂在冲击下断裂；螺纹孔滑丝；长期蠕变 |
| **概率** | 中（只有 3D 打印，无钣金） |
| **影响** | 比赛中结构失效 |
| **缓解** | ① **不用 PLA**，用 PETG/PA-CF/ASA；② 壁数 ≥3，承力件填充 40%；③ **全部用热熔铜螺母**；④ 受载方向决定打印朝向（层间结合面垂直于主受力方向）；⑤ 推板做箱型截面或加三角筋；⑥ **打印 2 套推板备用** |
| **验证** | [docs/02](02-机械系统设计.md) §3.6 的三个推板测试 |

---

## R3 · K230 电源 brownout 🟡

| 项 | 内容 |
|---|---|
| **风险** | 电机堵转时电池被拉低 1–2V，K230 重启 |
| **概率** | 中（取决于电源设计质量） |
| **影响** | 视觉全丢 + 定位跳变 |
| **缓解** | 见 [docs/06](06-电源系统.md) §4 的完整清单（独立 buck、大电容、LC 隔离）+ 软件侧心跳与降级 |
| **验证** | **台架测试**：故意让电机堵转，示波器观察 5V 轨跌落 |

---

## R4 · 场地光照与视觉标定 🟡

| 项 | 内容 |
|---|---|
| **风险** | 实验室调好的 HSV 阈值在比赛场馆失效（色温/亮度差异大） |
| **概率** | **高**（几乎必然） |
| **影响** | 棋子检测率下降 |
| **缓解** | ① 用 HSV 而非 RGB；② **必须在真实场馆现场标定阈值**；③ 准备多套阈值预案（可拨码切换）；④ 加自适应白平衡；⑤ 比赛前预留现场调试时间 |

---

## R5 · 时间不足 🟡

| 项 | 内容 |
|---|---|
| **风险** | 3 个月内无法完成全部功能 |
| **概率** | 中高 |
| **影响** | 带不完整方案参赛 |
| **缓解** | **MVP 优先**：M2 结束时必须有一套完整可用的兜底方案（见 [docs/10](10-开发计划与里程碑.md)）。字符识别是**优化项，不是前提** |

---

## R6 · 棋子背面朝上（依赖 Q2） 🔴

| 项 | 内容 |
|---|---|
| **风险** | Q2 答案为"可能" → 整套识别策略失效 |
| **概率** | 未知（**取决于组委会答复**） |
| **影响** | 策略整体降级 |
| **缓解** | ① **赛前书面确认**；② 准备降级策略 B 并**在 M4 阶段实测**；③ 不做翻面机构（不现实） |

---

## R7 · 对方车堵门 🟡

| 项 | 内容 |
|---|---|
| **风险** | 对方车停在你的球门区做防守，无法得分 |
| **概率** | 中 |
| **影响** | 得分效率骤降 |
| **缓解** | ① 状态机加"拥堵检测 → 换目标 → 稍后再来"；② 不尝试冲撞（C15）；③ 准备"多入口推入"策略（从不同角度接近球门） |

---

## R8 · 激光合规 🟢

| 项 | 内容 |
|---|---|
| **风险** | 激光功率实测超标 → 直接判负 |
| **概率** | 低（可控） |
| **影响** | 严重（直接判负） |
| **缓解** | ① 实测功率，目标 **≤0.7mW**；② 串限流电阻；③ 低位向前安装，不指向对方车/人；④ 清晰标识；⑤ **不接入定位链路** |

---

## R9 · 里程计漂移 🟢

| 项 | 内容 |
|---|---|
| **风险** | 航迹推算漂移超出预期 |
| **概率** | 低（有撞墙重定位兜底） |
| **影响** | 走位偏差 |
| **缓解** | ① 陀螺静止标定；② **撞墙重定位周期性清零**；③ 速度环闭环（不能开环 PWM）；④ 按 [docs/05](05-定位与导航.md) §6 流程标定 |

---

## 风险矩阵总览

| 风险 | 概率 | 影响 | 优先级 |
|---|---|---|---|
| Q1 归属规则未确认 | — | 极高 | **立即闭环** |
| Q2 背面朝上未确认 | — | 极高 | **立即闭环** |
| R1 nncase 工具链 | 中高 | 高 | **M1 就开始验证** |
| R2 打印件强度 | 中 | 高 | M1 打样验证 |
| R4 光照标定 | 高 | 中 | 现场调试 |
| R3 brownout | 中 | 中 | 台架测试 |
| R5 时间不足 | 中高 | 中 | MVP 优先 |
| R7 对方堵门 | 中 | 中 | M4 应对 |
| R6 背面朝上 | 未知 | 极高 | 依赖 Q2 |
| R8 激光合规 | 低 | 高 | 采购时控制 |
| R9 里程计漂移 | 低 | 低 | 已有多层兜底 |

---

# 第三部分：行动项

| # | 行动 | 负责 | 截止 |
|---|---|---|---|
| 1 | **整理 Q1–Q8 发组委会书面问询** | 队长 | **本周** |
| 2 | 确认 Q1、Q2 答复后**修正 [docs/07](07-软件架构与决策策略.md) 打分函数** | 算法 | 答复后 3 天内 |
| 3 | 确认 Q5 棋子尺寸后**重跑 `tools/geometry.py` 更新推板几何** | 机械 | 答复后 3 天内 |
| 4 | 打通 K230 上"采集→训练→nncase→推理"的端到端链路 | 视觉 | M1 结束 |
| 5 | 打印推板样件，做三个验证测试 | 机械 | M1 结束 |
| 6 | 台架测试 **TB6612 四路（D24A）** 堵转电流与温升 | 电控 | M1 结束 |
| 7 | 示波器验证 5V 轨在堵转时的跌落 | 电控 | M1 结束 |
