sheepxray/1145141919810wulongjiadao/docs/15-字符识别与优先级算法.md

# 15 · 字符识别与优先级算法

> 🗄️ **历史五轮档案（旧平台）**：本文是五轮迭代「第 4 轮」的产物，基于旧平台（差速 + RK3588 / H723 / 双 IMX219 / BTS7960）。结论已被实际采购方案部分或全部取代，仅作方法与数据档案保留；当前方案见 [16 商品清单](16-最终商品清单.md)，新判断见 [17 电机参数](17-实际电机参数核对.md) / [10 计划](10-开发计划与里程碑.md)。

> ### ✅ **例外：本文的算法部分仍然完全适用**
>
> 与 13/14 不同，**本文没有平台相关性**——它解决的是
> 「识别输出概率分布时如何排序目标」，与用什么主控/底盘/相机无关。
>
> | 结论 | 状态 |
> |---|---|
> | ★ 用**期望值**而非 argmax | ✅ **仍然适用** |
> | ★ **不确定性惩罚**（方差降权） | ✅ **仍然适用** |
> | ★ 低置信度**多帧投票** | ✅ **仍然适用** |
> | 分值表（7 兵种 → 1-10 分） | ⚠️ 依赖规则解读，见 [docs/09](09-待确认事项与风险.md) Q9 |
> | 参考实现 `scoring.py` | ✅ 可运行，可直接用于新方案 |
>
> **唯一变化**：读字相机从「下视专用」变成「单相机兼用」，
> 多帧投票的耗时预算需重估（见 [docs/12](12-帧率与实时性.md) 单相机说明）。

> **第 4 轮迭代的产物。** 所有数值可用 `python tools/piece_value.py` 复现。
>
> **本文解决：把"看到的字"变成"该先推哪个"。**

---

## 1. 结论先行

**识别输出的是概率分布，不是确定的分值 —— 优先级必须基于期望值而非 argmax。**

| 设计决策 | 理由 | 效果 |
|---|---|---|
| **★ 用期望值不用 argmax** | argmax 丢掉置信度信息 | 55% 确定是车时，期望值 6.72 分比 argmax 的 9 分更诚实 |
| **★ 加不确定性惩罚** | 方差大 = 可能高也可能低 | 让"确定的目标"优先于"可能更高但犹豫的目标" |
| **★ 低置信度多帧投票** | 读字时车静止，时间充裕 | 3 帧把 0.70 提到 0.78，代价仅 106ms |

**完整优先级公式**：

```
priority = 期望分值 + 枚数 + 帅/将概率 × 50
           − 距离惩罚 − 不确定性惩罚 − 送分风险
```

---

## 2. ★ 新增待确认项：Q9 分值映射规则

**赛题只写"按棋子等级设置 1-10 分"，但中国象棋只有 7 种兵种。**

7 → 10 的映射有多种合理解读，**导出完全不同的策略**。

### 三种候选方案

| 方案 | 分值序列（兵/炮/马/车/相/仕/帅） | 特点 |
|---|---|---|
| **默认（象棋惯例）** | 1 / 5 / 4 / 9 / 2 / 2 / 10 | 分化明显，车远高于其他 |
| 等差（1-10 线性） | 1 / 2 / 4 / 6 / 7 / 9 / 10 | 每枚棋子都值得抢 |
| 按枚数反比 | 1 / 5 / 5 / 5 / 5 / 5 / 10 | 除帅外都一样，变成抢枚数游戏 |

**策略差异**：

| 方案 | 最优策略 |
|---|---|
| 默认 | 优先抢车（9分）和帅；兵不值得专门跑 |
| 等差 | 所有棋子价值接近，**效率（距离）比分值更重要** |
| 反比 | 除帅外**只看枚数**，变成扫场 |

> ⚠️ **这三种方案下"该先推哪个"的答案完全不同。**
> 分值表已设计为**可配置**（`VALUE_SCHEMES`），确认后改一行即可。
> 见 [docs/09](09-待确认事项与风险.md) 的 Q9。

### 全场总分校验（默认方案）

| 兵种 | 分值 | 每方枚数 | 每方总分 |
|---|---|---|---|
| 兵/卒 | 1 | 5 | 5 |
| 相/象 | 2 | 2 | 4 |
| 仕/士 | 2 | 2 | 4 |
| 炮 | 5 | 2 | 10 |
| 马 | 4 | 2 | 8 |
| 车 | 9 | 2 | 18 |
| 帅/将 | 10 | 1 | 10 |
| **合计** | | **16** | **59** |

全场 32 枚，总分 118 ✓（符合"红黑各 16 枚"）

---

## 3. ★ 核心：用期望值而不是 argmax

### 问题

现有打分函数（[docs/07](07-软件架构与决策策略.md)）假设分值已知。
但识别实际输出的是**概率分布**：

```
{车: 0.55, 炮: 0.44, 马: 0.01}
```

**argmax 会说"这是车，9 分"—— 但只有 55% 把握。**

### 对比

| 场景 | 期望值 | argmax | 方差 | 误判代价 | 置信度 |
|---|---|---|---|---|---|
| 确定是车 | 8.87 | 9 | 0.55 | 0.13 | 高 |
| **犹豫：车 or 炮** | **7.19** | **9** | **4.01** | **1.81** | **低** |
| 犹豫：马 or 炮 | 4.44 | 4 | 0.37 | 0.50 | 低 |
| 三个都像 | 3.31 | 1 | 2.91 | 2.31 | 极低 |

### 关键差别

看"犹豫：车 or 炮"这一行：

- **argmax** 输出 9 → 高估了 4 分（若实际是炮）
- **期望值** 输出 7.19 → 诚实地反映了风险

**期望值把不确定性量化进了分值。**

### 实现

```python
def expected_value(probs):
    """期望分值 = Σ p(class) × value(class)"""
    return sum(probs.get(cid, 0.0) * VALUE_TABLE.get(cid, 0.0)
               for cid in VALUE_TABLE)

def value_variance(probs):
    """分值的方差 —— 衡量判断有多不确定"""
    mean = expected_value(probs)
    return sum(probs.get(cid, 0.0) * (VALUE_TABLE.get(cid, 0.0) - mean) ** 2
               for cid in VALUE_TABLE)
```

---

## 4. 不确定性惩罚

**期望值相同但置信度不同的两个目标，应该被区别对待。**

| 目标 | 期望值 | 方差 | 置信度 | 不确定性惩罚 | 总分 |
|---|---|---|---|---|---|
| 确定是车 | 8.74 | 0.55 | 高 | −1.3 | −1.7 |
| 无法确定 | 6.09 | 8.30 | 极低 | −2.3 | −244.6 |

**方差大 = 可能 9 分也可能 4 分 = 决策风险高 → 降权。**

> 这在比赛里很有用：**与其赌一个可能是车也可能是炮的目标，
> 不如先稳稳地推一个确认的棋子。**

---

## 5. 置信度驱动的行为策略

| 置信度 | 分值取法 | 惩罚 | 行为 |
|---|---|---|---|
| 高（≥0.85） | 直接采用 | 不惩罚 | 立刻推 |
| 中（0.60–0.85） | 用期望值 | 小惩罚 | 推，优先级略降 |
| 低（0.40–0.60） | 用期望值 | 中等惩罚 | 可推，但优先找别的 |
| **极低（<0.40）** | 用期望值 | 大惩罚 | **★ 重新识别或跳过** |

### "极低"档的处理是关键

不要硬猜，而是：

1. **换个角度重拍**（车微调位置后再读一次）
2. **多帧投票**（车已静止，时间充裕）
3. 仍失败则**跳过**

32 枚里放弃 2–3 枚不确定的，不影响胜负。

### 多帧投票的效果

| 帧数 | 单帧正确率 | 投票后正确率 | 耗时 |
|---|---|---|---|
| 1 | 0.70 | 0.700 | 39 ms |
| 2 | 0.70 | 0.700 | 73 ms |
| **3** | **0.70** | **0.784** | **106 ms** |
| 5 | 0.70 | 0.837 | 173 ms |

> **读字时车是静止的，106ms 完全可以接受。**
> 建议：对"低/极低"置信度的目标做 3 帧投票。

---

## 6. 完整识别链路

```
┌──────────────────────────────────────────────────┐
│ 1. 前视颜色阈值 → 候选 + 红/黑（32 → 16）         │
│ 2. 停车读字 → 7 类概率分布                        │
│ 3. 期望分值 = Σ p(c) × value(c)                   │
│ 4. 优先级打分（含不确定性惩罚）                    │
│ 5. 排序 → 选最高 → 推入                           │
└──────────────────────────────────────────────────┘
```

### 第一级为什么用颜色先筛

中国象棋**红方字红、黑方字黑、底色相同** → "红/黑"是**颜色阈值**，
不需要 CNN、不需要停车。

**只需推己方颜色 → 需要读字的候选立刻减半（32 → 16）。**

---

## 7. 完整排序实例

**场地**：3m × 2m，己方球门在 x=0 端，半场分界 x=1500mm

| 排名 | 目标 | 期望值 | 置信度 | 总分 | 分项 |
|---|---|---|---|---|---|
| **1** | **帅（清晰）** | 9.80 | 高 | **42.1** | 期望10 + 枚数3 + **帅将46** − 距离16 |
| 2 | 车（清晰） | 8.74 | 高 | −1.7 | 期望9 + 枚数3 − 距离13 |
| 3 | 炮（犹豫） | 6.72 | 低 | −6.0 | 期望7 + 枚数3 − 距离14 − 不确定2 |
| 4 | 兵（清晰） | 1.09 | 高 | −7.5 | 期望1 + 枚数3 − 距离11 |
| 5 | 未知（对方半场） | 6.09 | 极低 | **−244.6** | ... − **送分风险200** |

### 判读

- **帅排第一**（期望值 9.8 + 支配项 46）—— 符合策略
- **车第二** —— 高分且确定
- **炮（犹豫）第三** —— 被不确定性惩罚压低
  - 注意：它的 argmax 也是车（9 分），但 55% 的把握让它降级
- **兵第四** —— 分值低，但确定、近、安全
- **对方半场最后** —— 送分风险 −200 主导

> **核心价值**：不按"看起来像几分"排序，
> 而按"**期望能得几分、且有多确定**"排序。

---

## 8. 与 docs/07 打分函数的关系

| | docs/07（旧） | 本文（新） |
|---|---|---|
| 分值来源 | 假设已知 | **概率分布 → 期望值** |
| 帅/将 | 硬判（是/否） | **概率加权**（`w_king × p(帅)`） |
| 不确定性 | 未考虑 | **方差惩罚** |
| 低置信度 | 未处理 | **多帧投票 + 降级** |

**本文的打分函数是 [docs/07](07-软件架构与决策策略.md) §4 的超集** ——
当识别置信度很高时，两者结果一致；置信度低时，本文更稳健。

---

## 9. 数据集与训练要求

| 项目 | 要求 |
|---|---|
| 类别 | **7 类兵种**（不分红黑，颜色由第一级给出） |
| 输入 | 64×64 灰度 |
| 每类样本 | ≥ 500 张（合成可放大到 2000） |
| 验证集准确率 | > 95% |
| **量化后准确率** | **> 93%**（量化掉点必须复测） |
| 输出 | **7 维概率分布**（不是 argmax） |

> ⚠️ **模型必须输出概率分布，不能只输出类别。**
> 期望值算法依赖完整的概率向量。

### 数据集合成（解决样本不足）

1. 拍几张高清棋子照片 → 抠出字形
2. 代码随机合成：随机底色、光照梯度、旋转/缩放/模糊/噪声、
   **随机透视变换**（模拟俯角压缩）
3. 每类生成 2000+

**这是 3 个月时间内最划算的做法。**

---

## 10. 结论

> **识别的输出是概率分布，优先级必须建立在期望值之上。**
>
> 三条设计决策：
> 1. **期望值代替 argmax** —— 诚实反映识别不确定性
> 2. **不确定性惩罚** —— 让确定的目标优先
> 3. **多帧投票** —— 用静止读字的时间换准确率
>
> **新增待确认项 Q9**：7 兵种到 1–10 分的映射规则。
> 三种解读导出完全不同的策略，分值表已做成可配置。
