sheepxray/1145141919810wulongjiadao/hardware/electrical/D24A_STM32G474_完整接线图.png

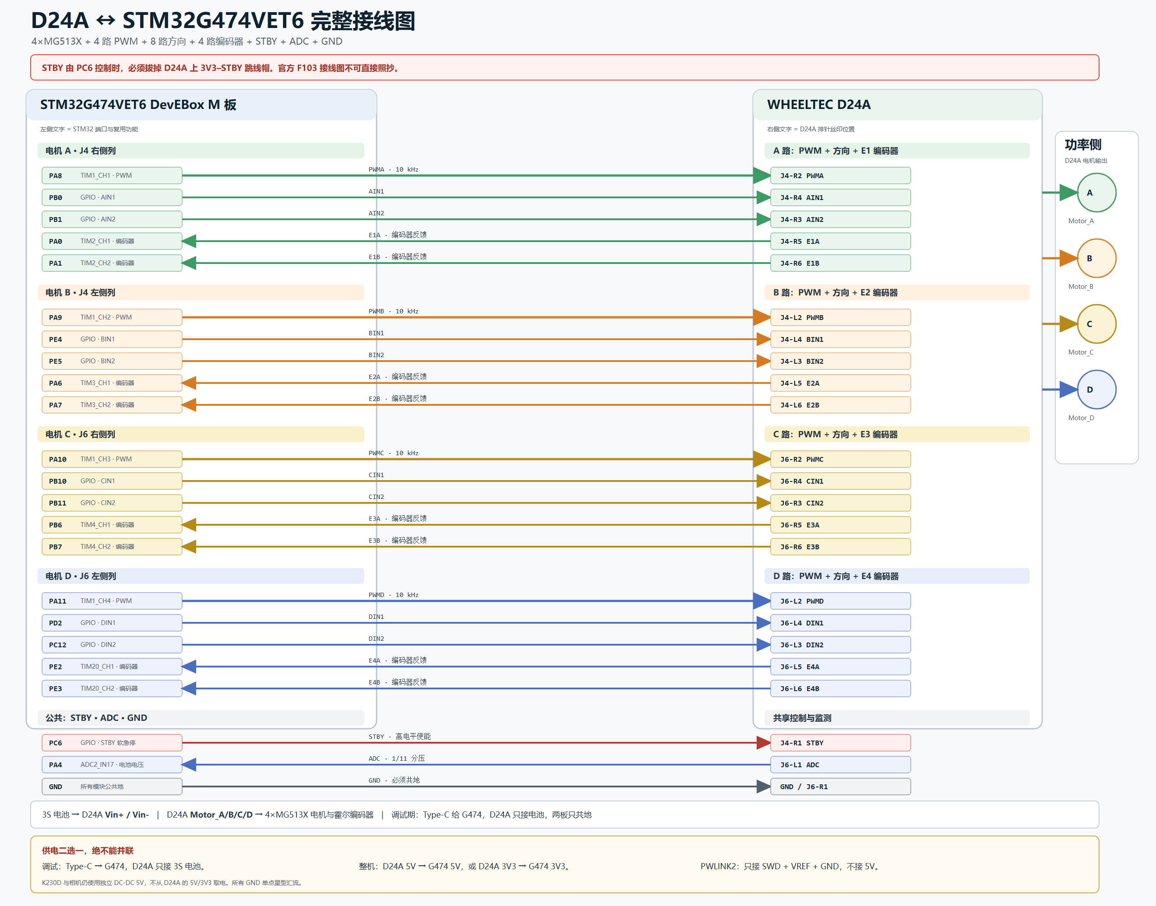
hardware/electrical/D24A_STM32G474_完整接线图.png
