sheepxray/1145141919810wulongjiadao/hardware/electrical/D24A_STM32G474_接线标注.png

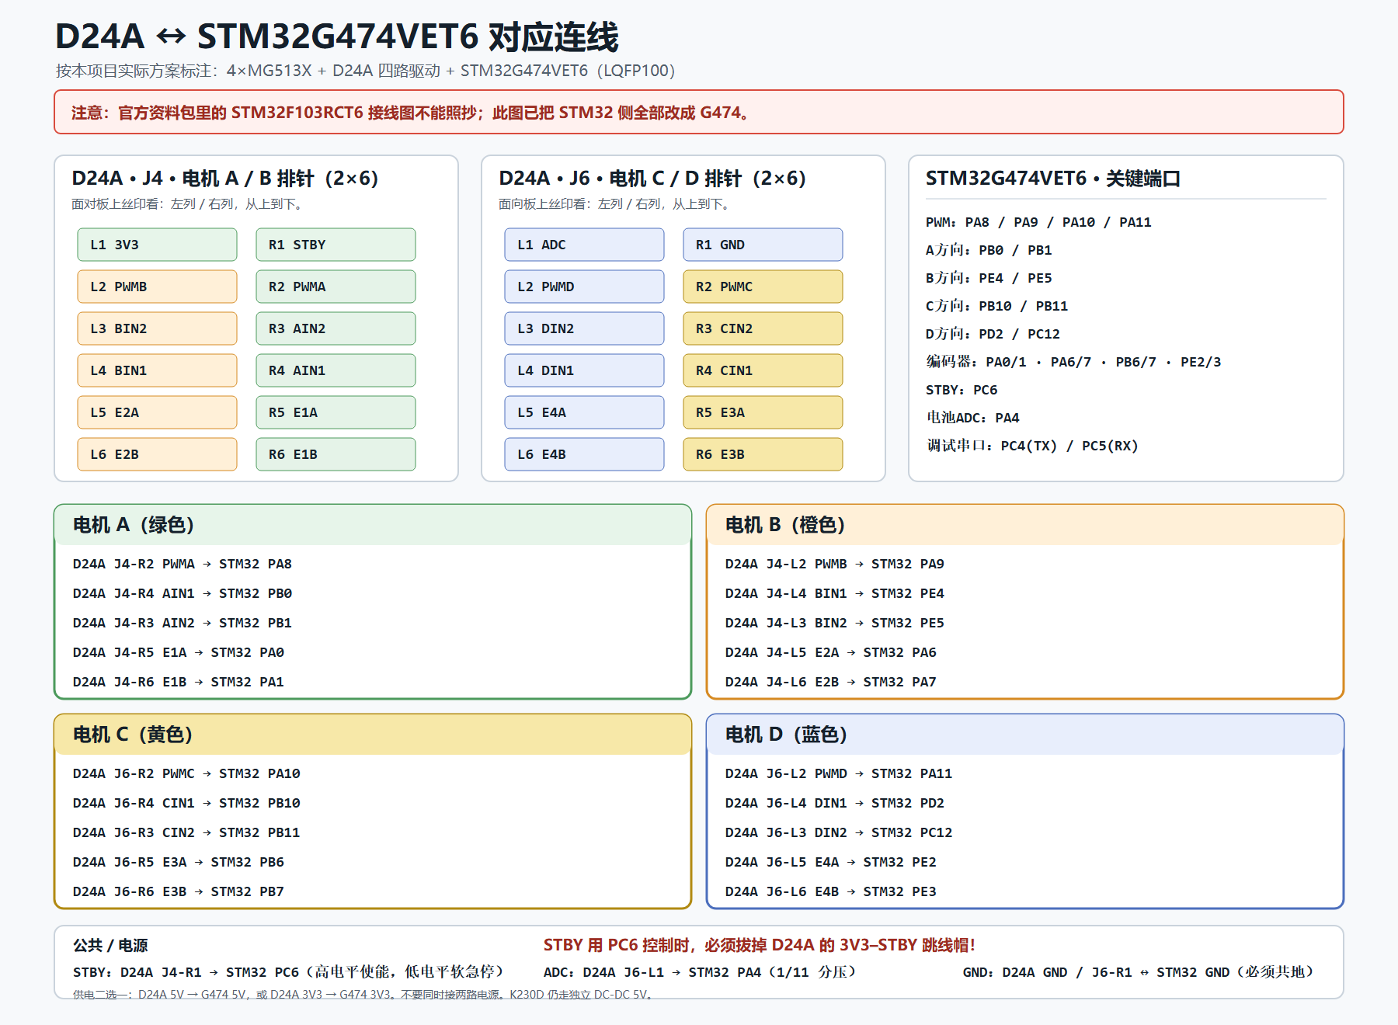
hardware/electrical/D24A_STM32G474_接线标注.png
