sheepxray/1145141919810wulongjiadao/docs/08-BOM物料清单.md

# 08 · BOM 物料清单（2026-09-28 采购修订版）

> ⚠️ 本表已按 **2026-09-27 淘宝实际下单** 修订，数据来自 `订单数据.xlsx`，与
> [18 采购记录](18-采购记录_20260928.md) 完全对齐。
>
> 原估算版（差速底盘 + RK3588 + 双 IMX219 + STM32H723 + BTS7960）**没有删除**，
> 保留在文末 §7 备查。实际采购与它存在**平台级冲突**，处置见 [10 开发计划](10-开发计划与里程碑.md) W1。

---

## 1. 汇总（实际实付）

| 项目 | 数值 |
|---|---:|
| 实付总价 | **¥751.01** |
| 商品合计 | ¥739.71 |
| 运费合计 | ¥11.30 |
| 订单数 | 13 单（12 已发货 / 1 待发货） |
| 预算 | ¥2000 |
| 余量 | **¥1248.99** |
| 质量 | ⚠️ 待实测称重（4 电机 + 4 麦轮，预计逼近 1.5kg 上限） |

---

## 2. 已购清单（按类别）

### 2.1 动力与驱动

| 物料 | 规格 | 数量 | 单价 | 小计 |
|---|---|---:|---:|---:|
| MG513X 直流减速电机 | 13 线霍尔编码器 + 加厚支架（**0.17 kg/台**，1:28，370 rpm 空载，0.36 A 额定） | 4 | ¥42.00 | **¥168.00**（680 g） |
| TB6612 四路驱动模块 | **D24A** 带稳压版（1.2 A 持续 / 3.2 A 峰值，板载 5V+3.3V，65 °C 保护） | 1 | ¥60.70 | **¥60.70**（19 g） |
| 麦克纳姆轮 | 60mm ×4 + 6mm 金属联轴器 | 1 套 | ¥40.00 | **¥40.00** ⚠️ |

> ⚠️ **TB6612**：⚠️ **该判断已作废（2026-09-28）**。
> 旧 BOM 写「不要买 TB6612FNG」是针对 **JGB37-520（堵转 2–5 A）**；
> 实际电机 **MG513X 额定仅 0.36 A**，TB6612 的 1.2 A 持续**在额定工况有余量**。
> 真正的风险变为**堵转发热把 TB6612 推到热保护** ——
> 见 [docs/17 §4](17-实际电机参数核对.md)、[TB6612_MG513X_规格.md](../../hardware/electrical/TB6612_MG513X_规格.md)。
>
> ⚠️ **旧记录（已废止）**：两版旧 BOM 均写明「不要买 TB6612FNG」（1.2A 连续，带不动 520 级堵转）。
> ⚠️ **麦轮**：[00 判断二](00-赛题解读与关键结论.md) 明确否决麦轮、选差速+盒式推板。
> 本次实际购入二者，意味着**底盘方案需要重新裁决**（若改全向方案，需回写 00/02）。

### 2.2 控制与主控

| 物料 | 规格 | 数量 | 单价 | 小计 |
|---|---|---:|---:|---:|
| STM32G474VET6 核心板 | 170MHz | 1 | ¥60.00 | **¥60.00** ⚠️ |
| ~~IMU~~ | — | — | — | **未购** ⚠️ |

> ⚠️ 主控是 G474（G4 高端，高分辨率定时器），非 16 章的 STM32H723。
> ⚠️ **IMU 选型已定：ICM-20602（SPI）**，尚未下单；航向目前只能靠轮速推算，按 10 §0 触发判据补购。

### 2.3 视觉

| 物料 | 规格 | 数量 | 单价 | 小计 |
|---|---|---:|---:|---:|
| 庐山派 Lite-K230D-CanMV 开发板 | 128M K230D | 1 | ¥233.68 | **¥233.68** ⚠️ |
| OV5640 摄像头模块 | 500 万，自动对焦 | 1 | ¥45.80 | **¥45.80** ⚠️ |

> ⚠️ 视觉平台是 K230D 128M（低配），非 16 章的 RK3588。
> ⚠️ **只购了 1 支相机**，无法实现「前视找棋 + 下视伺服」双相机方案，下视视觉伺服需改为
> 开环直推或补购下视相机。

### 2.4 电源

| 物料 | 规格 | 数量 | 单价 | 小计 |
|---|---|---:|---:|---:|
| 12V 锂电池组（3S） | 2600mAh + 1.5A 充电器 | 1 | ¥58.00 | ¥58.00 🟡 待发货 |
| DC-DC 多路电源模块 | 3.3V / 5V 多路 | 1 | ¥14.50（+¥2.50 运费） | ¥17.00 |

### 2.5 工具与线材（已购，不计入质量预算）

| 物料 | 规格 | 数量 | 小计 |
|---|---|---:|---:|
| 烧录器 PowerWriter LINK2 | PWLINK2 Lite | 1 | ¥18.90 |
| 洞洞板 | 双面喷锡 6×8cm | 2 | ¥6.10 |
| 杜邦线 | 15cm 三款 120 根 | 1 | ¥8.12 |
| RV 电线 | RV1 黑 5 米 | 1 | ¥6.80 |
| SM-2P 端子线 | 2.54mm 公母各 5 条 | 1 | ¥5.60 |
| 接线端子 | 二进六出 2 只装 | 1 | ¥4.80 |
| 面包板 + 跳线 | 400 孔 + 65 根 | 1 | ¥8.71 |

---

## 3. 缺料清单（原 BOM 有、本次未购）

| 物料 | 影响 | 建议 |
|---|---|---|
| **电机端 104 电容 ×4** | D24A 板上没有电机端 RC，有刷噪声无抑制 | 建议补购 |
| **IMU（ICM20602）** | 无航向基准，航迹推算漂移 | 补购或板载替代 |
| **下视相机** | 下视视觉伺服无法实现 | 补购或改开环直推 |
| BTS7960 驱动 | 现用 TB6612，堵转能力弱 | 视电机实测堵转决定 |
| ST-Link V2 | 已用 PWLINK2 替代 | 无需 |
| 万向球 | 原设计从动支撑 | 麦轮方案不需要 |
| 推板柔性件 / 五金热熔铜螺母 | 结构件 | 待机械重构后补 |
| **激光模组（650nm 1mW）** | C9 强制必须搭载 | 验证后再购（赛题强制） |
| 限流电阻 + 安装座 | 配套激光 | 验证后再购 |
| 低压报警器 / XT60 / 保险丝 | 电源保护 | 建议补购 |

> ⚠️ 激光模组是赛题硬性要求（C9/C16），但按计划**动力系统验证 + 视觉识别验证完成后**再购（触发条件见 [10](10-开发计划与里程碑.md) §0）。

---

## 4. 采购检查清单

- [x] 电机 12V、带编码器（MG513X 13 线霍尔）
- [ ] 驱动是否可接受（TB6612 **额定工况有余量** ✅；堵转需保护 ⚠️，见 docs/17 §3）
- [ ] 主控是否可接受（G474 ⚠️ vs 原 H723）
- [ ] 视觉是否可接受（K230D 128M ⚠️ vs 原 RK3588）
- [ ] 相机数量（仅 1 支，原需 2+备用 ⚠️）
- [ ] 电池 3S 12V ✓（2600mAh，已付款待发货）
- [ ] 视觉独立 DC-DC 5V ≥3A（原设计已满足，复核接线）
- [ ] 电机端 104 电容 ×4
- [ ] 激光模组 ≤1mW（动力/视觉验证后再购，赛题强制）
- [x] IMU 选型（ICM-20602，SPI2）
- [ ] IMU 补购（按触发判据）
- [ ] 无任何无线模块 ✓（已购件均为有线）

---

## 5. 明确不要买（维持原判断）

| 物品 | 原因 |
|---|---|
| PLA 耗材 | 脆，承力件会断 |
| MP1584 / LM2596 | RK 级 5V 瞬态差（即便换 K230D 也建议保守） |
| MPU6050 | 廉价模块多为贴牌，零偏差 |
| 任何蓝牙 / WiFi 模块 | C11 禁遥控 |
| 电磁铁 / 磁吸 | C11 禁止 |

---

## 6. 一句话总结

> 实际购入是一套 **「麦轮全向底盘 + K230D + 单 OV5640 + G474 + TB6612」的通用智能小车 kit**
> （实付 ¥751.01），与仓库原「差速底盘 + RK3588 + 双 IMX219 + H723 + BTS7960」方案（¥1486）
> 差异是**平台级**的。**激光模组与 IMU 属必补项。** 平台取舍由
> [10 开发计划](10-开发计划与里程碑.md) W1 裁决。

---

## 7. 原方案对照（历史备份，仅备查）

原五轮迭代方案关键点（详见 16 章历史与其余 docs）：

- 底盘：**差速** + φ65 橡胶轮 + 万向球，带盒式推板（00 判断二否决麦轮）
- 主控：STM32H723（RAM 564KB）
- 视觉：RK3588 + 双 IMX219（1080p@60）
- 驱动：BTS7960/IBT-2（43A）
- 相机：前视 + 下视 + 备用共 3 支

以上若最终裁决「维持原方案」，则本次采购需按清单调整或另购关键件；
若「采纳实际采购方案」，则 00/02/03/04/06/12/13/16 需同步回写。
