sheepxray/1145141919810wulongjiadao/docs/16-最终商品清单.md

# 16 · 最终商品清单（2026-09-28 按实际下单修订）

> 本文是「乌龙驾到」的**实际已下单清单**，与 [08 BOM](08-BOM物料清单.md)、
> [18 采购记录](18-采购记录_20260928.md) 三者一致。
>
> ⚠️ **平台分叉说明**：原五轮迭代方案（差速 + RK3588 + 双 IMX219 + H723 + BTS7960）
> 与本次实际下单（麦轮全向 + K230D + 单 OV5640 + G474 + TB6612）差异是**平台级**的。
> 本文如实记录实际下单，并把冲突与待补项单独列出；平台取舍由
> [10 开发计划](10-开发计划与里程碑.md) W1 裁决。

---

## 1. 总览（实际口径）

| 项目 | 数值 | 限值 | 结论 |
|---|---|---:|---|
| **实付总价** | **¥751.01** | ¥2000 | ✅ 余量 ¥1248.99 |
| 商品合计 | ¥739.71 | — | — |
| 运费合计 | ¥11.30 | — | — |
| **总质量** | ⚠️ **待实测**（已核：电机 **680 g** + 麦轮 + 电池 ≈200 g） | 1500 g | 🔴 **逼近上限，必须称重** |
| 尺寸 | 待机械重构 | 250×200×180 | 麦轮底盘需重新建模 |

### ⚠️ 质量预算预警（2026-09-28 按官方规格核算）

| 项目 | 单件 | 数量 | 小计 |
|---|---:|---:|---:|
| MG513X 电机 | **0.17 kg** | 4 | **0.68 kg** |
| TB6612 四路驱动 D24A | 0.019 kg | 1 | 0.02 kg |
| 3S 2600 mAh 电池组 | ≈0.20 kg（估） | 1 | ≈0.20 kg |
| **以上小计** | | | **≈0.90 kg** |
| 余给底板/麦轮/推板/相机/主控/五金 | | | **仅 ≈0.60 kg** |

> 🔴 **电机一项就占 1500 g 上限的 45%。**
> 结构与承力件必须按「剩余 600 g」设计，**先称重再定结构**。

---

## 2. 实际商品清单

### 2.1 动力与驱动

| # | 商品 | 型号/规格 | 数量 | 单价 | 小计 |
|---|---|---|---|---:|---:|
| 1 | 直流减速电机 | **MG513X** 13 线霍尔编码器 + 加厚支架（**0.17 kg/台**，1:28，370 rpm 空载） | 4 | ¥42.00 | ¥168.00（**680 g**） |
| 2 | 电机驱动 | **TB6612 四路驱动 D24A** 带稳压版 ⚠️ | 1 | ¥60.70 | ¥60.70（19 g） |
| 3 | 轮子 | **60mm 麦克纳姆轮 ×4 + 6mm 联轴器** ⚠️ | 1 套 | ¥40.00 | ¥40.00（+¥3.80 运费） |

> ⚠️ **TB6612 的旧结论「必须换掉」已作废**：旧判断针对 JGB37-520（堵转 2–5 A）。
> 实际电机额定仅 0.36 A，TB6612 持续 1.2 A **在额定工况有余量**；
> 真正的风险是**堵转发热把 TB6612 推到热保护**，见
> [docs/17 §4.3](17-实际电机参数核对.md) 与 [TB6612_MG513X_规格.md](../hardware/electrical/TB6612_MG513X_规格.md)。

### 2.2 控制

| # | 商品 | 型号/规格 | 数量 | 单价 | 小计 |
|---|---|---|---|---:|---:|
| 4 | 主控 | **STM32G474VET6** 核心板 ⚠️ | 1 | ¥60.00 | ¥60.00 |

> ⚠️ 非 16 章原定的 STM32H723。
> ❌ **IMU 未购** —— 航向基准待补。

### 2.3 视觉

| # | 商品 | 型号/规格 | 数量 | 单价 | 小计 |
|---|---|---|---|---:|---:|
| 5 | 视觉平台 | **庐山派 Lite-K230D-CanMV（128M）** ⚠️ | 1 | ¥233.68 | ¥233.68 |
| 6 | 相机 | **OV5640 自动对焦** ⚠️ | 1 | ¥45.80 | ¥45.80（+¥5.00 运费） |

> ⚠️ 视觉平台是 K230D 128M，非 RK3588；相机**只有 1 支**，无下视相机。

### 2.4 电源

| # | 商品 | 型号/规格 | 数量 | 单价 | 小计 |
|---|---|---|---|---:|---:|
| 7 | 电池 | **12V 3S 2600mAh 锂电组** + 1.5A 充电器 🟡 | 1 | ¥58.00 | ¥58.00（待发货） |
| 8 | DC-DC | **3.3V/5V 多路电源模块** | 1 | ¥14.50 | ¥14.50（+¥2.50 运费） |

### 2.5 工具与线材（不计入质量预算）

| # | 商品 | 规格 | 数量 | 小计 |
|---|---|---|---|---:|
| 9 | 烧录器 PowerWriter LINK2 | PWLINK2 Lite | 1 | ¥18.90 |
| 10 | 洞洞板 | 双面喷锡 6×8cm | 2 | ¥6.10 |
| 11 | 杜邦线 | 15cm 三款 120 根 | 1 | ¥8.12 |
| 12 | RV 电线 | RV1 黑 5 米 | 1 | ¥6.80 |
| 13 | SM-2P 端子线 | 2.54mm 公母各 5 条 | 1 | ¥5.60 |
| 14 | 接线端子 | 二进六出 2 只装 | 1 | ¥4.80 |
| 15 | 面包板 + 跳线 | 400 孔 + 65 根 | 1 | ¥8.71 |

---

## 3. 后置补购清单（动力/视觉验证后再购）

| 物料 | 原因 | 购入时机 |
|---|---|---|
| **激光模组 650nm ≤1mW** | C9 强制搭载、C16 超标直接判负 | 动力验证后（赛题强制，赛前装上即可） |
| 激光限流电阻 + 安装座 | 配套激光 | 动力验证后 |
| **IMU（ICM-20602 已定）** | 航向基准；SPI2 接线见 03 §4；四轮论证见 10 §0 | 视觉验证后，按漂移判据触发 |
| 下视相机 | 双相机方案的「下视视觉伺服」失效 | 视觉验证后，按推入精度触发 |
| 低压报警器 / XT60 / 保险丝 | 电源保护 | 🟡 建议补 |
| 结构五金（M3 热熔铜螺母等） | 麦轮底盘机械重构后定 | 🟡 后置 |

---

## 4. 与原五轮迭代的差异（快照）

| 项 | 原方案（16 章历史） | 实际下单 | 说明 |
|---|---|---|---|
| 底盘 | 差速 + φ65 橡胶轮 | 麦轮 60mm ×4 | 00 判断二曾否决麦轮 |
| 驱动 | BTS7960/IBT-2 | TB6612 | 曾明确「不要买」 |
| 主控 | STM32H723 | STM32G474VET6 | RAM 大幅下降 |
| 视觉 | RK3588 | K230D 128M | 算力下沉 |
| 相机 | IMX219 ×2 + 备用 | OV5640 ×1 | 帧率/数量双降 |
| 电池 | 3S 1500mAh LiPo | 3S 2600mAh 锂电组 | 容量更大、更安全 ✅ |
| 下载器 | ST-Link V2 | PWLINK2 | 兼容替代 ✅ |

---

## 5. 一句话总结

> 实付 **¥751.01**，是一套**低成本全向轮小车 kit**；预算余量充足，但**平台硬件与既有设计
> 文档分叉明显**，且**激光模组、IMU、下视相机三大件待补**。下一步以
> [10 开发计划](10-开发计划与里程碑.md) W1 的「平台裁决」为准，裁决后统一回写全部 docs。
