sheepxray/1145141919810wulongjiadao/(list of files, cad)

Other CAD files:
hardware/mechanical/sketchup/底盘_一体_v11.skp
