sheepxray/1145141919810wulongjiadao/firmware/stm32/wulong_fw/wulong_fw.ioc

Mcu.UserName=STM32G474VETx
PA0.Signal=S_TIM2_CH1
PA1.Signal=S_TIM2_CH2
PA10.Signal=S_TIM1_CH3
PA11.Signal=S_TIM1_CH4
PA2.Signal=USART2_TX
PA3.Signal=USART2_RX
PA4.Signal=ADC2_IN17
PA6.Signal=S_TIM3_CH1
PA7.Signal=S_TIM3_CH2
PA8.Signal=S_TIM1_CH1
PA9.Signal=S_TIM1_CH2
PB0.GPIO_Label=AIN1
PB0.Signal=GPIO_Output
PB1.GPIO_Label=AIN2
PB1.Signal=GPIO_Output
PB10.GPIO_Label=CIN1
PB10.Signal=GPIO_Output
PB11.GPIO_Label=CIN2
PB11.Signal=GPIO_Output
PB12.GPIO_Label=IMU_CS
PB12.Signal=GPIO_Output
PB13.Signal=SPI2_SCK
PB14.Signal=SPI2_MISO
PB15.Signal=SPI2_MOSI
PB3.GPIO_Label=DIP4
PB3.Signal=GPIO_Input
PB4.GPIO_Label=DIP1
PB4.Signal=GPIO_Input
PB5.GPIO_Label=DIP2
PB5.Signal=GPIO_Input
PB6.Signal=S_TIM4_CH1
PB7.Signal=S_TIM4_CH2
PB8-BOOT0.GPIO_Label=BUZZER
PB8-BOOT0.Signal=GPIO_Output
PB9.GPIO_Label=IMU_INT
PB9.Signal=GPXTI9
PC12.GPIO_Label=DIN2
PC12.Signal=GPIO_Output
PC13.GPIO_Label=LED_SELF
PC13.Signal=GPIO_Output
PC4.Signal=USART1_TX
PC5.Signal=USART1_RX
PC6.GPIO_Label=STBY
PC6.Signal=GPIO_Output
PC7.GPIO_Label=DIP3
PC7.Signal=GPIO_Input
PD2.GPIO_Label=DIN1
PD2.Signal=GPIO_Output
PE2.Signal=S_TIM20_CH1
PE3.Signal=S_TIM20_CH2
PE4.GPIO_Label=BIN1
PE4.Signal=GPIO_Output
PE5.GPIO_Label=BIN2
PE5.Signal=GPIO_Output
