sheepxray/1145141919810wulongjiadao/firmware/stm32/wulong_fw/Core/Inc/main.h

#define WULONG_FW_TAG  "wulong-fw 2026-10-23 k1-vision"
#define BIN1_Pin GPIO_PIN_4
#define BIN1_GPIO_Port GPIOE
#define BIN2_Pin GPIO_PIN_5
#define BIN2_GPIO_Port GPIOE
#define LED_SELF_Pin GPIO_PIN_13
#define LED_SELF_GPIO_Port GPIOC
#define AIN1_Pin GPIO_PIN_0
#define AIN1_GPIO_Port GPIOB
#define AIN2_Pin GPIO_PIN_1
#define AIN2_GPIO_Port GPIOB
#define CIN1_Pin GPIO_PIN_10
#define CIN1_GPIO_Port GPIOB
#define CIN2_Pin GPIO_PIN_11
#define CIN2_GPIO_Port GPIOB
#define IMU_CS_Pin GPIO_PIN_12
#define IMU_CS_GPIO_Port GPIOB
#define STBY_Pin GPIO_PIN_6
#define STBY_GPIO_Port GPIOC
#define DIP3_Pin GPIO_PIN_7
#define DIP3_GPIO_Port GPIOC
#define DIN2_Pin GPIO_PIN_12
#define DIN2_GPIO_Port GPIOC
#define DIN1_Pin GPIO_PIN_2
#define DIN1_GPIO_Port GPIOD
#define DIP4_Pin GPIO_PIN_3
#define DIP4_GPIO_Port GPIOB
#define DIP1_Pin GPIO_PIN_4
#define DIP1_GPIO_Port GPIOB
#define DIP2_Pin GPIO_PIN_5
#define DIP2_GPIO_Port GPIOB
#define BUZZER_Pin GPIO_PIN_8
#define BUZZER_GPIO_Port GPIOB
#define IMU_INT_Pin GPIO_PIN_9
#define IMU_INT_GPIO_Port GPIOB
#define IMU_INT_EXTI_IRQn EXTI9_5_IRQn
