sheepxray/1145141919810wulongjiadao/(commit log)

2026-09-25 光电赛智能车方案：设计文档与可运行校核工具
    赛题：第十五届全国大学生光电设计竞赛 赛题1 智能车光电象棋对抗
    约束：只有3D打印 / 预算≤2000元 / K230视觉 / 3个月
    方案要点：
    - 差速底盘 + 带侧裙盒式推板（车体做窄150mm、推板做宽195mm）
    - 双卷帘快门相机（前视15°搜棋子与近场测墙、下视60°停车读字）
    - STM32G431 运动主控 + K230 视觉协处理器，单串口耦合
    - 定位：航迹推算 + 撞墙重定位 + 近场测墙
    - 全重987g / 总价¥807，均有余量
    文档：docs/00-11（赛题解读、总体、机械、电控、视觉、定位、电源、
    决策策略、BOM、风险登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
2026-09-25 加入 30 FPS 硬指标：帧率预算、真机实测工具与文档
    需求：保证 30 FPS 帧处理速度。
    关键发现（与直觉相反，且改变了既有设计）：
    1. 第一道卡口不是算力，是传感器读出带宽
    OV5640 全分辨率 2592x1944 **只有 15 fps**，硬件上就达不到 30 FPS。
    必须降到 720p（60 fps）采集，给处理端留 2 倍余量。
    2. 检测棋子不需要高分辨率
    720p+scale 模式：2m 处棋子 22px、3m 处 15px，够用。
    搜索要的是"看宽"而非"看清"，用 scale 而非 crop 模式。
    3. crop 模式有个陷阱：汉字像素数恒为 92.4，看似"越高越清晰"，
    但视场会同步收窄 —— 320px c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
2026-09-25 第1轮迭代：电源与电流预算（电源先行）
    需求：电控电流过大，需先明确电源再选型。
    核心发现：真正的风险不是电池，是电机烧毁
    - 正常行驶仅 0.50A（6W），堵转 5.0A（60W），差 10 倍
    - JGB37-520 堵转发热 30W，安全电流仅 1.04A
    - 持续堵转 86 秒后绕组烧毁，而比赛单场 180 秒
    - 参数敏感性验证：无论热参数怎么取，烧毁时间都在 20-160s 量级
    结论：解法是限流，不是换更大的电池
    - 新增 INA240 电流采样 x2（¥12 x2）—— 限流必需
    - 限流到 1.0A 后电机可长期堵转不烧，直接消除风险
    电池选型（按峰值压降而非容量）
    - 三层判据：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
2026-09-25 第2轮迭代：主控与算力平台（诊断瓶颈在CPU侧而非NPU侧）
    需求：STM32G431主板太弱，需要更强的主板。
    核心发现：瓶颈的位置和直觉相反
    1. G431 跑控制环只占 2% CPU，它不是瓶颈
    - 1kHz 双环PID + EKF 合计 3.6 M 指令/秒
    - M4F@170MHz 轻松胜任，F103 也只要 15.9%
    2. 真正的瓶颈是视觉平台的 CPU，不是 NPU
    - 图像预处理（降采样/色彩转换/阈值/连通域）跑在 CPU 上
    - K230 的 CPU 仅 800 MOPS，RK3588 有 20000 MOPS（25倍）
    - 但两者 NPU 都是 6 TOPS —— 这解释了"NPU够强却跑不动1080p@30"
    3. G431 的真正约束是内存不是算力
    - 当前功能需 RAM 6.8KB /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
2026-09-25 第3轮迭代：1080p@30 视觉管线
    需求：采集处理需要 1080p@30 FPS。
    核心发现：达成 1080p@30 的关键不是更强的 NPU，而是把降采样卸载到 RGA 硬件
    1. 传感器要有"余量"而非"支持"
    - OV5640 的 1080p 恰好 30fps，零余量 —— 实际会掉到 25-28
    - IMX219 是 1080p@60，2x 余量，仅贵 ¥27/台
    - 这 ¥54（两台）买的是"帧率不会掉到 30 以下"的确定性
    2. ★ 降采样必须用 RGA 硬件，不能用 CPU
    - CPU 逐像素降采样 1080p->540p 要 22ms，占 66% 帧预算
    - RGA 硬件只要 1.8ms，快 12 倍
    - 若用 CPU：关键路径 36.1ms -> 28 FPS，不达标
    - 这印证第2轮结论：瓶颈在 CP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
2026-09-25 第4轮迭代：字符识别与优先级算法
    需求：需要对字进行识别处理，然后根据算法计算优先级。
    核心问题：现有打分函数假设分值已知，但识别实际输出的是概率分布。
    本轮补上这个缺口。
    三个关键设计决策：
    1. ★ 用期望值而不是 argmax
    - argmax 丢掉置信度信息
    - 场景"犹豫：车 or 炮" {车:0.55, 炮:0.44}
    argmax 说"9分"（高估4分），期望值说"7.19分"（诚实反映风险）
    - 期望值把不确定性量化进了分值
    2. ★ 加不确定性惩罚
    - 用分值方差衡量判断的不确定程度
    - 方差大（可能9分也可能4分）-> 降权
    - 效果：让"确定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
    [piece_value.py]
2026-09-25 第5轮迭代（最终）：SketchUp 模型 + 最终商品清单
    需求：使用 SketchUp 2026 建模，帮我划模型图；最后一次迭代后列出商品清单。
    交付1：参数化 SketchUp 模型生成器
    - tools/sketchup_model.py 生成 Ruby 脚本，SketchUp 中粘贴即建模
    - 为什么参数化：五轮迭代中尺寸改过多次（车宽/推板/主控/相机），
    参数化后改一个数字即可重新生成，不用手工改模型
    - 模型含 20 个组：三层板/轮系/电机/盒式推板(含侧裙)/相机立柱/双相机/电子件占位
    - 附带终端三视图与尺寸自洽性校验
    ★ 尺寸校核发现真实缺陷：
    原模型只算到上层板 z=100mm，总高报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
2026-09-25 第5轮迭代（最终）：SketchUp 模型 + 最终商品清单
    需求：使用 SketchUp 2026 建模帮我划模型图；最后一次迭代后列出商品清单。
    交付1：参数化 SketchUp 模型生成器（tools/sketchup_model.py）
    - 生成 Ruby 脚本，SketchUp 中粘贴即建模
    参数化后改一个数字即可重新生成，不用手工维护会过时的死图
    - 附带终端三视图输出与尺寸自洽性校验
    原模型只算到上层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
2026-09-25 新增 GitHub Pages 站点：19 个页面 + 自动部署
    需求：把这些东西做成 GitHub Pages。
    交付：
    - tools/build_site.py 静态站点生成器
    - .github/workflows/pages.yml GitHub Actions 自动部署
    - site/ 已加入 .gitignore（构建产物由 CI 重建）
    站点结构（19 页）
    - 首页：最终指标 / 五轮迭代 / 反直觉发现 / 待确认事项 / 自测捕获的缺陷
    - 工具页：12 个脚本一览 + 缺陷表 + 运行环境
    - 17 篇文档按「开始 / 五轮迭代 / 系统设计 / 项目管理」四组编排
    为什么自己写生成器而不是 MkDocs
    MkDocs Material 依赖链长（mkdocs/material/pygments/pymdownx...），
    当前网络环境安装耗时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
2026-09-25 站点：workflow 启用 enablement 自动尝试开启 Pages，README 标注阻塞点
    首次 CI 运行结果：Build site 与 Verify internal links 均通过，
    仅 configure-pages 因 Pages 未启用而失败（API 查 /pages 返回 404）。
    - workflow 加 enablement: true，尝试自动启用
    - README 明确标注这一步可能需人工完成及具体路径
2026-09-26 按实际电机参数更新：核对、失效标注与选型复核
    用户提供实际电机参数：12V / 1:100 / 空载300rpm 30mA /
    额定240rpm 200mA 0.5kgf·cm / 堵转500mA 4kgf·cm
    ★ 发现两处问题
    1. 数据手册自身矛盾 2.2 倍
    电气反推（Kt = (V-I0*R)/w0 = 0.359 N·m/A）：
    堵转转矩 = Kt x 0.5A = 1.83 kgf·cm
    但标称 = 4.00 kgf·cm
    而"额定转矩 0.5"与推算 0.66 吻合 -> 电气模型可信，堵转转矩存疑
    两种自洽读法：
    A（按500mA） 24ohm / 0.50A / 1.83kgf·cm
    B（按4kgf·cm）11ohm / 1.09A / 4.00kgf·cm
    ★ 30 秒可定论：万用表量线圈电阻（转子转多点避开换向器死区）
    2. ★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
    [build_site.py, power_budget.py]
2026-09-28 按实际下单修订文档；新增采购记录与 ICM20602 驱动参考
    实际下单硬件与五轮迭代方案存在**平台级差异**（用户/协作者提供）：
    底盘 差速 -> 麦克纳姆轮 60mm x4
    视觉 RK3588+双IMX219 -> K230D 128M + 单 OV5640
    主控 STM32H723 -> STM32G474VET6
    驱动 BTS7960 -> TB6612 四路
    电机 JGB37-520 x2 -> MG513X 13线霍尔 x4
    电池 3S 1500mAh -> 12V 2600mAh 锂电组
    docs/16 已改写为**实际下单口径**（实付 ¥751.01 / 13 单 / 16 明细行），
    并如实标注平台分叉，把 9 处冲突单列，平台取舍留待开发计划 W1 裁决。
    docs/00-15 做同步修订。
    新增 docs/18-采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
2026-09-28 站点补上 docs/18；新增 NAV 覆盖防呆检查；ICM20602 移植提示
    ★ 修复：docs/18 未编入站点 NAV，整页被静默漏掉
    - 现象：CI 构建成功、链接全有效、但 /18.html 返回 404
    - 原因：上次只把 17 加进了 NAV，18 加入仓库后没同步
    - 这类遗漏人眼发现不了（"少一页"没有报错），必须脚本拦截
    - 故新增 check_nav_coverage()：docs/ 中有文档未编入 NAV 即报错
    已双向验证：正常 exit=0；临时移除 18 后 exit=1
    - 同时修掉一个假警报：NAV 中的 index 是首页占位（无对应 md），
    不应报"引用不存在的文件"
    ★ firmware/stm32/README：补 ICM20602 参考代码的移植警告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
    [build_site.py]
2026-09-28 TB6612 D24A × MG513X 规格核对；修正电机口径；清理临时文件
    新增 hardware/electrical/TB6612_MG513X_规格.md（唯一权威口径）
    - 资料源：WHEELTEC D24A 原理图 V1.1 + 芯片原厂手册 + 随货手册
    - 本地存档 120.8MB 第三方资料不入库（已排除 3 个视频共 1658MB）
    ★ 该文档纠正了此前两处错误
    1. 我此前按 **TB6612 裸芯片**（1.2A/通道）分析，
    实际板是 **四路带稳压版 D24A** —— 板上集成 5V/3.3V 稳压
    （RT8279 + RT9013），且带 **65°C 整板过温保护**。
    风险因此变了：过温会**同时切断 5V/3.3V 轨**，
    把 STM32 与 K230D 一起断电，不只是电机失驱动。
    2.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
    [power_budget.py]
2026-09-28 新增驱动校核与参数一致性工具；器件资料纳入站点
    新增工具（2 个，均可运行）
    tools/drive_check.py —— 4×MG513X + TB6612 四路 D24A 驱动校核
    车速（φ60 麦轮，空载/额定/横移）、编码器分辨率、牵引力、
    四轮电流、驱动发热与 65°C 保护风险、质量预算
    权威参数源：hardware/electrical/TB6612_MG513X_规格.md
    tools/motor_consistency.py —— MG513X 手册四参数一致性核对
    用直流电机线性模型（含空载电流）检验手册是否自洽
    结论（与规格文档一致）：
    读法 A（取信额定点 300rpm/1kgf·cm/0.36A）
    -> 反推空载 386rpm（手册 370，偏差 4.2%）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
2026-09-28 文档一致性审计：修正漏改的运动学/架构；历史档案加适用性标注
    需求：对所有文档做审计，旧方案已弃用，统一到新方案
    （麦轮全向 + K230D + 单 OV5640 + G474 + TB6612）
    新增 tools/audit_docs.py（一致性审计工具）
    - 扫描全部文档中仍在引用旧方案的**非对照语境**位置
    - 区分三类：历史档案（可保留）/ 对照表（正确）/ 真漏改（需修）
    - ★ 开发中修正了自身两个缺陷：
    1. 初版「有顶部标注就跳过整篇」是错的 —— 顶部标注不代表正文无漏改
    （用插入假漏改的反向测试发现，当时审计报 0 属自欺）
    2. 对照语境正则过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
    [audit_docs.py]
2026-09-28 给四个旧平台工具加运行时失效警告
    问题：mass_budget / power_budget / compute_budget / vision_pipeline
    基于旧方案计算，但**运行时没有任何提示**，团队会拿到错误数字
    （例如 mass_budget 报 987g，实际仅电机就 680g）
    处置：加 _warn_obsolete()，每次运行向 stderr 输出醒目警告
    | 工具 | 警告内容 |
    |---|---|
    | mass_budget | 按 2 电机差速算，实际麦轮 4 电机 |
    | power_budget | 基于 JGB37-520 + BTS7960，实际 MG513X + TB6612 |
    | compute_budget | 推荐 RK3588+H723，实际相反（K230D+G474） |
    | vision_pipeline | 假设 RK3588 的 RGA，**K230D 无此硬件** |
    同时加 stdout/stderr UTF-8 配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
    [compute_budget.py, mass_budget.py, power_budget.py, vision_pipeline.py]
2026-10-01 实机验证收敛：新增算法总方案、G474 固件工程、PCB 库与接线图
    新增 docs/19-比赛完整算法方案（2026-10-01 定稿）
    - 按实际硬件收敛的可执行算法总方案，11 节
    - 综合 00/03/04/05/07/11/15 各文档
    - 与旧文档的差异全部来自 2026-10-01 的实机验证结论
    新增 firmware/stm32/wulong_fw（STM32G474 工程）
    - Core：main / wulong_control / tim / spi / usart / adc / dma / gpio
    - FreeRTOS 中间件、CMSIS、STM32G4xx HAL 驱动
    - 含 .ioc 与 MDK-ARM 工程配置
    新增 hardware/pcb/library（KiCad 器件库）
    - wulong_foundation 符号库 + 封装库
    - 含器件核对表、最小验证工程、验证记录（2026-09-29）
    新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
    [引脚分配表_pinout.csv]
2026-10-01 固件本地构建与发布：一键脚本 + 说明文档
    需求：每次都本地构建然后上传 releases
    方案：本地 Keil 构建 + 打包 + 上传 GitHub Release
    （放弃 CI 构建，原因是硬性技术缺口 —— 见下）
    新增 firmware/stm32/wulong_fw/build_release.bat
    - 一键：清理 -> Keil 构建 -> 生成 hex/bin/elf/map -> SHA256 -> 发布说明
    - 版本号自动取 git tag，可显式传参
    - ★ 已实测跑通：Build OK / 0 errors 0 warnings
    产物 Code=35400 RO-data=832 RW-data=252 ZI-data=22196
    hex 102672B / bin 36484B / elf 1357112B / map 396805B
    校验和独立复算一致
    新增 firmware/stm32/BUILD_AND_RELEASE.md
    - 构建/上传/烧录全流程
    -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
2026-10-27 firmware: 新增 ICM-20602 IMU 驱动与 K230 视觉链路脚本，更新固件/标定文档
2026-10-27 docs/hardware/tools: 校赛动员节点、完整算法方案、接线标注与工具同步；dist/ 纳入忽略
2026-10-27 tools: 新增 SketchUp 直连桥（Plugins TCP 扩展 + 客户端），支持外部驱动建模
2026-10-27 mechanical: 归档权威底盘模型 底盘_一体_v11.skp 并纳入发布资产
2026-10-27 k230: 归档钱包 YOLOv8n 训练/转换/部署脚本，发布流程纳入 K230 训练资产
