sheepxray/1145141919810wulongjiadao/(notices)

Notices in the files:
firmware/stm32/reference/icm20602/software_spi/Src/SEEKFREE_ICM20602.c:
Copyright (c) 2018,Öð·É¿Æ¼¼
All rights reserved.
firmware/stm32/wulong_fw/Core/Src/main.c:
Copyright (c) 2026 STMicroelectronics.
This software is licensed under terms that can be found in the LICENSE file
firmware/stm32/reference/icm20602/software_iic/Src/main.c:
(C) COPYRIGHT STMicroelectronics *****END OF FILE
